luckyowl20/cert_rocket/gpt_context/outputs/footprint_assignment/comparator_land.png

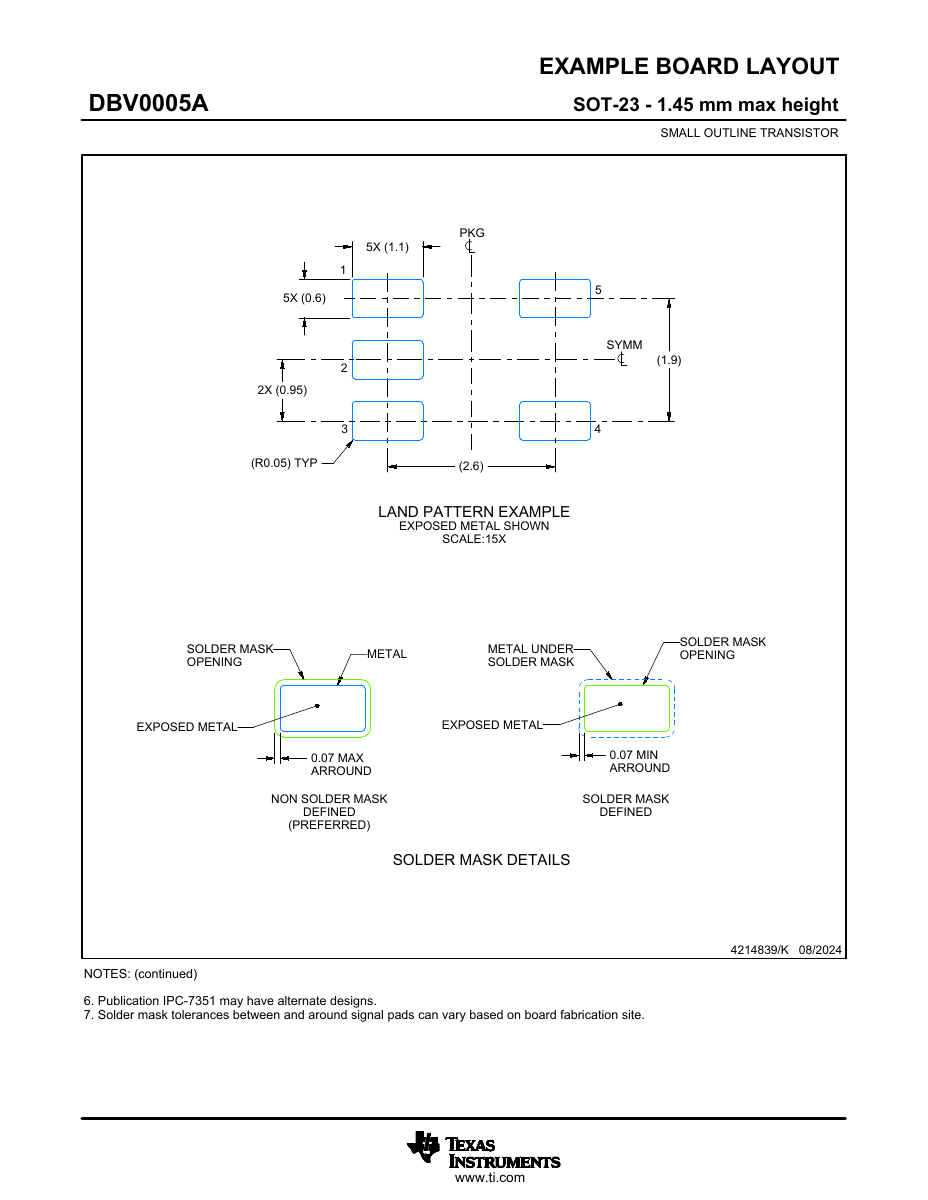
gpt_context/outputs/footprint_assignment/comparator_land.png
