luckyowl20/cert_rocket/gpt_context/outputs/footprint_assignment/d4_dims.png

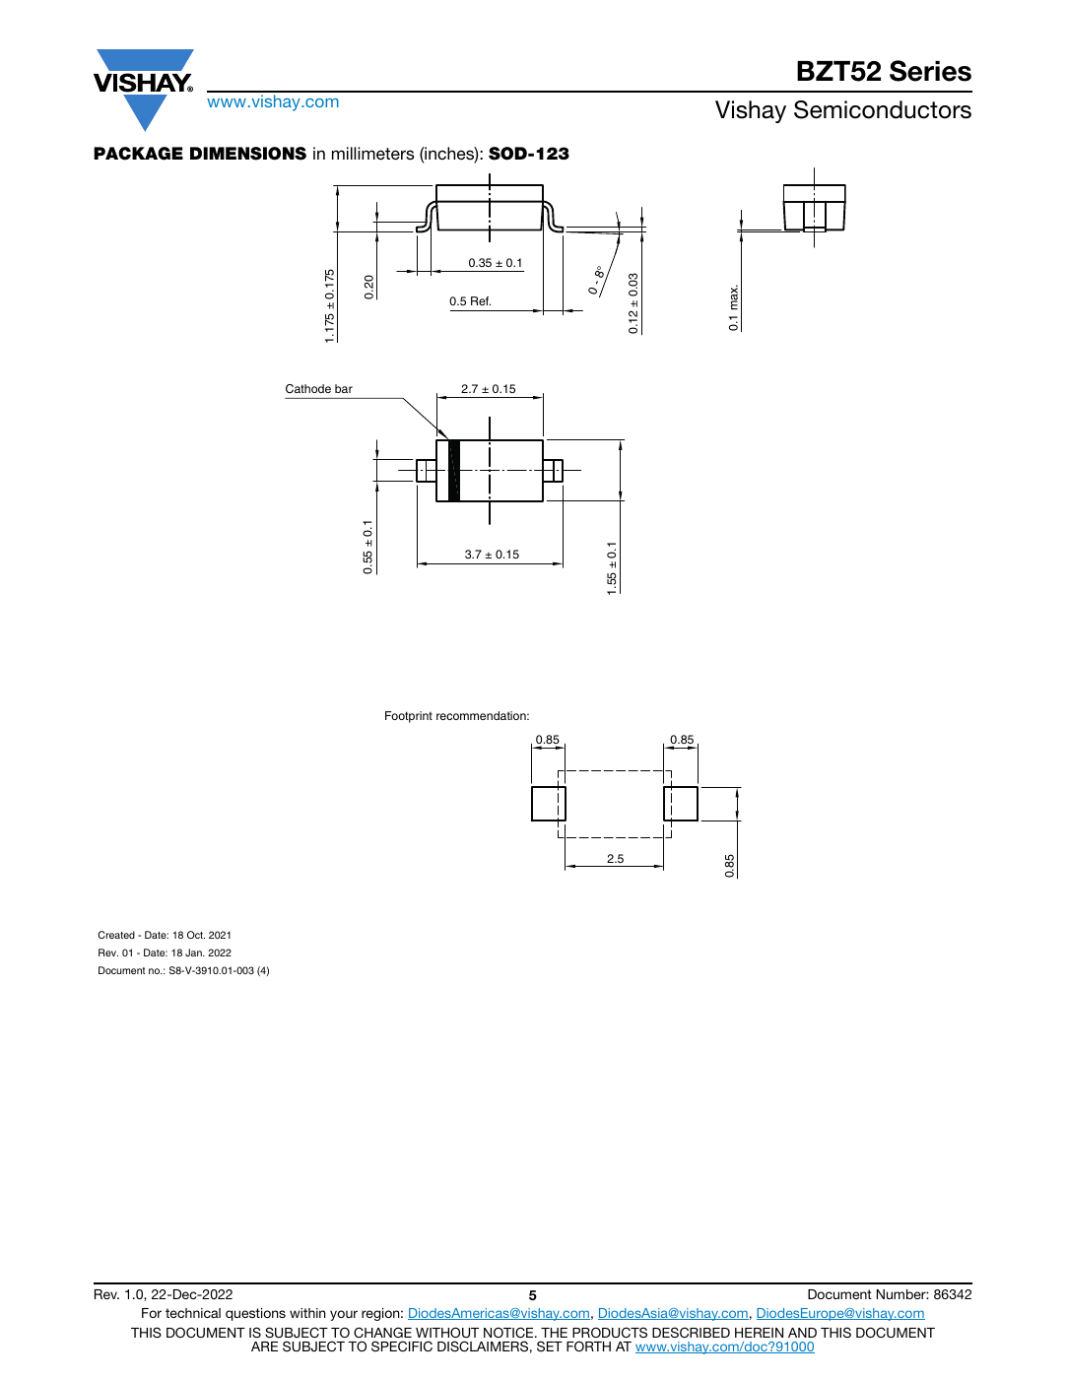
gpt_context/outputs/footprint_assignment/d4_dims.png
