luckyowl20/cert_rocket/gpt_context/outputs/footprint_assignment/d4_package.png

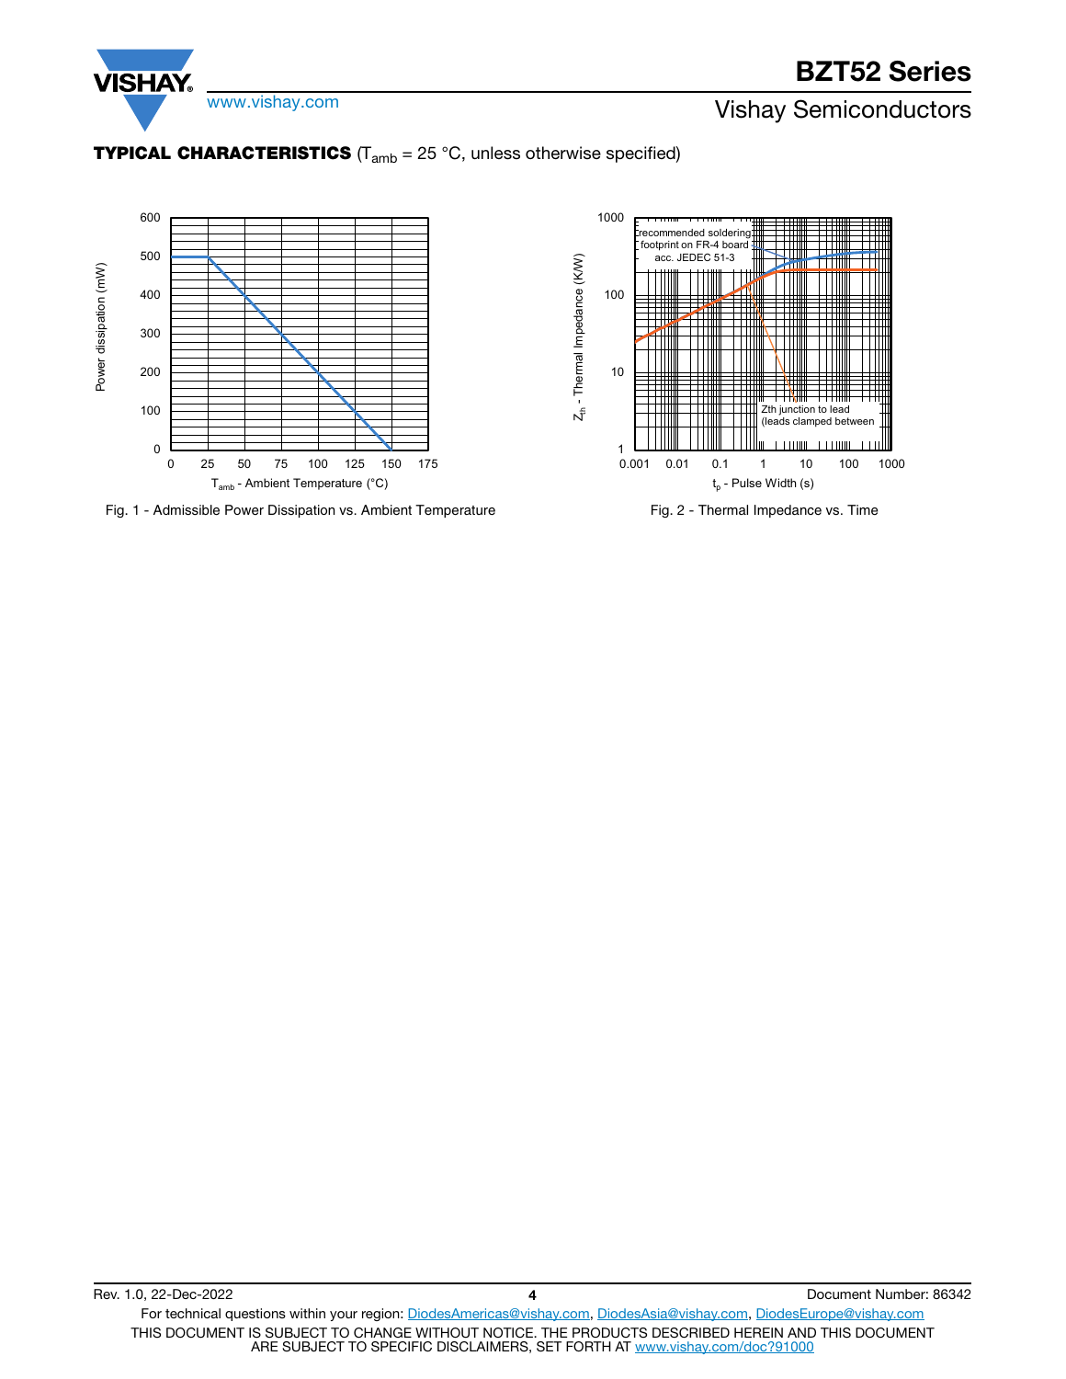
gpt_context/outputs/footprint_assignment/d4_package.png
