luckyowl20/cert_rocket/gpt_context/outputs/footprint_assignment/inspection_iso.png

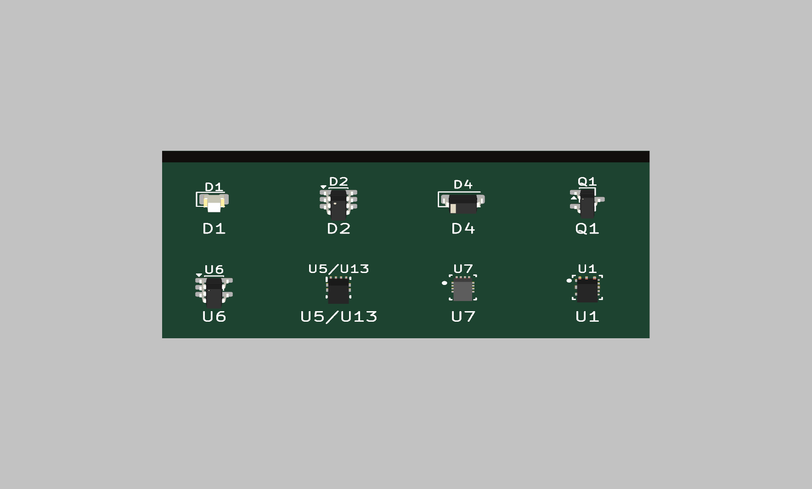
gpt_context/outputs/footprint_assignment/inspection_iso.png
