luckyowl20/cert_rocket/gpt_context/outputs/footprint_assignment/inspection_top.png

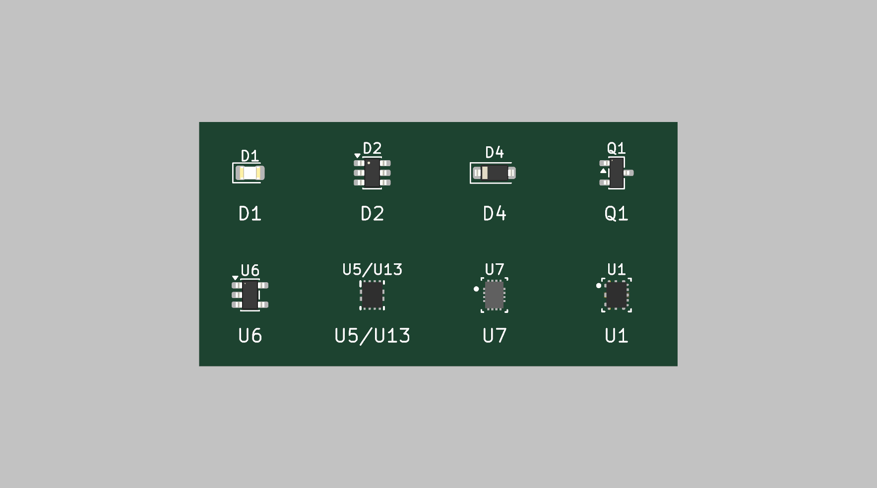
gpt_context/outputs/footprint_assignment/inspection_top.png
