luckyowl20/cert_rocket/gpt_context/outputs/footprint_assignment/led_package.png

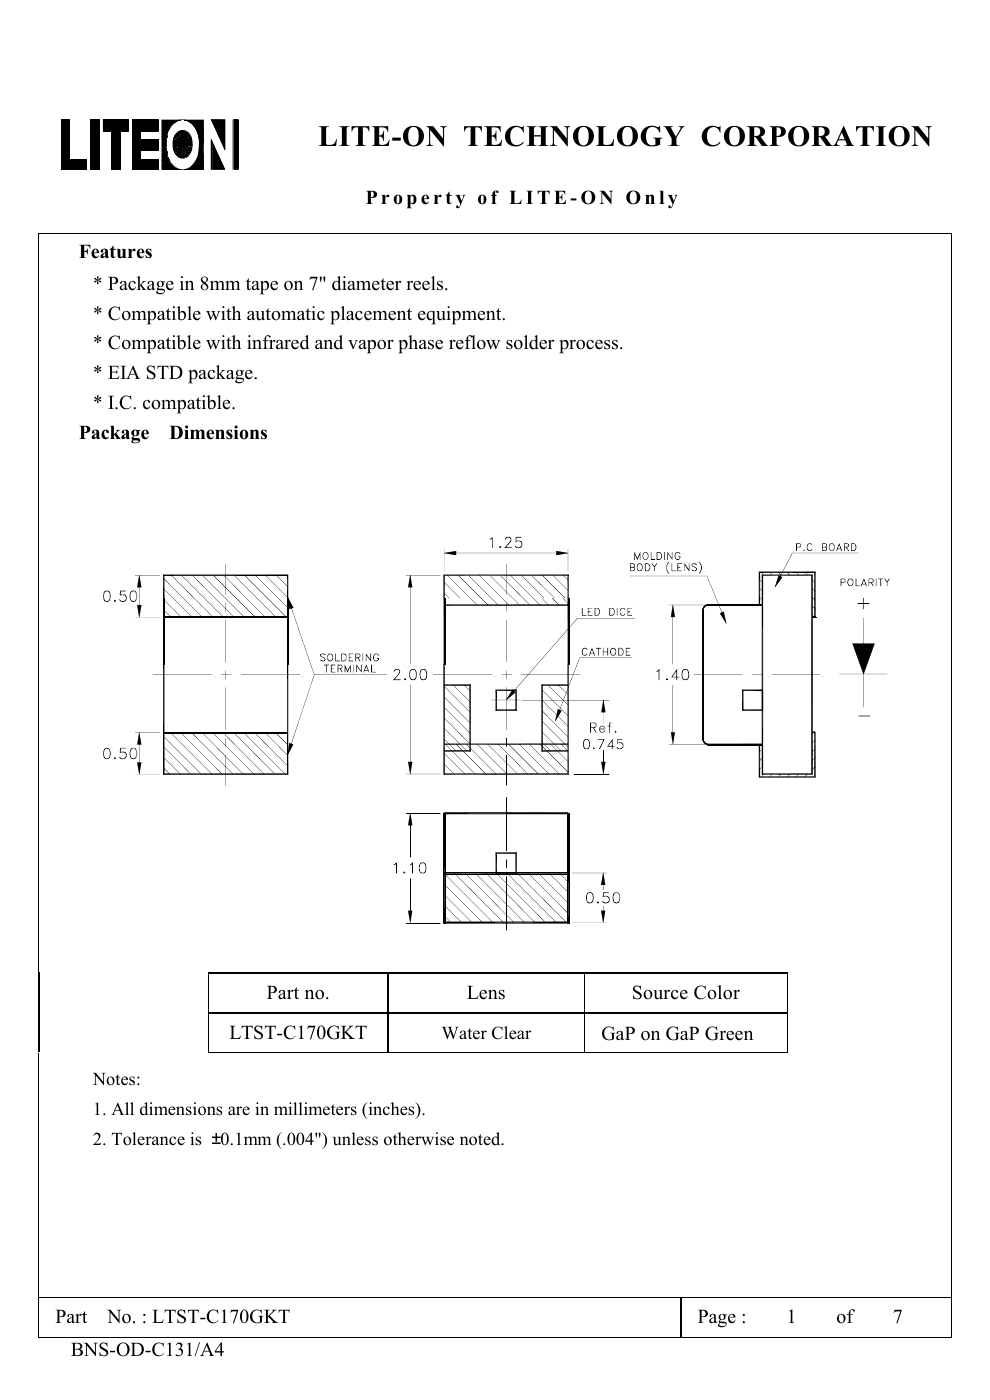
gpt_context/outputs/footprint_assignment/led_package.png
