luckyowl20/cert_rocket/gpt_context/outputs/footprint_assignment/rak_copper.png

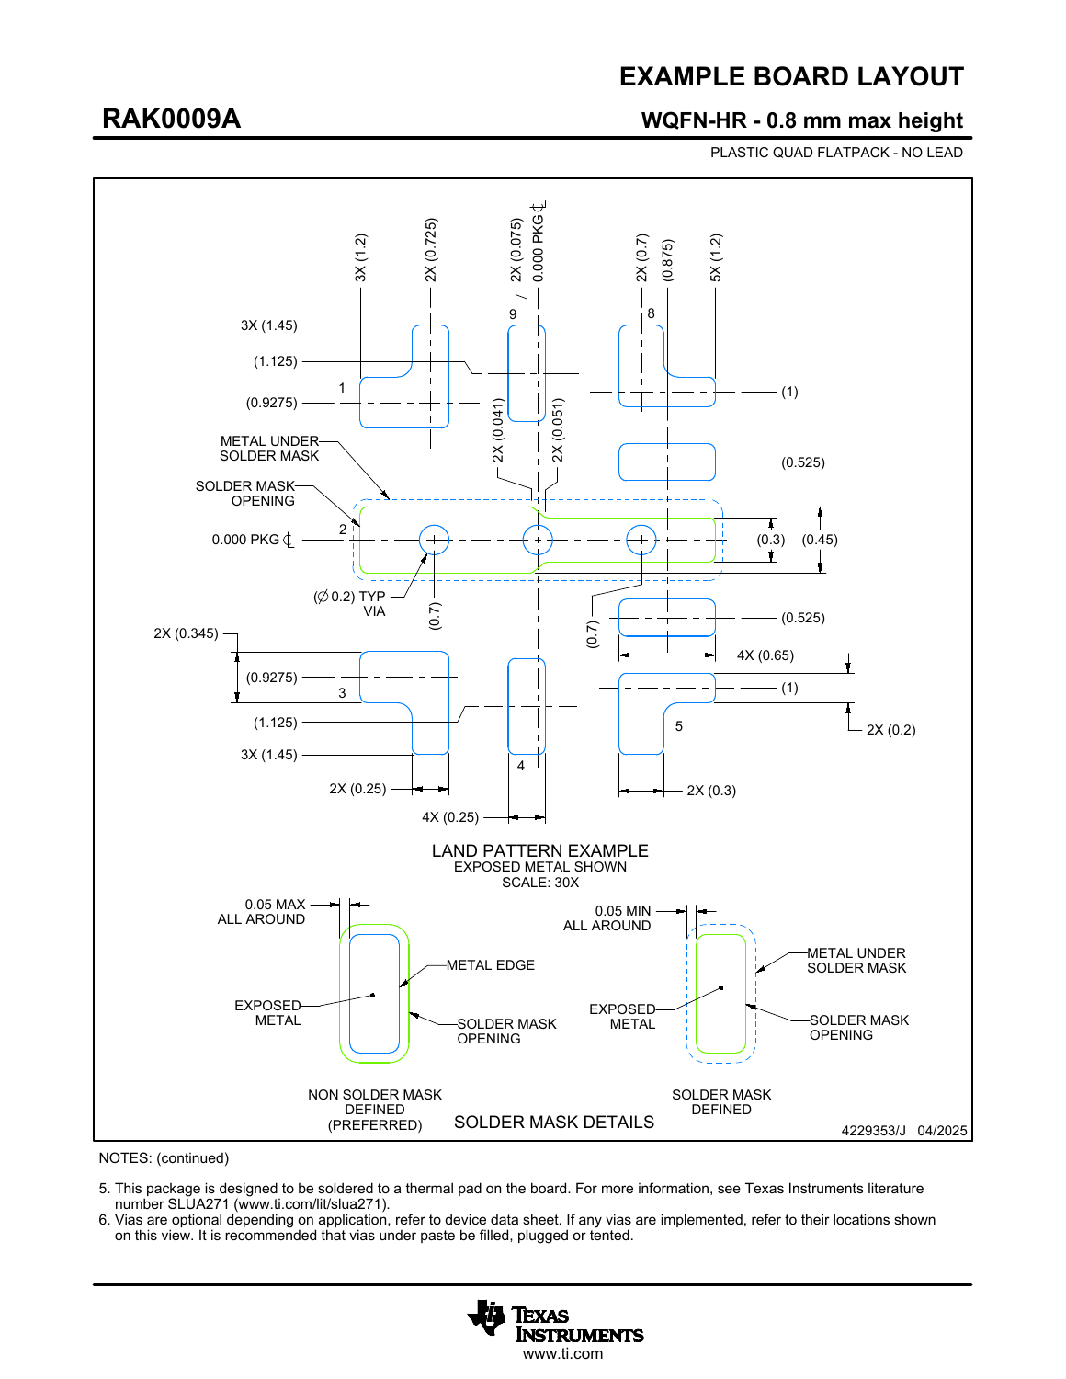
gpt_context/outputs/footprint_assignment/rak_copper.png
