luckyowl20/cert_rocket/gpt_context/outputs/footprint_assignment/tmux_land.png

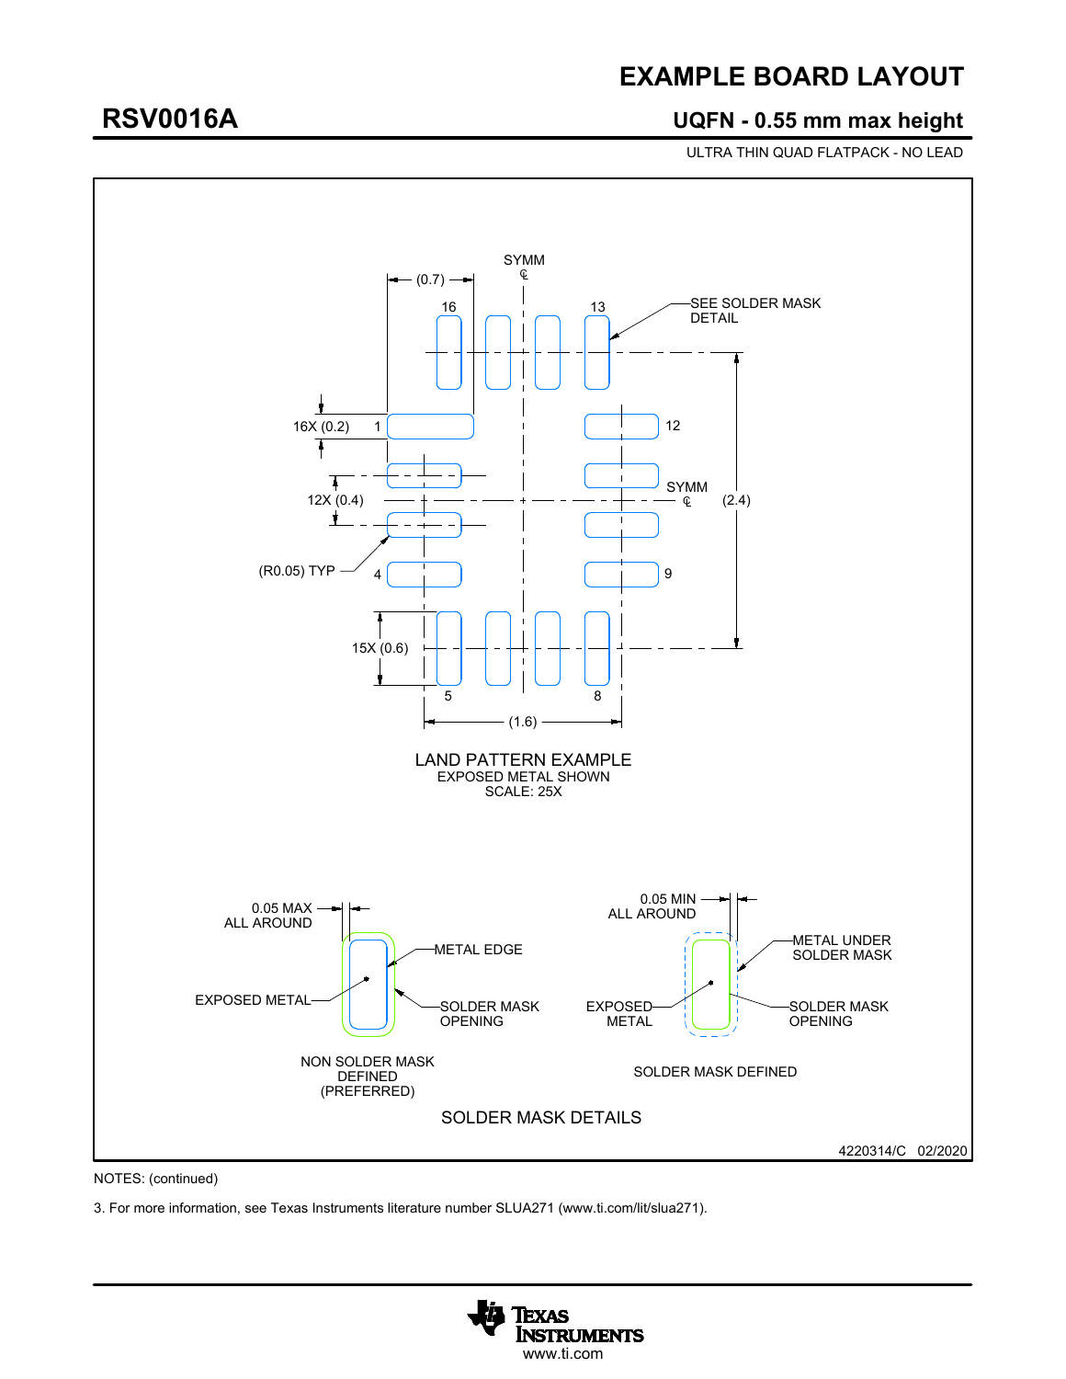
gpt_context/outputs/footprint_assignment/tmux_land.png
