luckyowl20/cert_rocket/gpt_context/outputs/footprint_assignment/tps_land.png

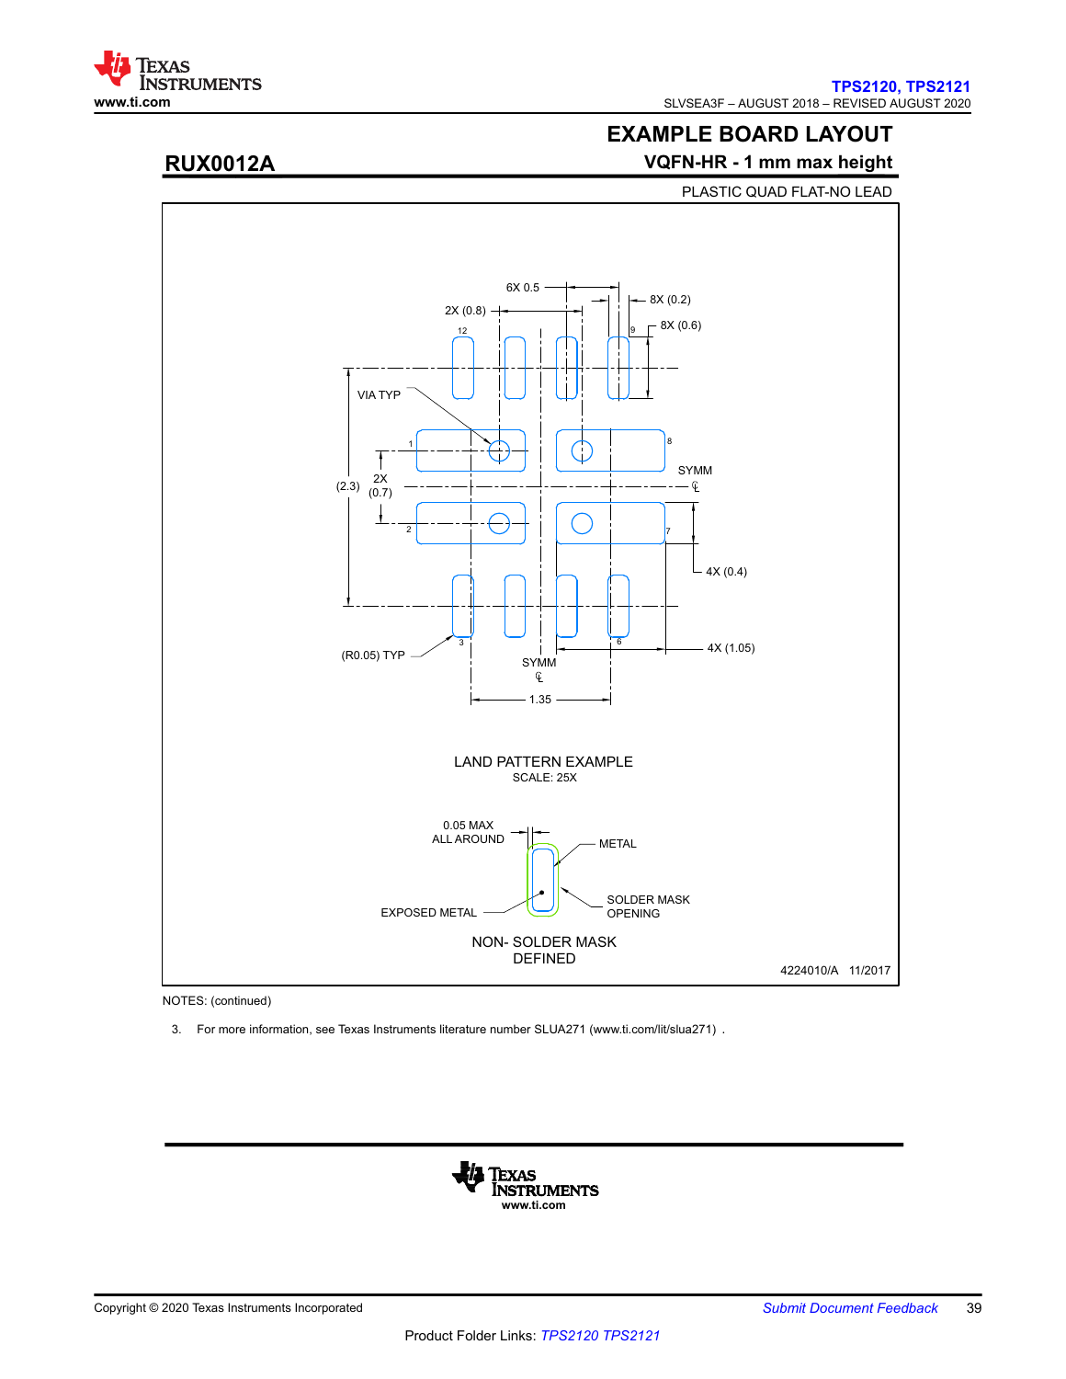
gpt_context/outputs/footprint_assignment/tps_land.png
