luckyowl20/cert_rocket/gpt_context/outputs/logic_power/logic_power_single_sheet.png

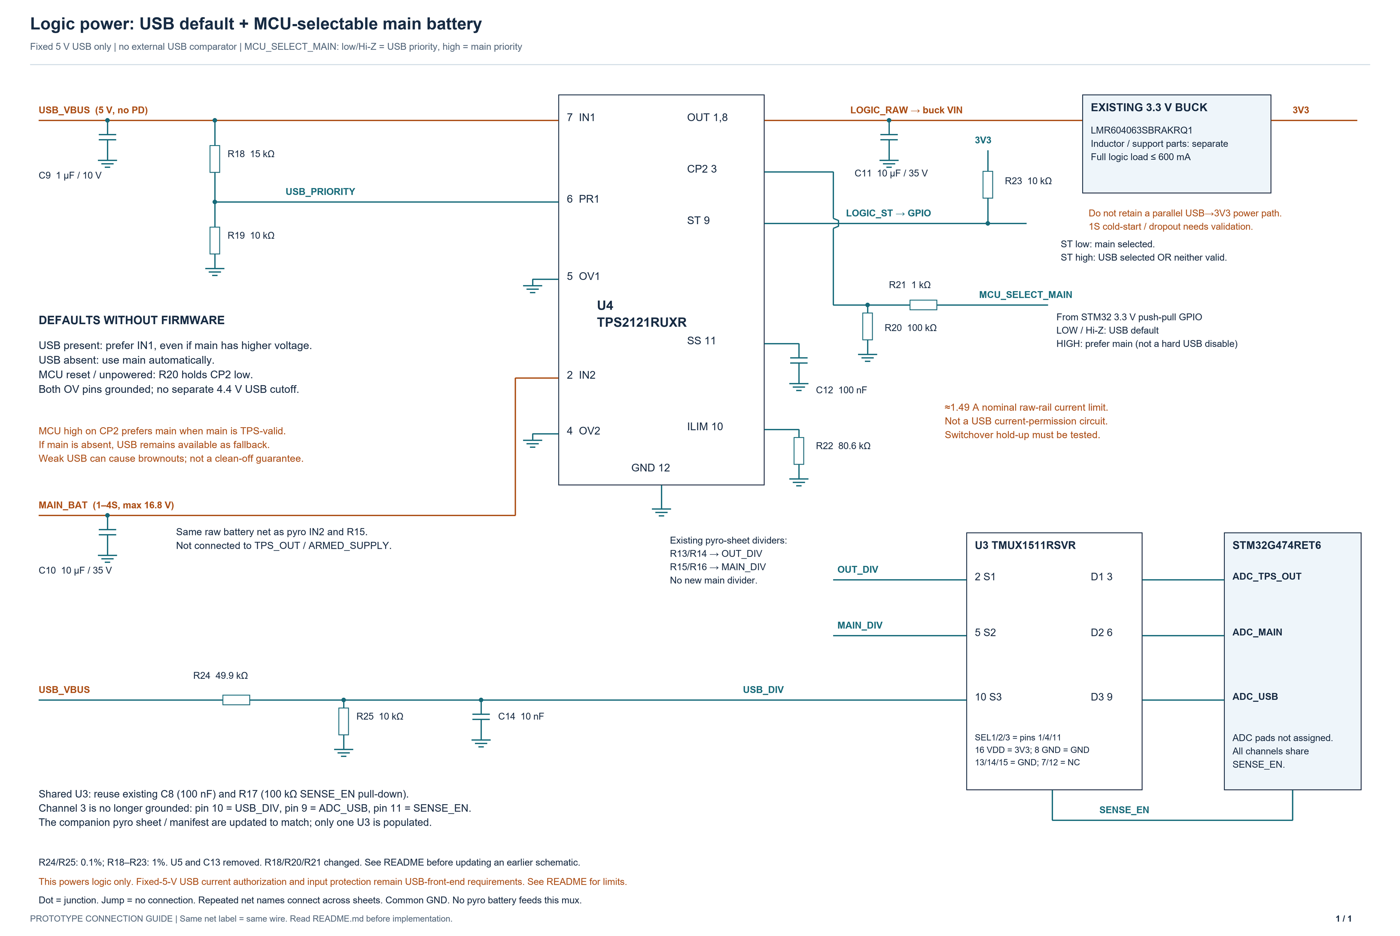
gpt_context/outputs/logic_power/logic_power_single_sheet.png
