luckyowl20/cert_rocket/gpt_context/outputs/pyro_power/01_power_mux.png

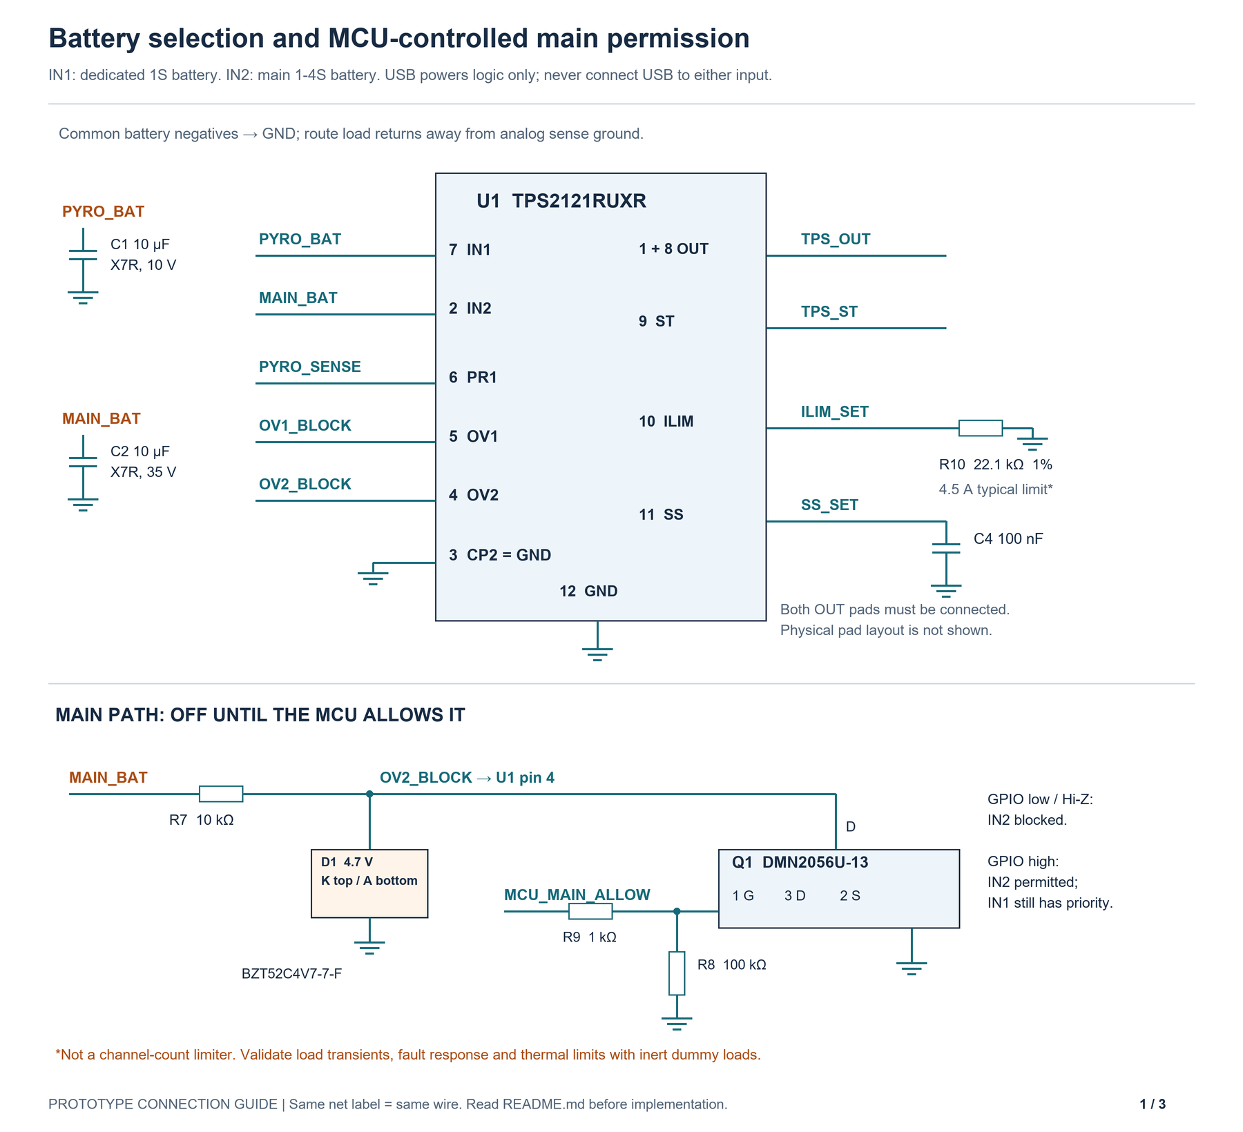
gpt_context/outputs/pyro_power/01_power_mux.png
