luckyowl20/cert_rocket/gpt_context/outputs/pyro_power/02_comparator_threshold.png

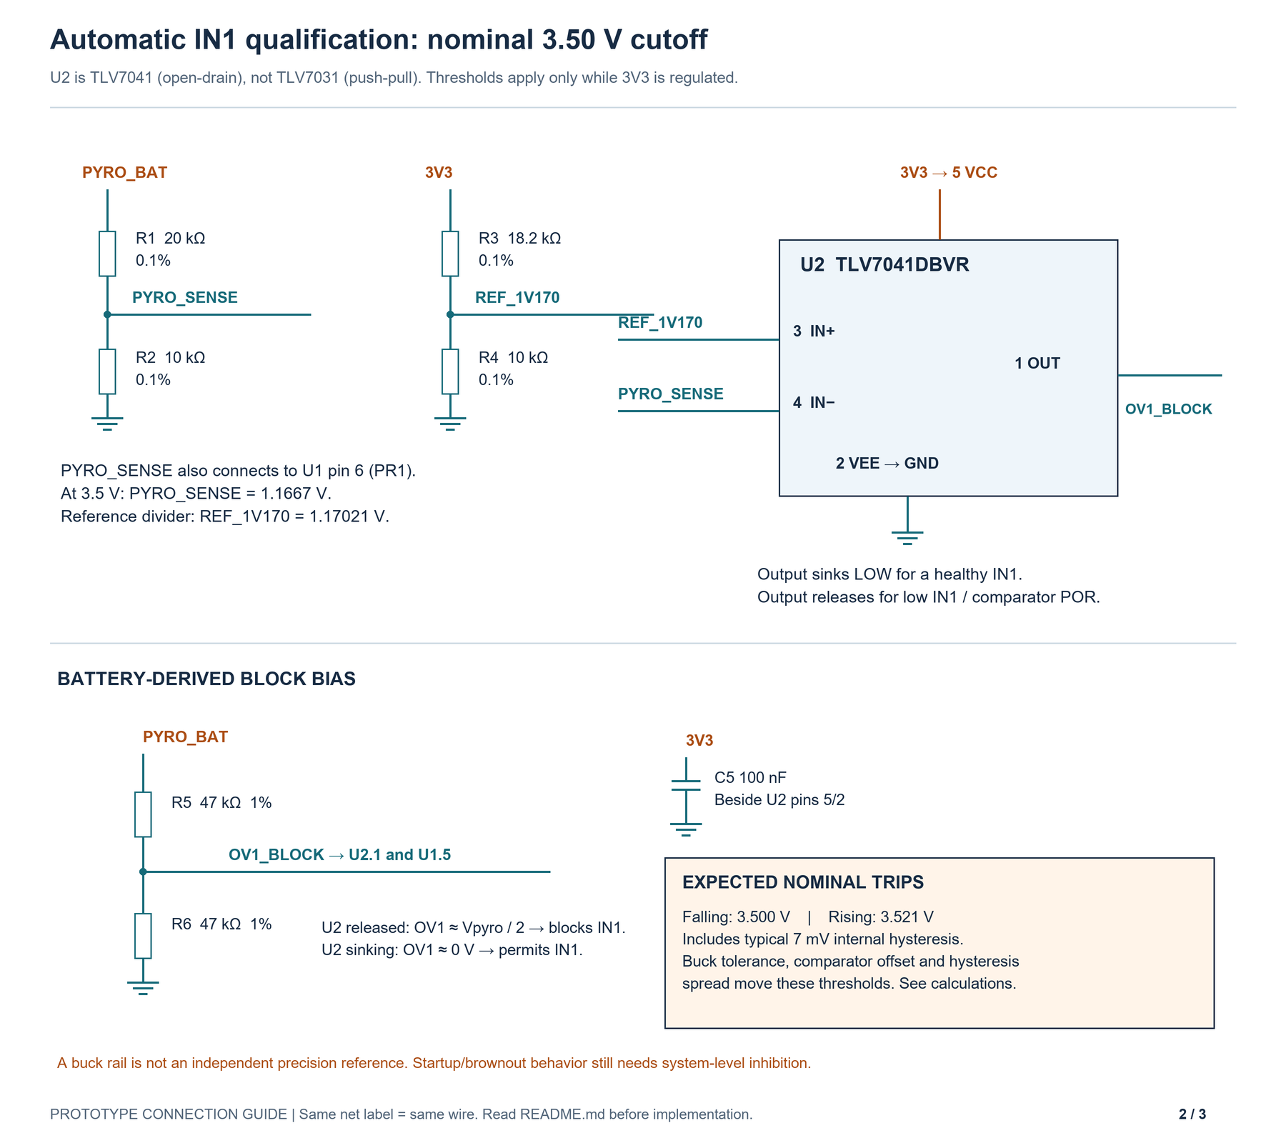
gpt_context/outputs/pyro_power/02_comparator_threshold.png
