luckyowl20/cert_rocket/gpt_context/outputs/pyro_power/03_monitor_and_inhibit.png

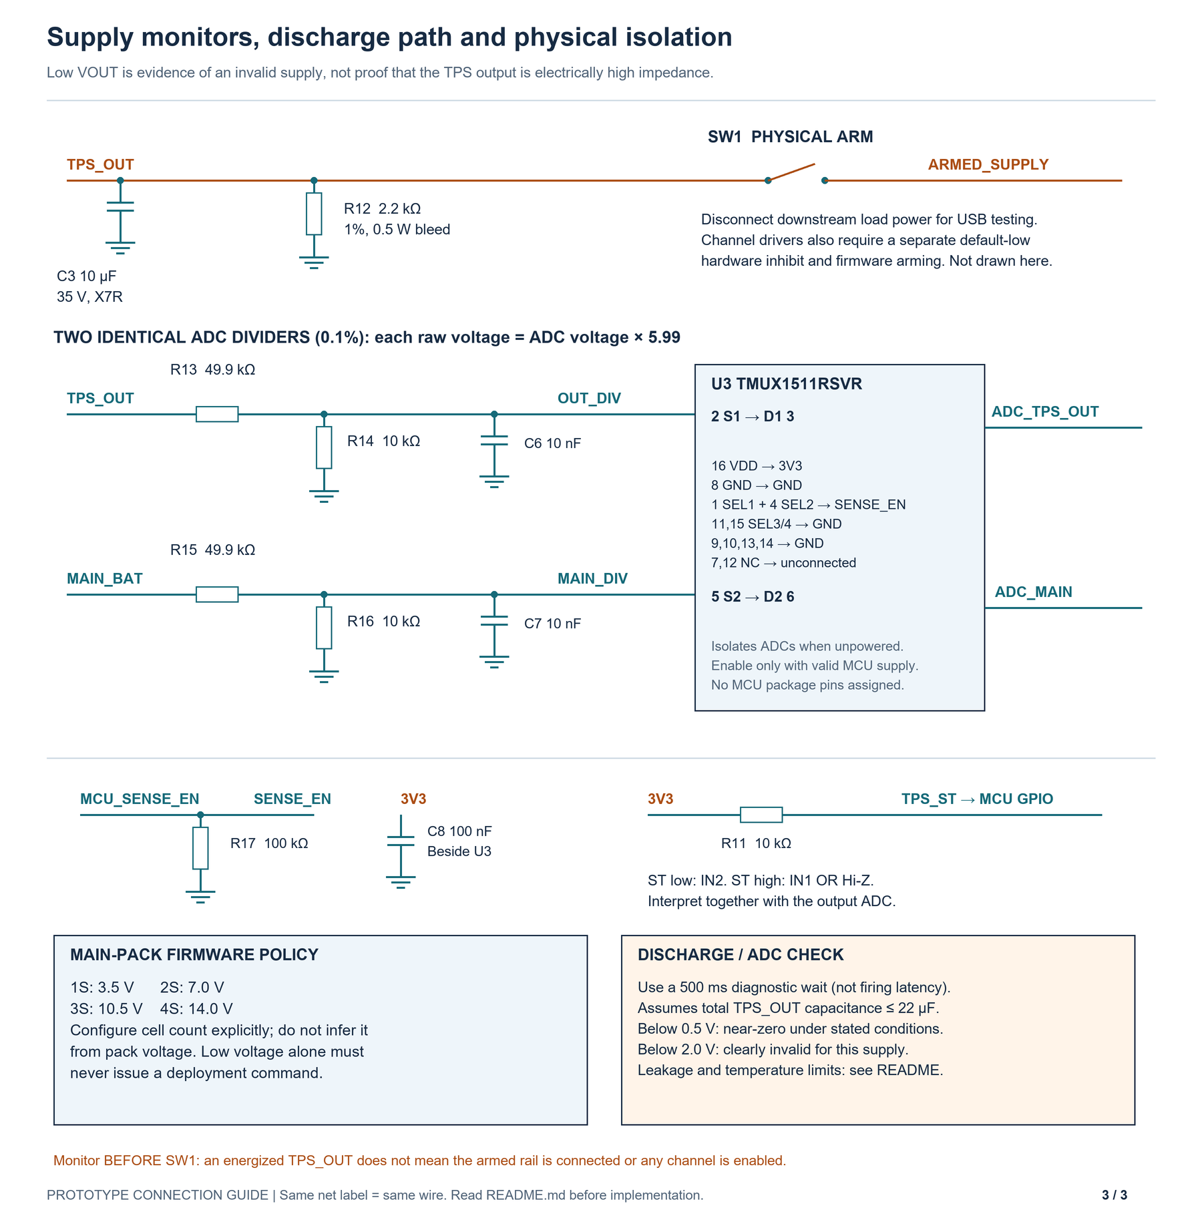
gpt_context/outputs/pyro_power/03_monitor_and_inhibit.png
