luckyowl20/cert_rocket/gpt_context/outputs/pyro_power/pyro_power_single_sheet.png

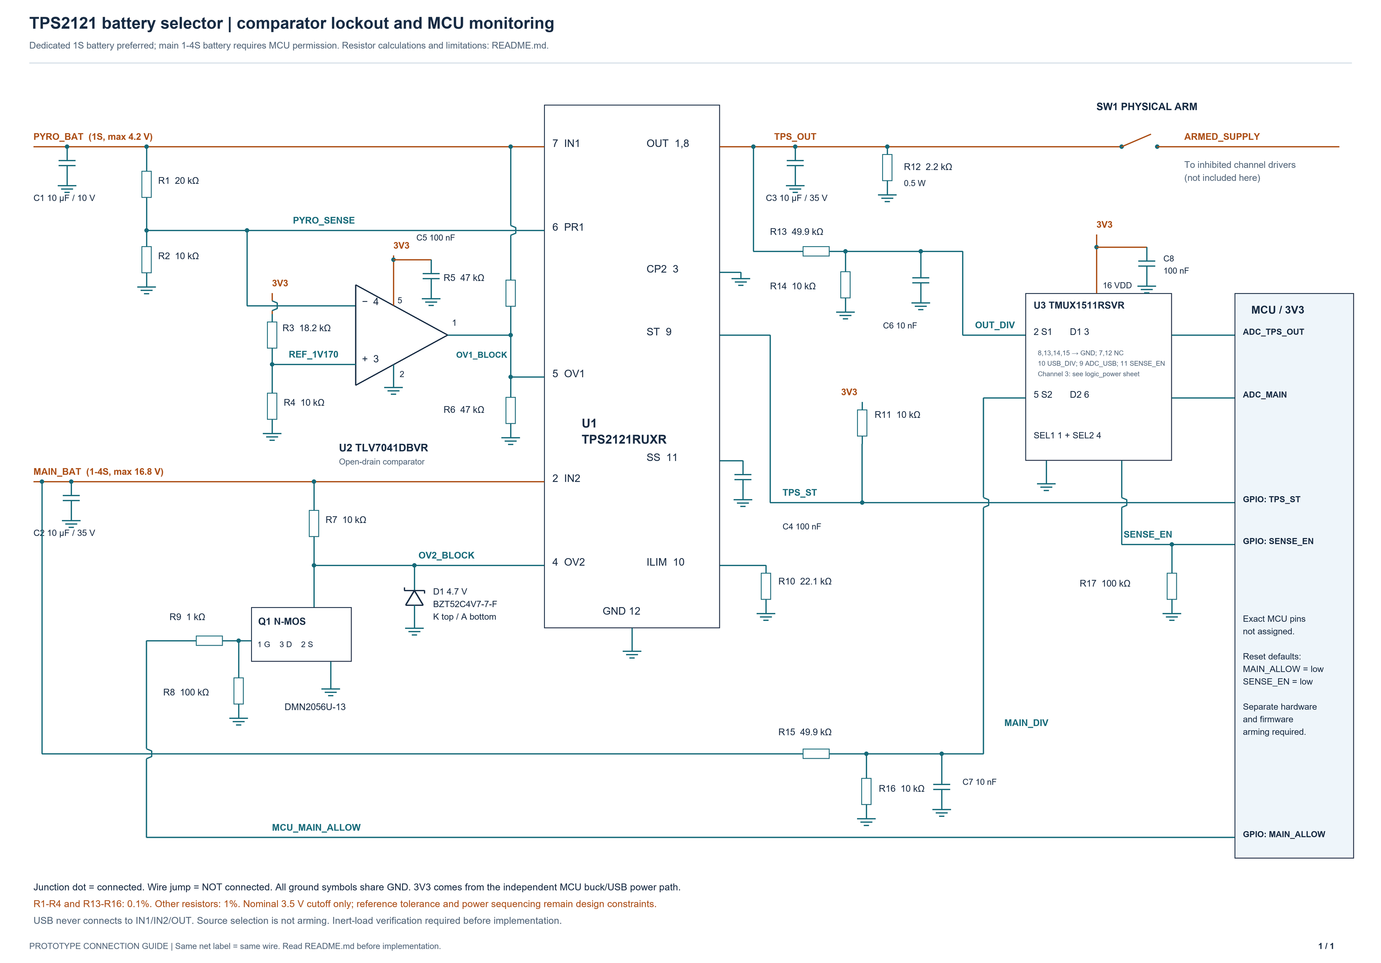
gpt_context/outputs/pyro_power/pyro_power_single_sheet.png
