luckyowl20/cert_rocket/gpt_context/outputs/usb_c/01_usb_connections.png

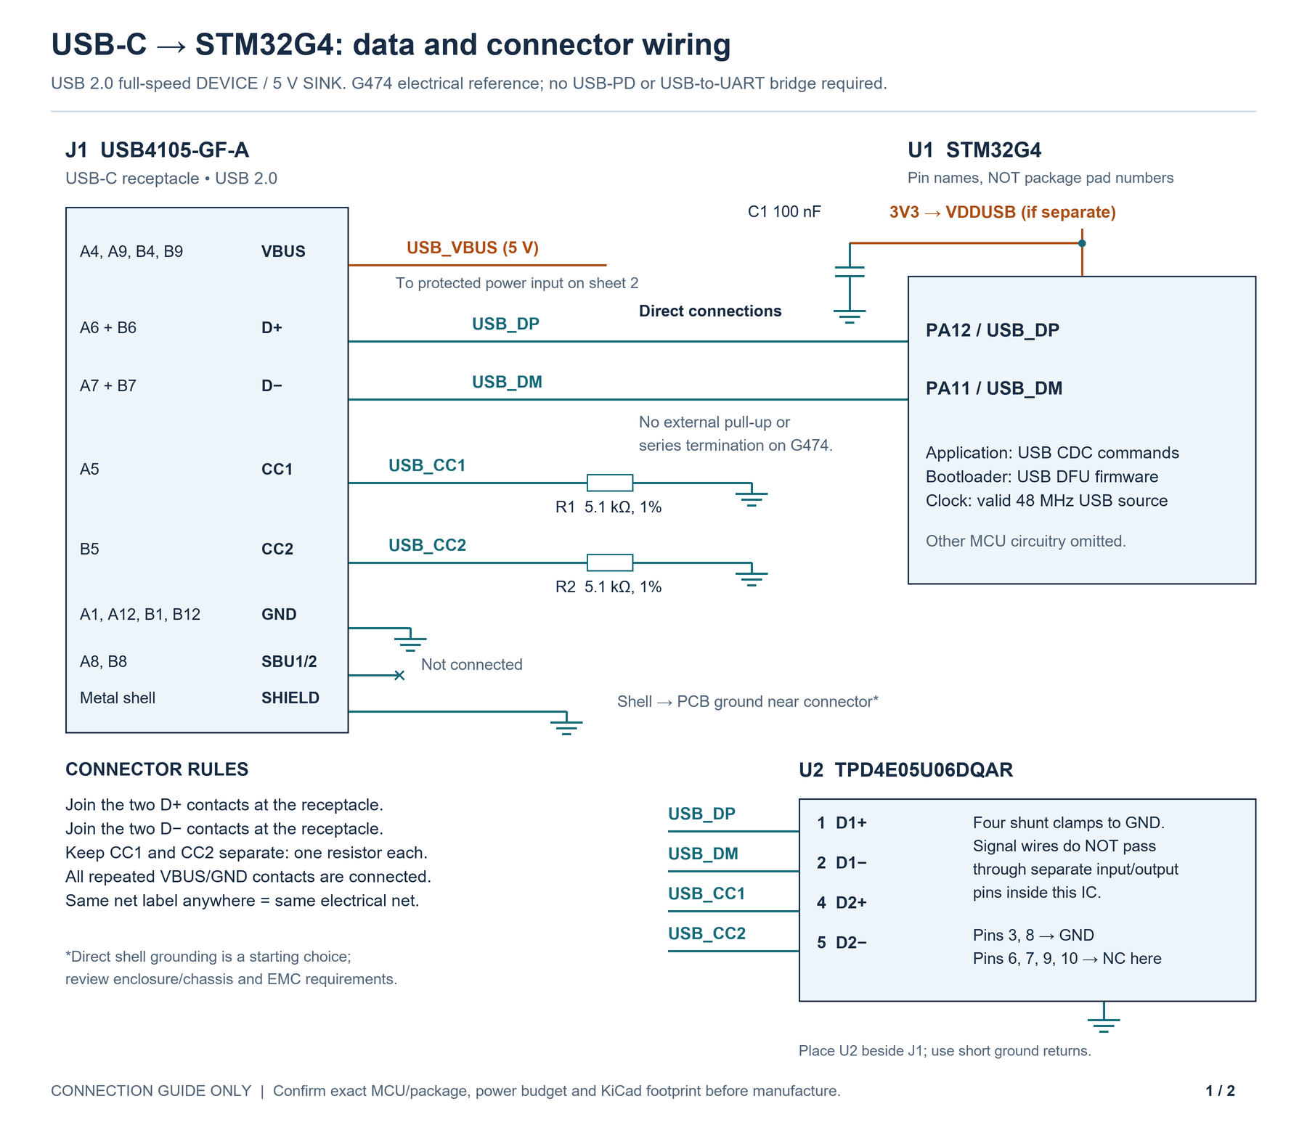
gpt_context/outputs/usb_c/01_usb_connections.png
