luckyowl20/cert_rocket/gpt_context/tmp/pdfs/comparator-pins.png

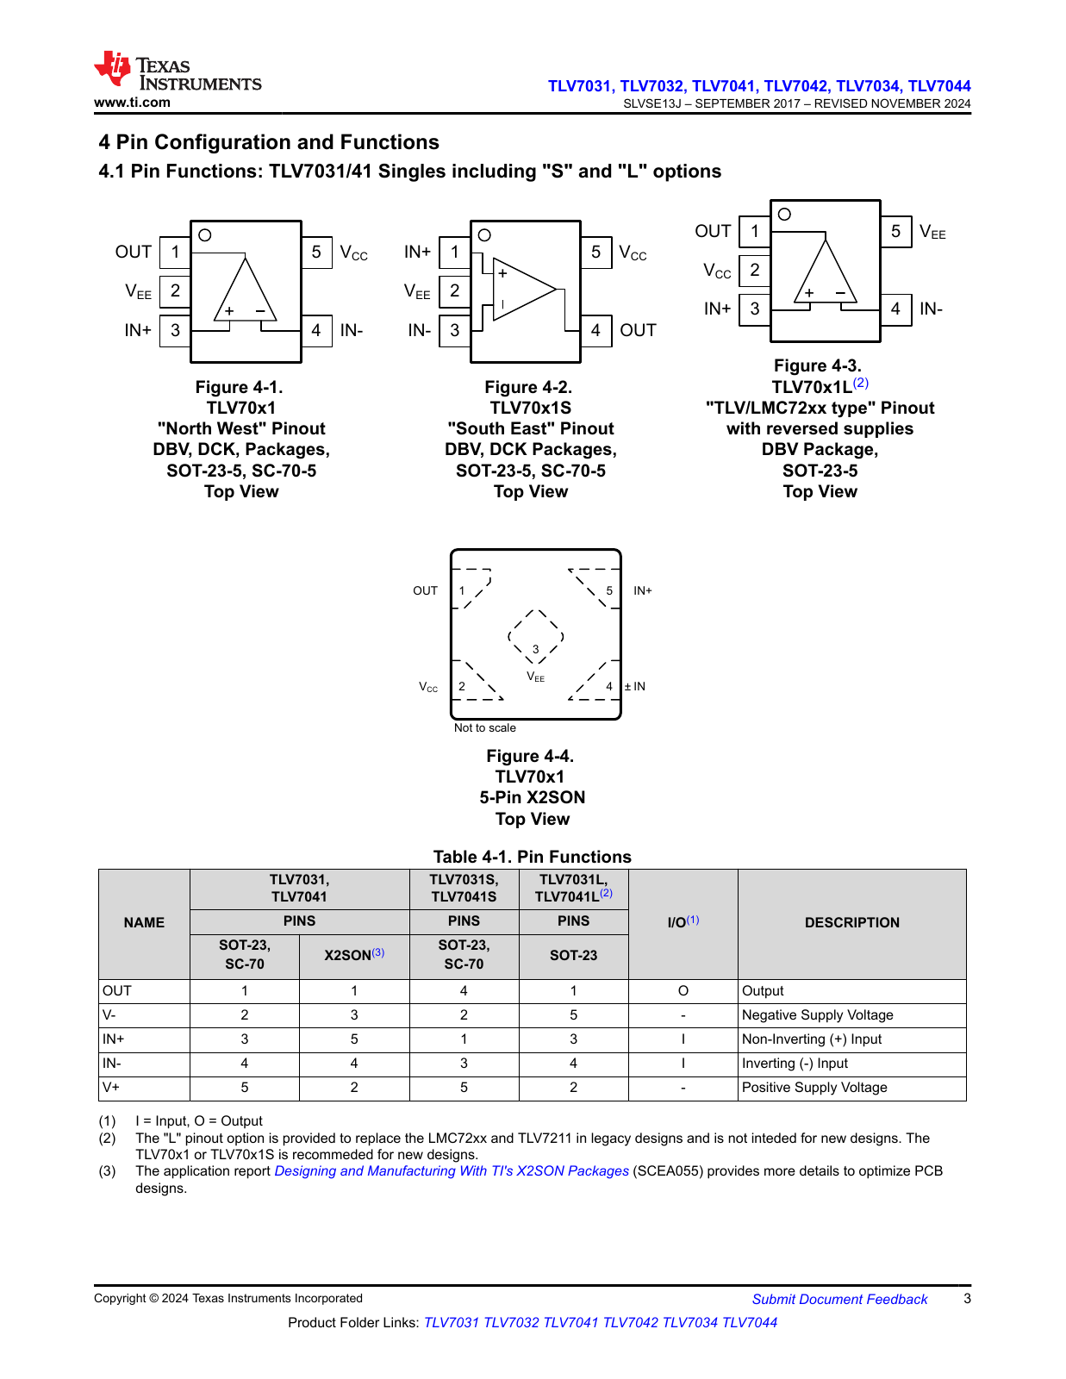
gpt_context/tmp/pdfs/comparator-pins.png
