luckyowl20/cert_rocket/gpt_context/tmp/pdfs/telemega-1.png

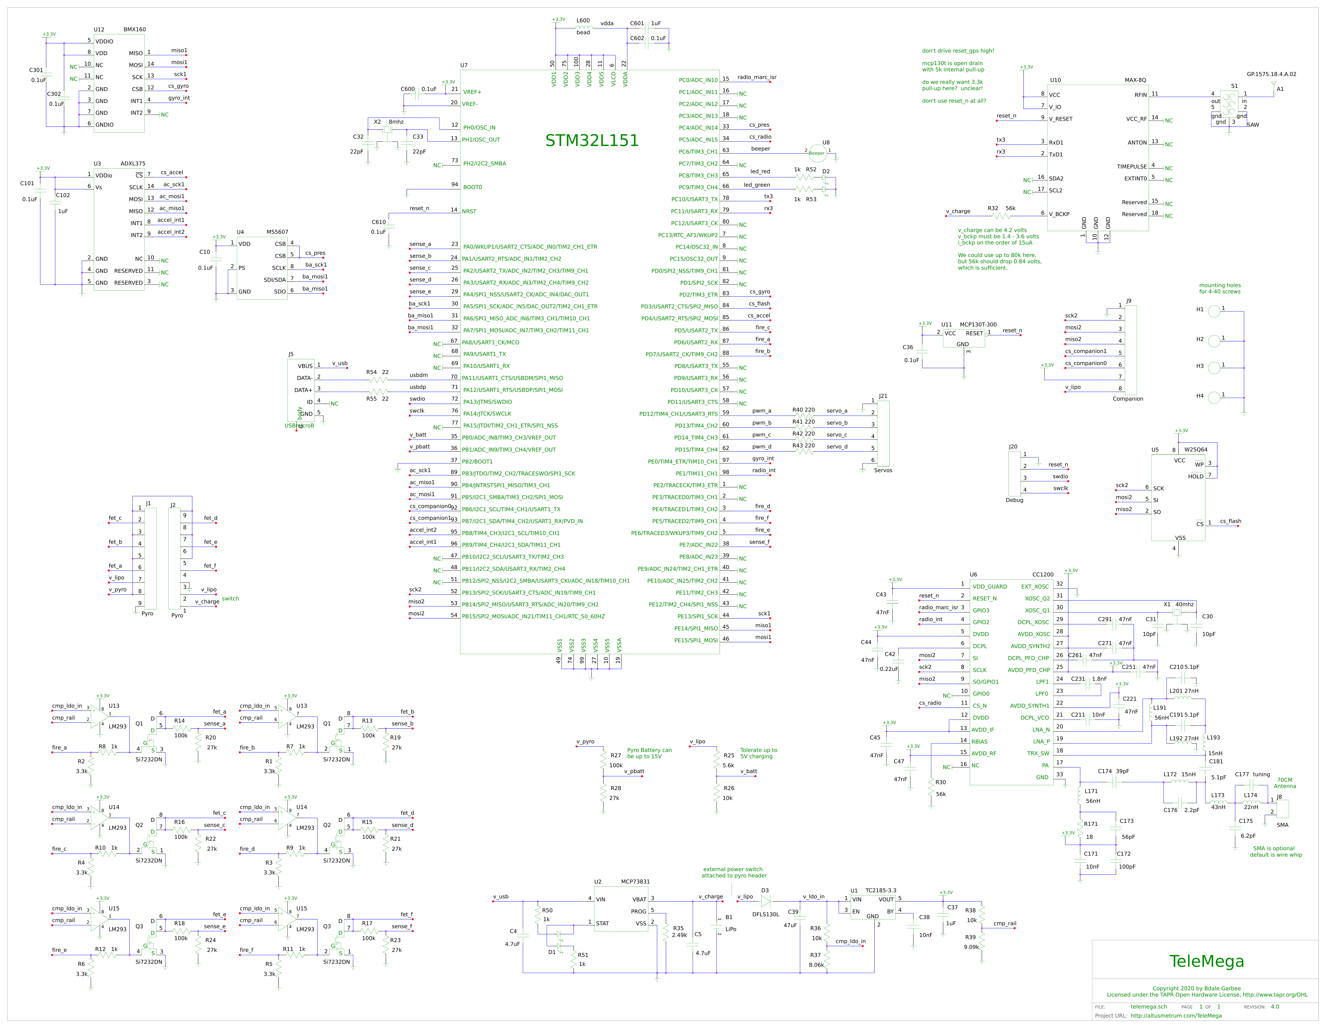
gpt_context/tmp/pdfs/telemega-1.png
