luckyowl20/cert_rocket/gpt_context/tmp/pdfs/telemega-pyro-crop.png

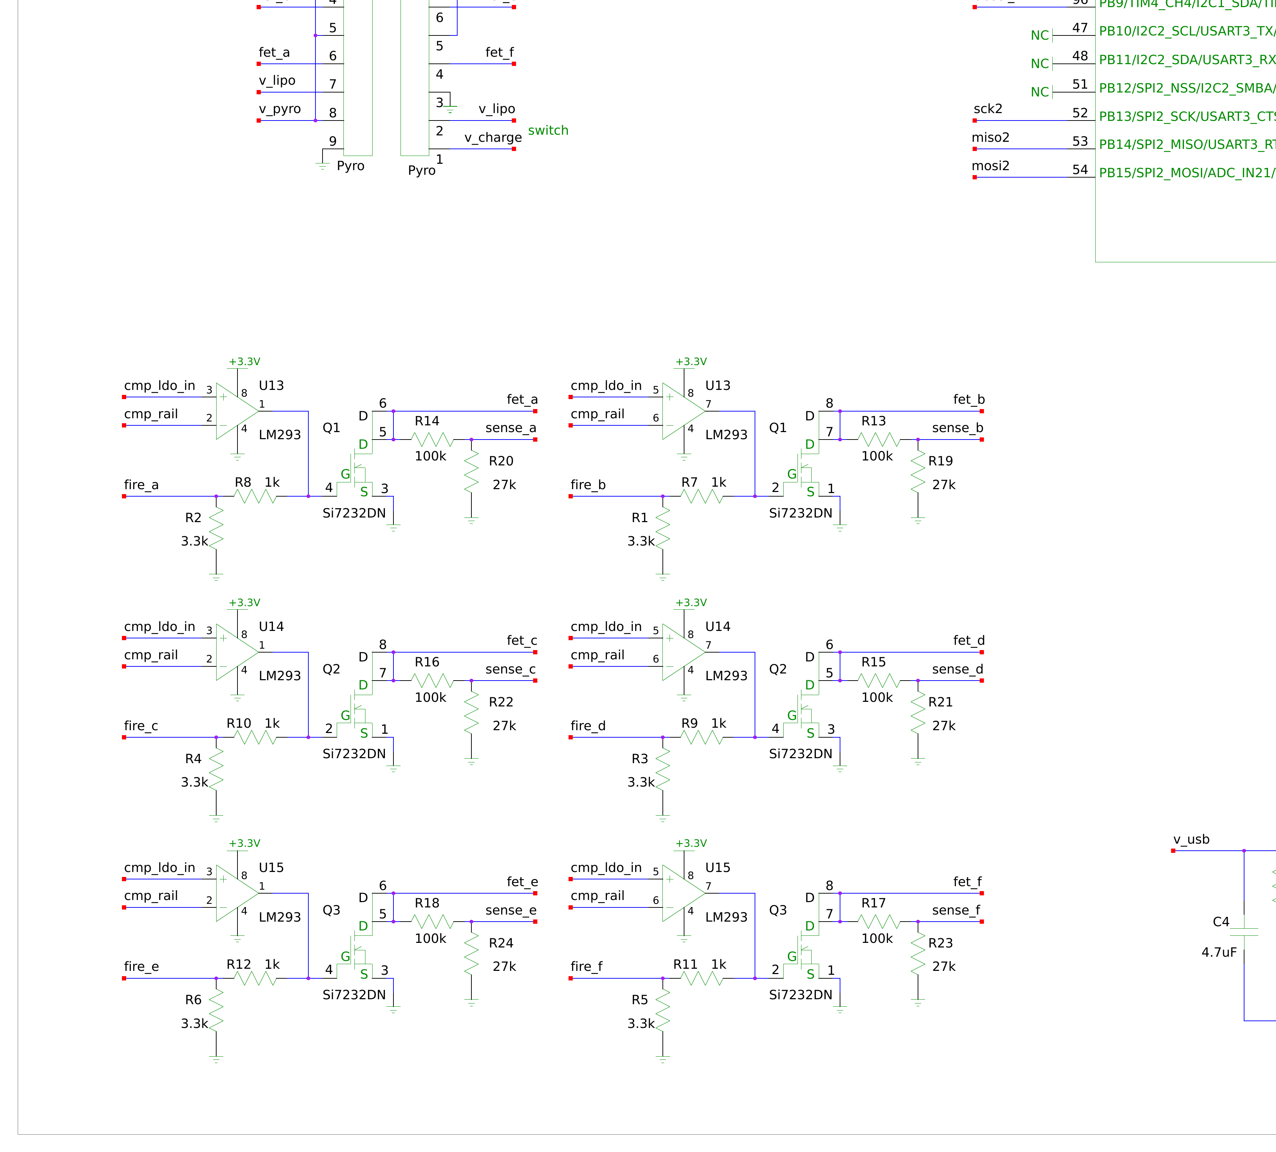
gpt_context/tmp/pdfs/telemega-pyro-crop.png
