luckyowl20/cert_rocket/gpt_context/tmp/pdfs/tps-logic.png

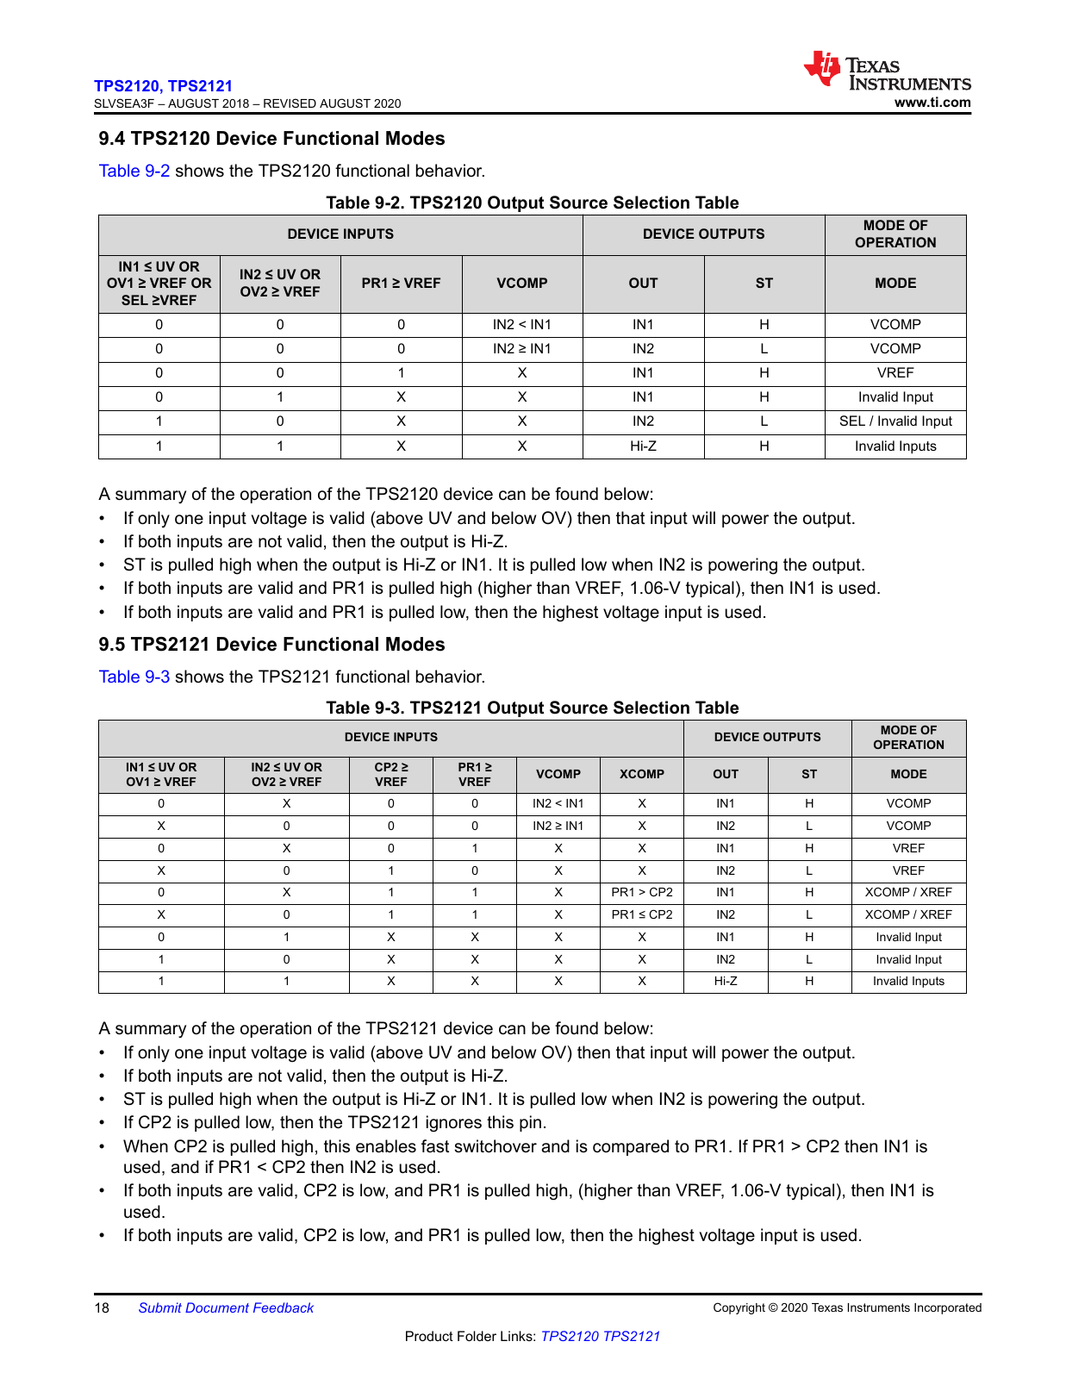
gpt_context/tmp/pdfs/tps-logic.png
