luckyowl20/cert_rocket/gpt_context/tmp/pdfs/tps-pins.png

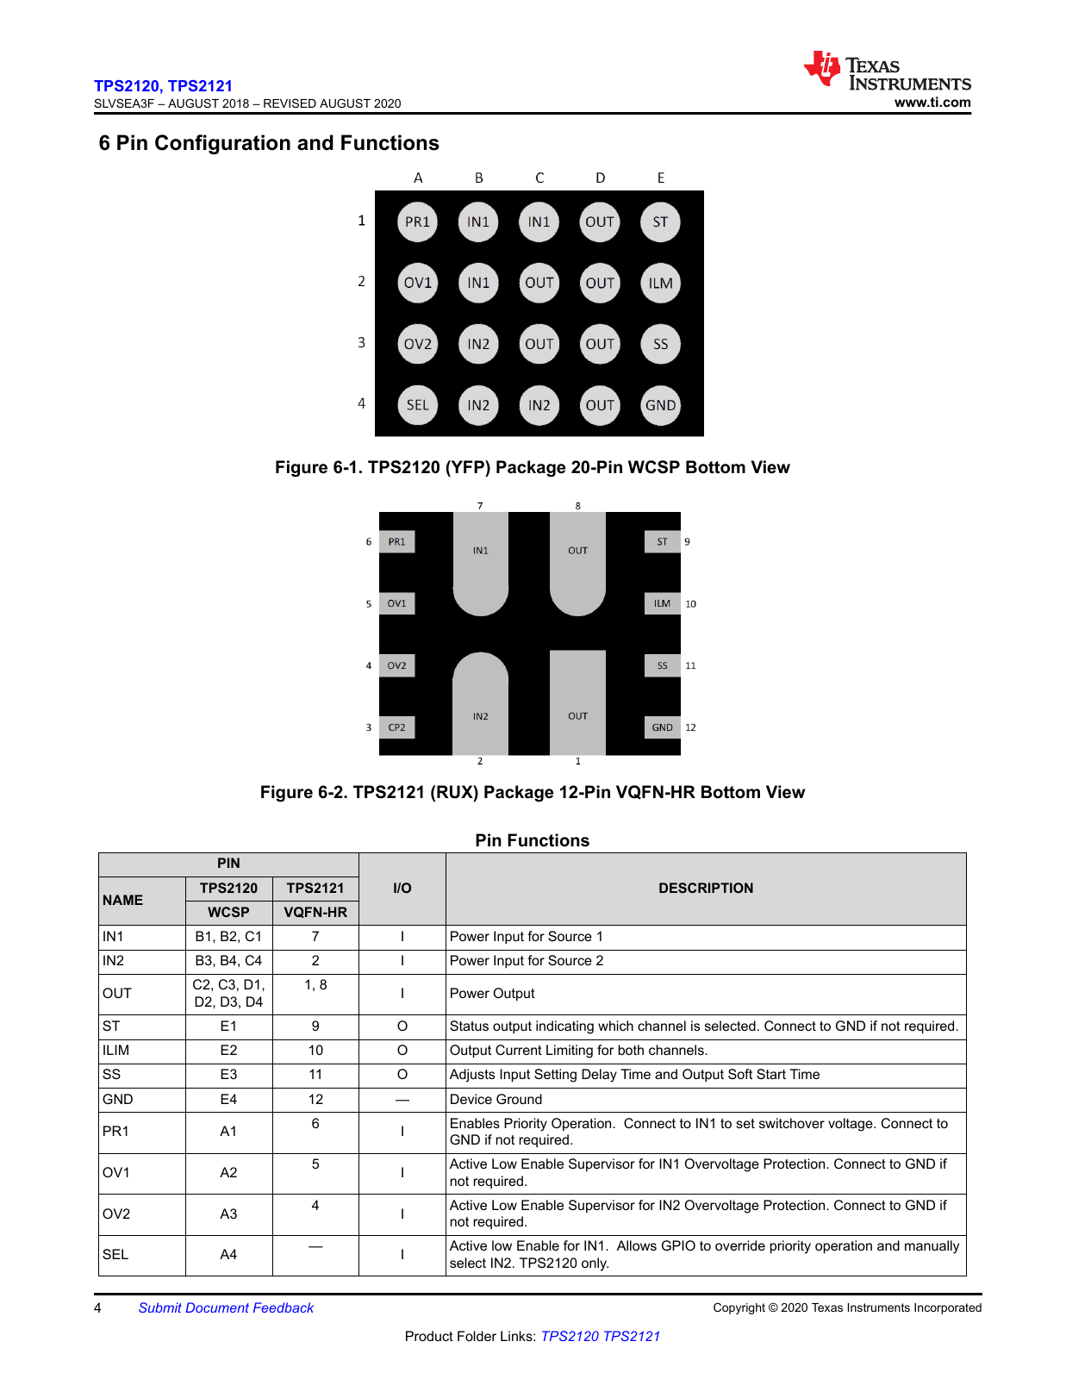
gpt_context/tmp/pdfs/tps-pins.png
