luckyowl20/cert_rocket/avionics/avionics_rev1/footprint_3D_models/SIS932EDN_PowerPAK1212_Dual.step

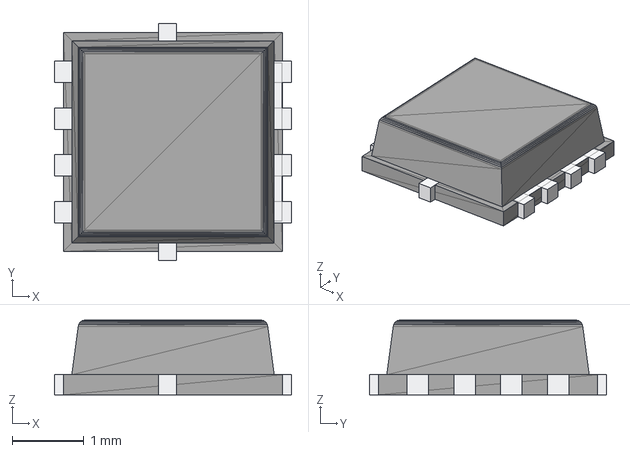
[picture p22: CAD file, 2026-10-29]
avionics/avionics_rev1/footprint_3D_models/SIS932EDN_PowerPAK1212_Dual.step
3.30 x 3.30 x 1.04 mm
