luckyowl20/cert_rocket/avionics/downloads/PS1240P02BT/PS1240P02BT.step

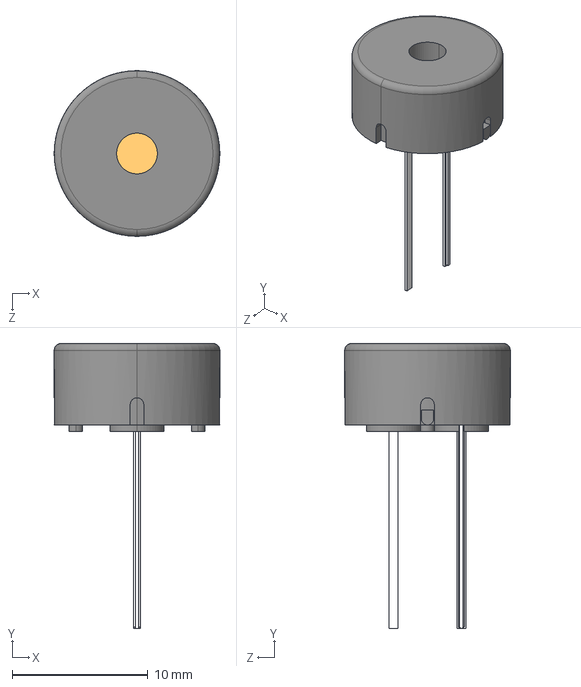
[picture p23: CAD file, 2026-06-30]
avionics/downloads/PS1240P02BT/PS1240P02BT.step
12.2 x 21.0 x 12.2 mm
