luckyowl20/cert_rocket/gpt_context/outputs/footprint_assignment/footprint_3D_models/LED_0805_2012Metric.step

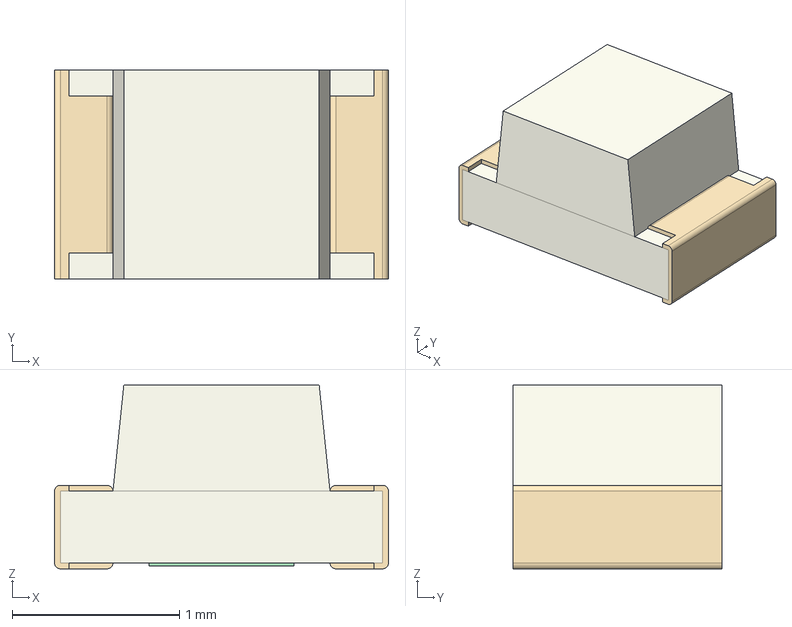
[picture p24: CAD file, 2026-09-24]
gpt_context/outputs/footprint_assignment/footprint_3D_models/LED_0805_2012Metric.step
2.00 x 1.25 x 1.10 mm
