luckyowl20/cert_rocket/gpt_context/outputs/footprint_assignment/staged/footprint_3D_models/D_SOD-123.step

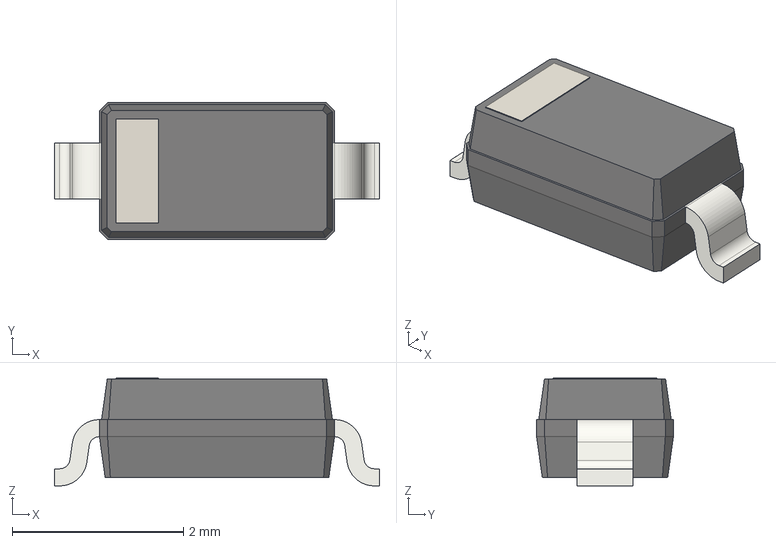
[picture p25: CAD file, 2026-09-24]
gpt_context/outputs/footprint_assignment/staged/footprint_3D_models/D_SOD-123.step
3.80 x 1.60 x 1.26 mm
