luckyowl20/cert_rocket/gpt_context/outputs/sensors_cleanup/staged/footprint_3D_models/CP_EIA-3216-18_Kemet-A.step

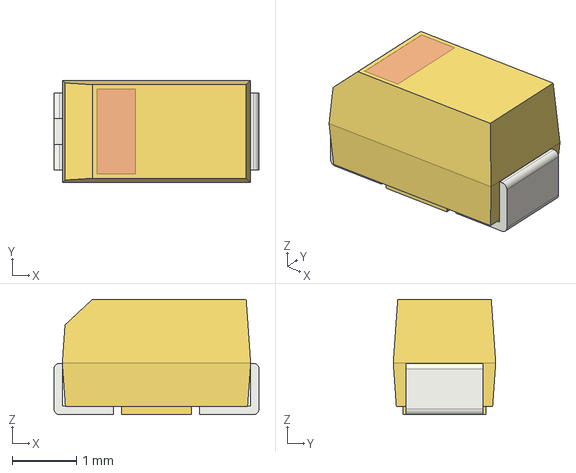
[picture p26: CAD file, 2026-09-24]
gpt_context/outputs/sensors_cleanup/staged/footprint_3D_models/CP_EIA-3216-18_Kemet-A.step
3.20 x 1.60 x 1.80 mm
