luckyowl20/cert_rocket/avionics/avionics_rev1/footprint_3D_models/Phoenix_1725711.step

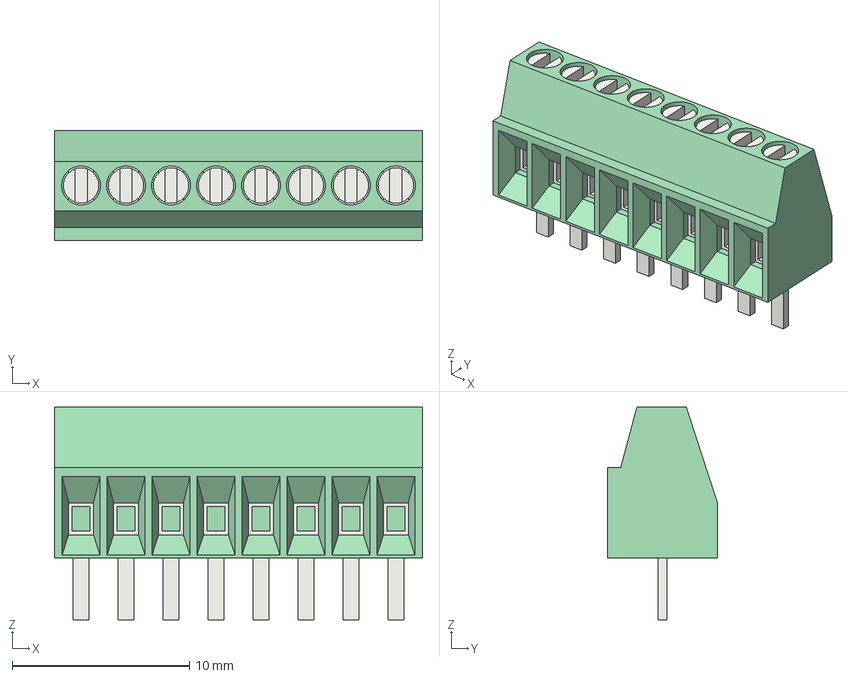
[picture p27: CAD file, 2026-10-02]
avionics/avionics_rev1/footprint_3D_models/Phoenix_1725711.step
20.8 x 6.20 x 12.0 mm
