luckyowl20/cert_rocket/gpt_context/outputs/footprint_assignment/staged/footprint_3D_models/SOT-23.step

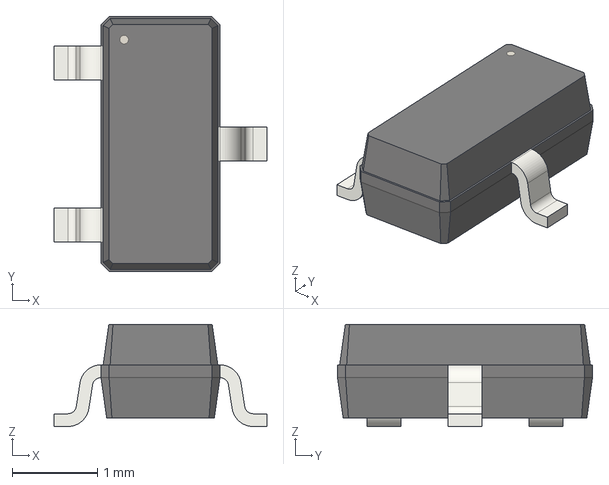
[picture p28: CAD file, 2026-09-24]
gpt_context/outputs/footprint_assignment/staged/footprint_3D_models/SOT-23.step
2.50 x 3.00 x 1.20 mm
