luckyowl20/cert_rocket/gpt_context/outputs/sensors_cleanup/staged/footprint_3D_models/LGA-14L_2p5X3p0X0p86_STM.step

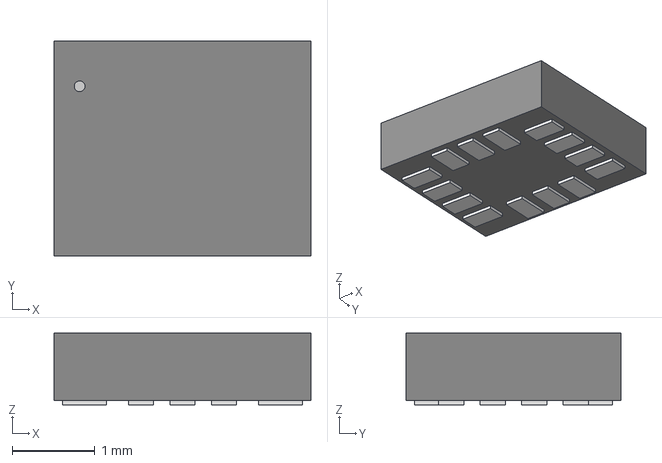
[picture p29: CAD file, 2026-06-19]
gpt_context/outputs/sensors_cleanup/staged/footprint_3D_models/LGA-14L_2p5X3p0X0p86_STM.step
3.10 x 2.59 x 0.866 mm
