luckyowl20/cert_rocket/avionics/avionics_rev1/footprint_3D_models/BQA0014B.stp

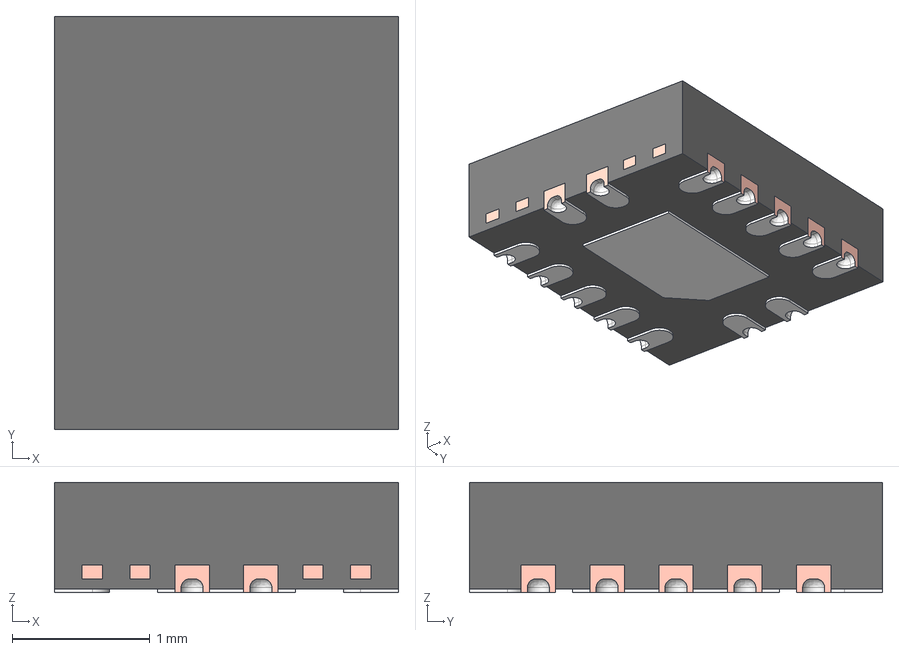
[picture p30: CAD file, 2026-10-02]
avionics/avionics_rev1/footprint_3D_models/BQA0014B.stp
2.50 x 3.00 x 0.8 mm
FRAME
PIN1_AREA
