luckyowl20/cert_rocket/gpt_context/outputs/footprint_assignment/footprint_3D_models/RAK0009A.stp

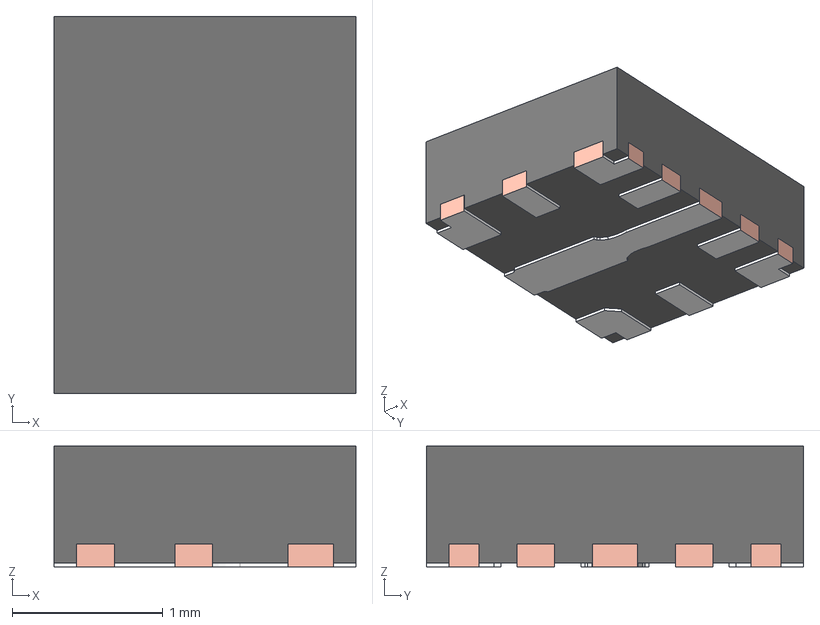
[picture p31: CAD file, 2026-09-24]
gpt_context/outputs/footprint_assignment/footprint_3D_models/RAK0009A.stp
2.00 x 2.50 x 0.8 mm
RAK0009A_FRAME
RAK0009A_MOLD
