luckyowl20/cert_rocket/gpt_context/outputs/sensors_cleanup/staged/footprint_3D_models/QFN_22DFTR_STM.step

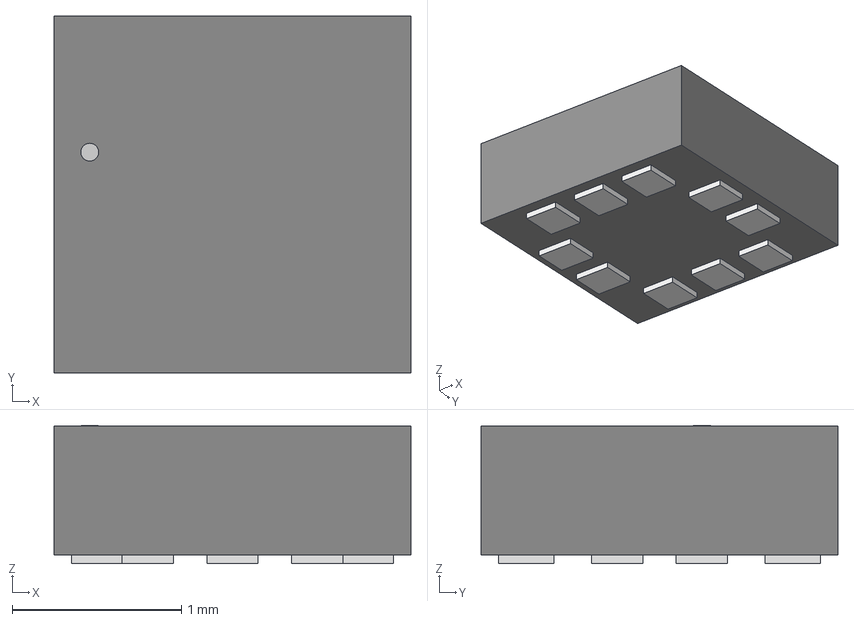
[picture p32: CAD file, 2026-06-19]
gpt_context/outputs/sensors_cleanup/staged/footprint_3D_models/QFN_22DFTR_STM.step
2.11 x 2.11 x 0.815 mm
