luckyowl20/cert_rocket/avionics/avionics_rev1/footprint_3D_models/Wio-SX1262.step

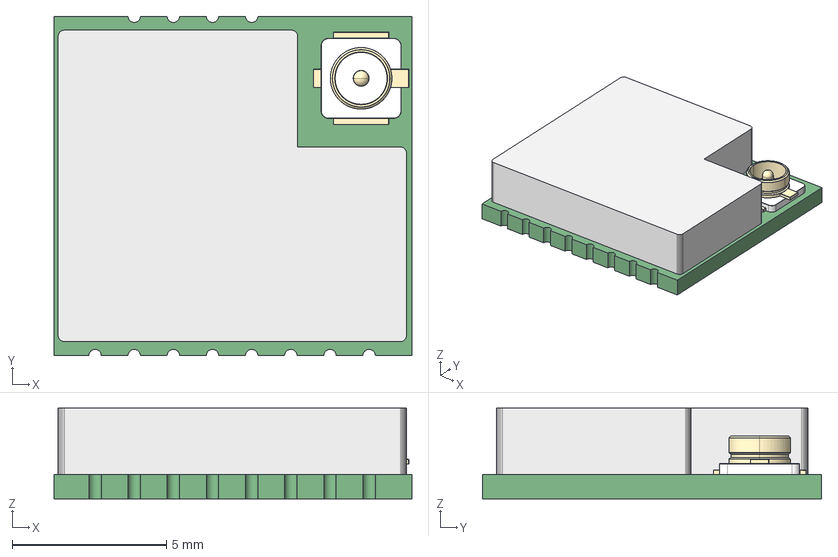
[picture p33: CAD file, 2026-09-25]
avionics/avionics_rev1/footprint_3D_models/Wio-SX1262.step
11.6 x 11.0 x 2.95 mm
User_Library-IPEX
Extruded
