luckyowl20/cert_rocket/gpt_context/outputs/footprint_assignment/staged/footprint_3D_models/SOT-23-5.step

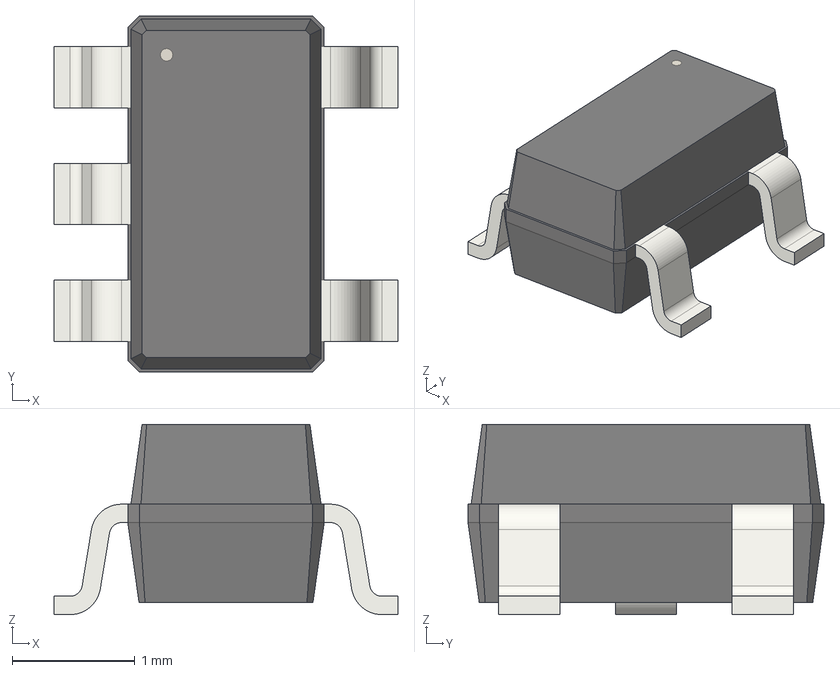
[picture p34: CAD file, 2026-09-24]
gpt_context/outputs/footprint_assignment/staged/footprint_3D_models/SOT-23-5.step
2.80 x 2.90 x 1.55 mm
