luckyowl20/cert_rocket/gpt_context/outputs/sensors_cleanup/staged/footprint_3D_models/LGA_CC-14-1_ADI.step

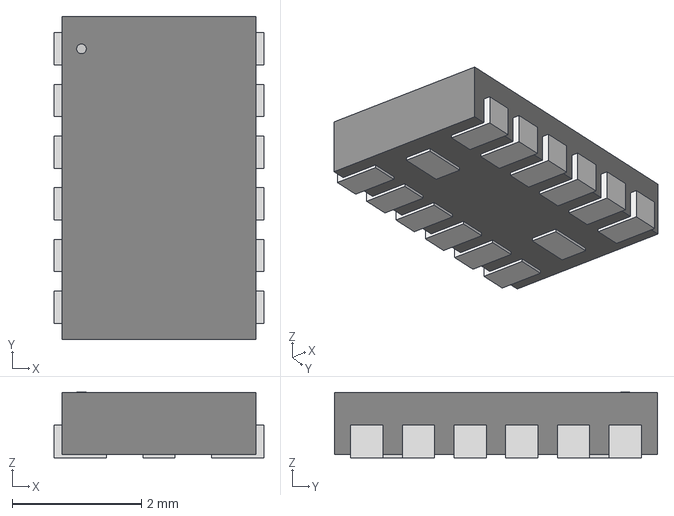
[picture p35: CAD file, 2026-06-19]
gpt_context/outputs/sensors_cleanup/staged/footprint_3D_models/LGA_CC-14-1_ADI.step
3.25 x 5.00 x 1.02 mm
