luckyowl20/cert_rocket/gpt_context/outputs/footprint_assignment/footprint_3D_models/RUX0012A.stp

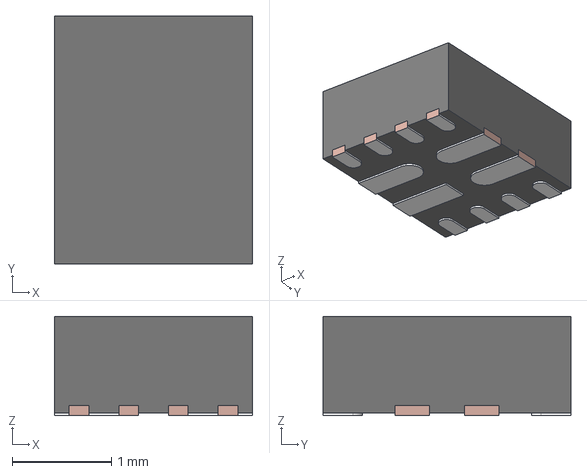
[picture p37: CAD file, 2026-09-24]
gpt_context/outputs/footprint_assignment/footprint_3D_models/RUX0012A.stp
2.00 x 2.50 x 1.00 mm
FRAME
MOLD
