luckyowl20/cert_rocket/gpt_context/outputs/footprint_assignment/staged/footprint_3D_models/RSV0016A.stp

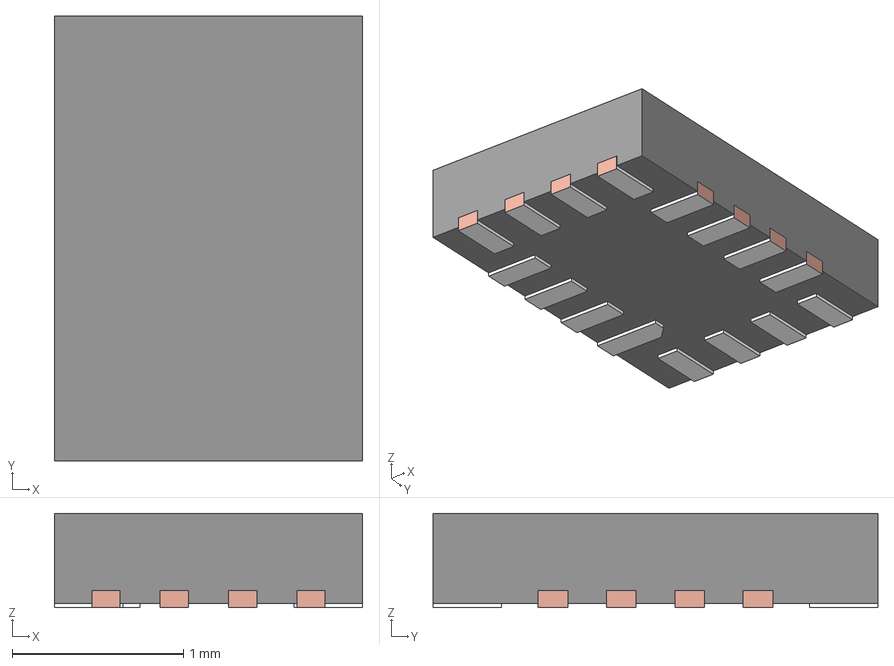
[picture p38: CAD file, 2026-09-24]
gpt_context/outputs/footprint_assignment/staged/footprint_3D_models/RSV0016A.stp
1.80 x 2.60 x 0.55 mm
BODY-SON1
FRAME-RSV0016A
