luckyowl20/cert_rocket/avionics/avionics_rev1/footprint_3D_models/AFS14A04-1575.42-T3.stp

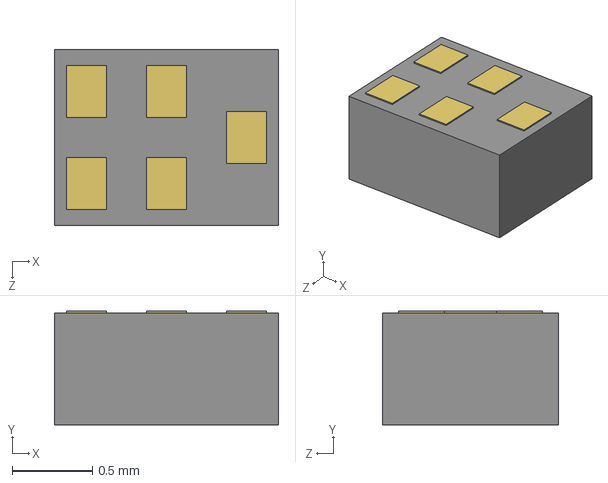
[picture p39: CAD file, 2026-06-19]
avionics/avionics_rev1/footprint_3D_models/AFS14A04-1575.42-T3.stp
1.40 x 0.71 x 1.10 mm
