luckyowl20/cert_rocket/avionics/avionics_rev1/footprint_3D_models/MAX-M10S-00B.step

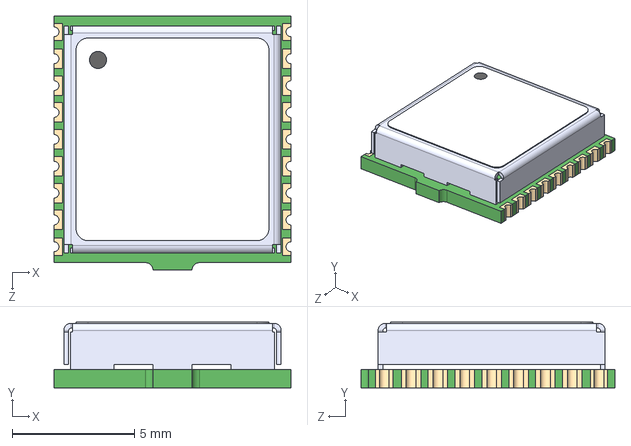
[picture p40: CAD file, 2026-06-19]
avionics/avionics_rev1/footprint_3D_models/MAX-M10S-00B.step
9.70 x 2.70 x 10.4 mm
