luckyowl20/cert_rocket/(list of files, cad)

Other CAD files:
avionics/downloads/LIB_AFS14A04-1575.42-T3/AFS14A04-1575.42-T3/Allegro/afs14a04157542t3.psm
avionics/downloads/LIB_AFS14A04-1575.42-T3/AFS14A04-1575.42-T3/DEHDL/afs14a04_1575.42_t3/chips/chips.prt
