luckyowl20/cert_rocket/gpt_context/outputs/power_setup_cleanup/preview/power_setup.png

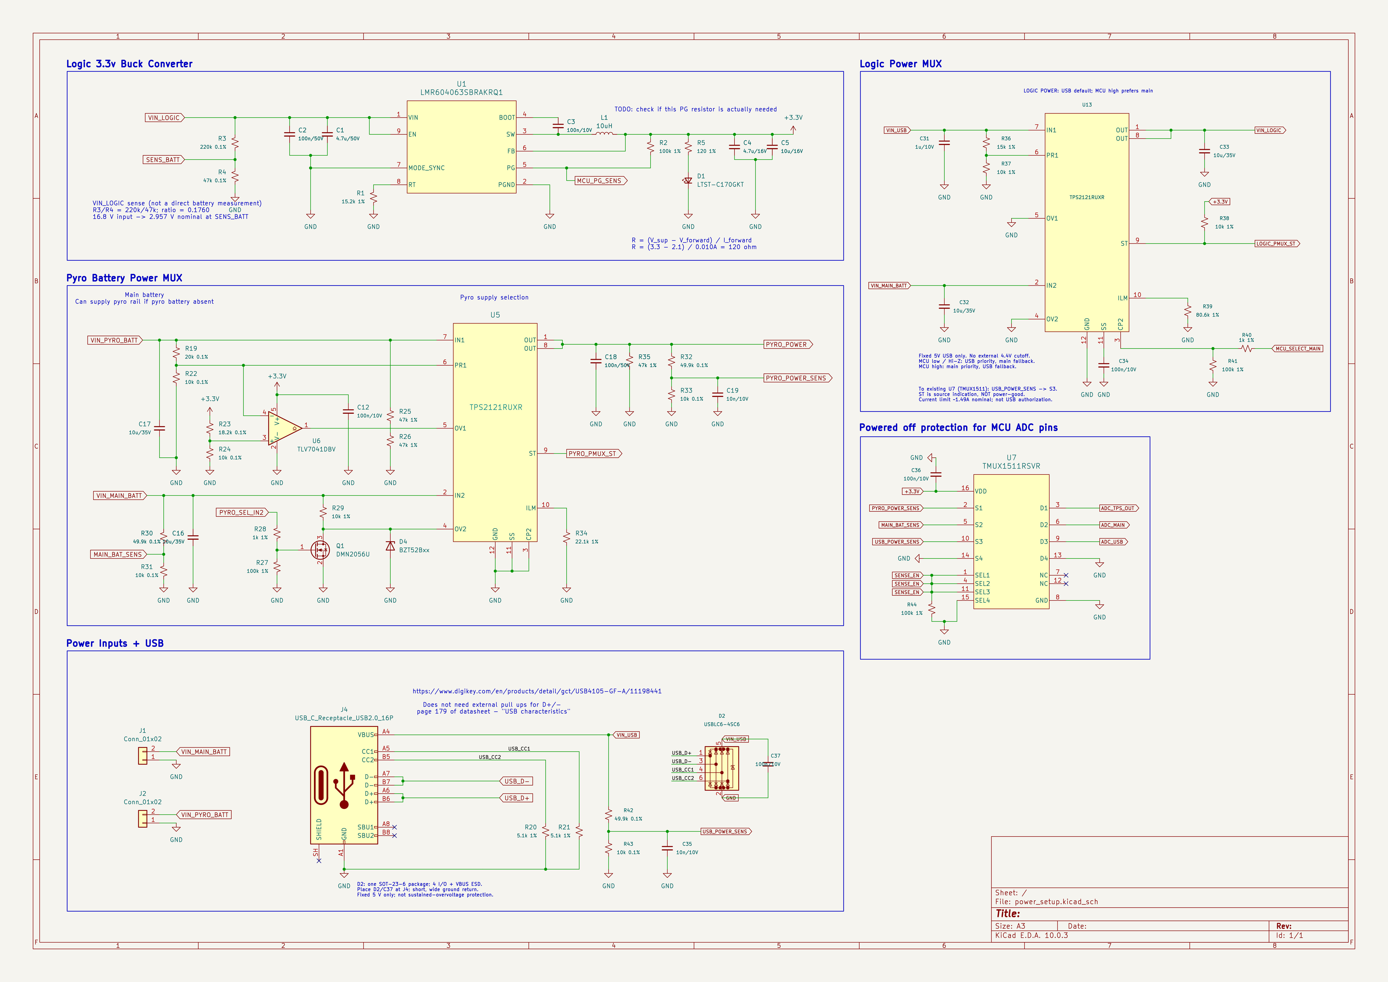
gpt_context/outputs/power_setup_cleanup/preview/power_setup.png
