luckyowl20/cert_rocket/gpt_context/outputs/power_setup_cleanup/preview/usb_array_detail.png

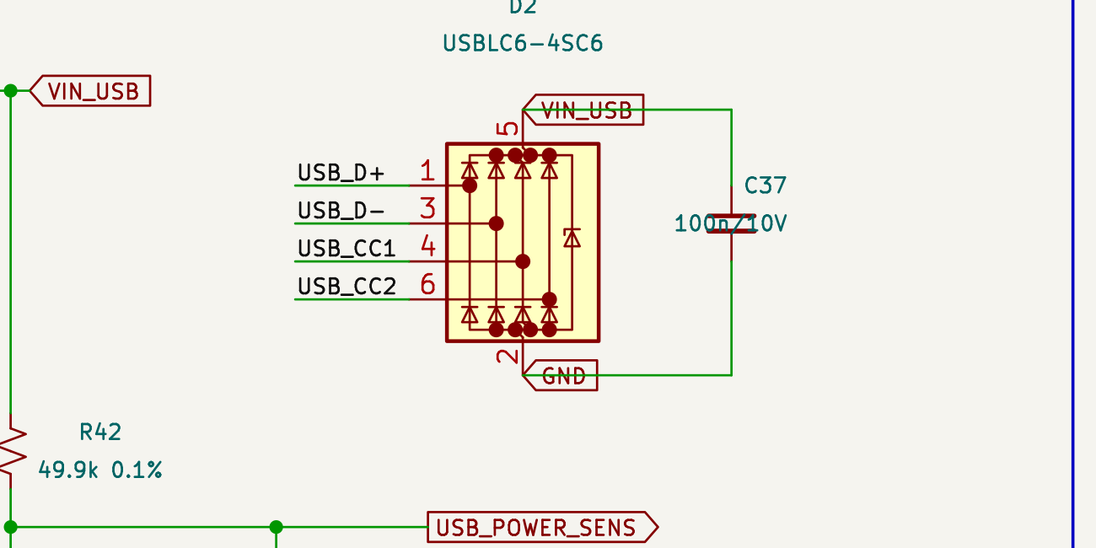
gpt_context/outputs/power_setup_cleanup/preview/usb_array_detail.png
