luckyowl20/cert_rocket/gpt_context/outputs/sensors_cleanup/qa/inspection_top.png

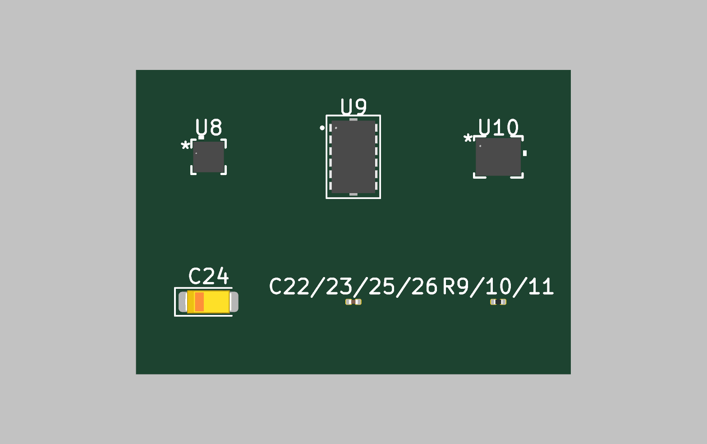
gpt_context/outputs/sensors_cleanup/qa/inspection_top.png
