luckyowl20/cert_rocket/gpt_context/outputs/sensors_cleanup/qa/sensors.png

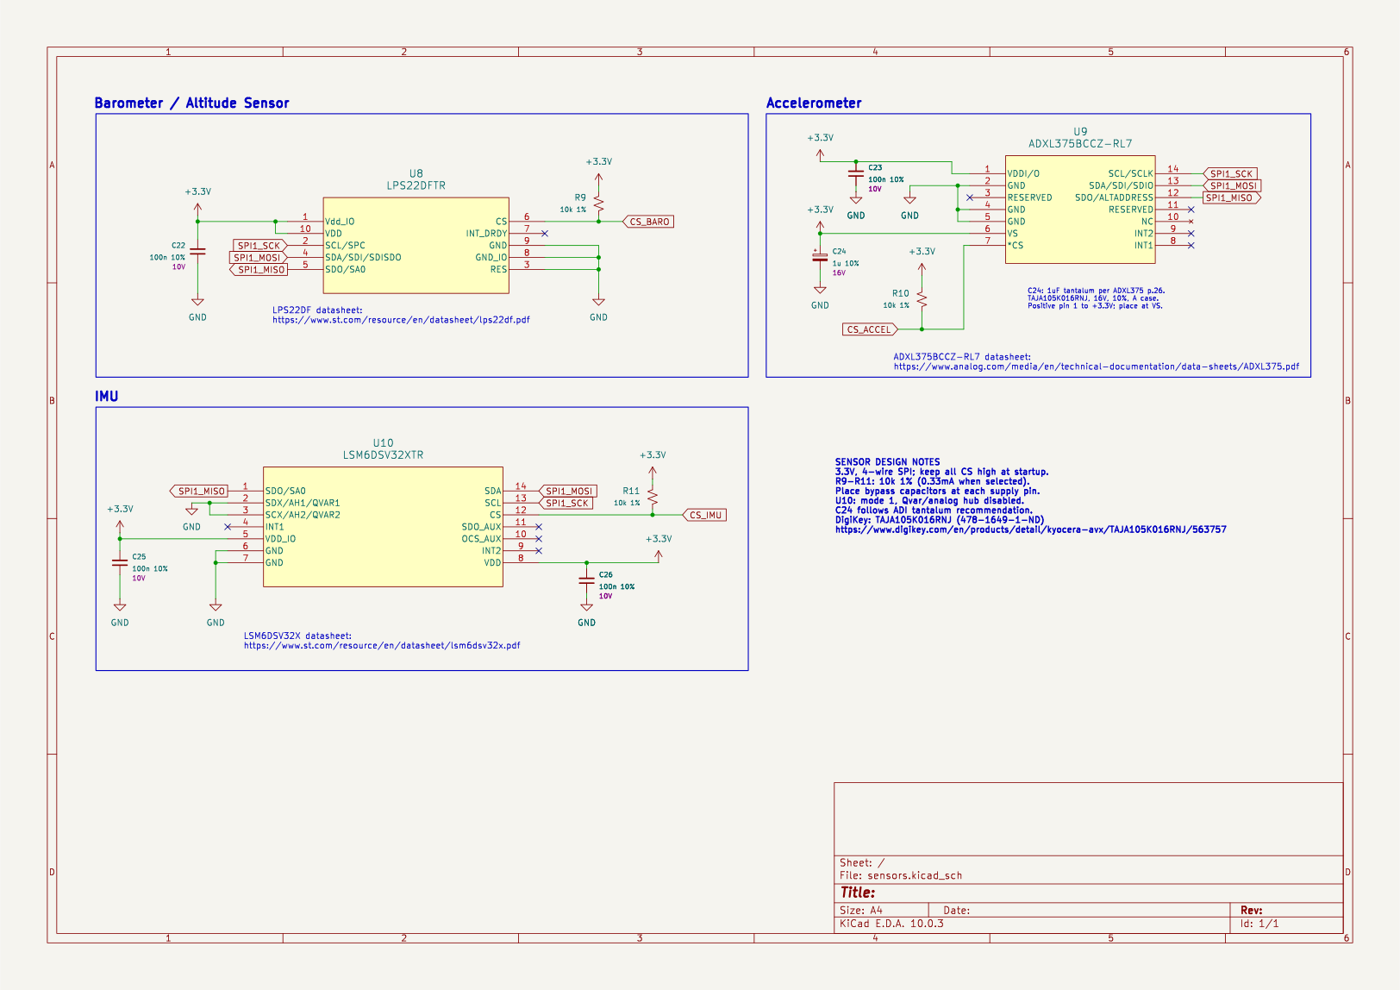
gpt_context/outputs/sensors_cleanup/qa/sensors.png
