luckyowl20/cert_rocket/gpt_context/outputs/usb_c/02_boot_debug_power.png

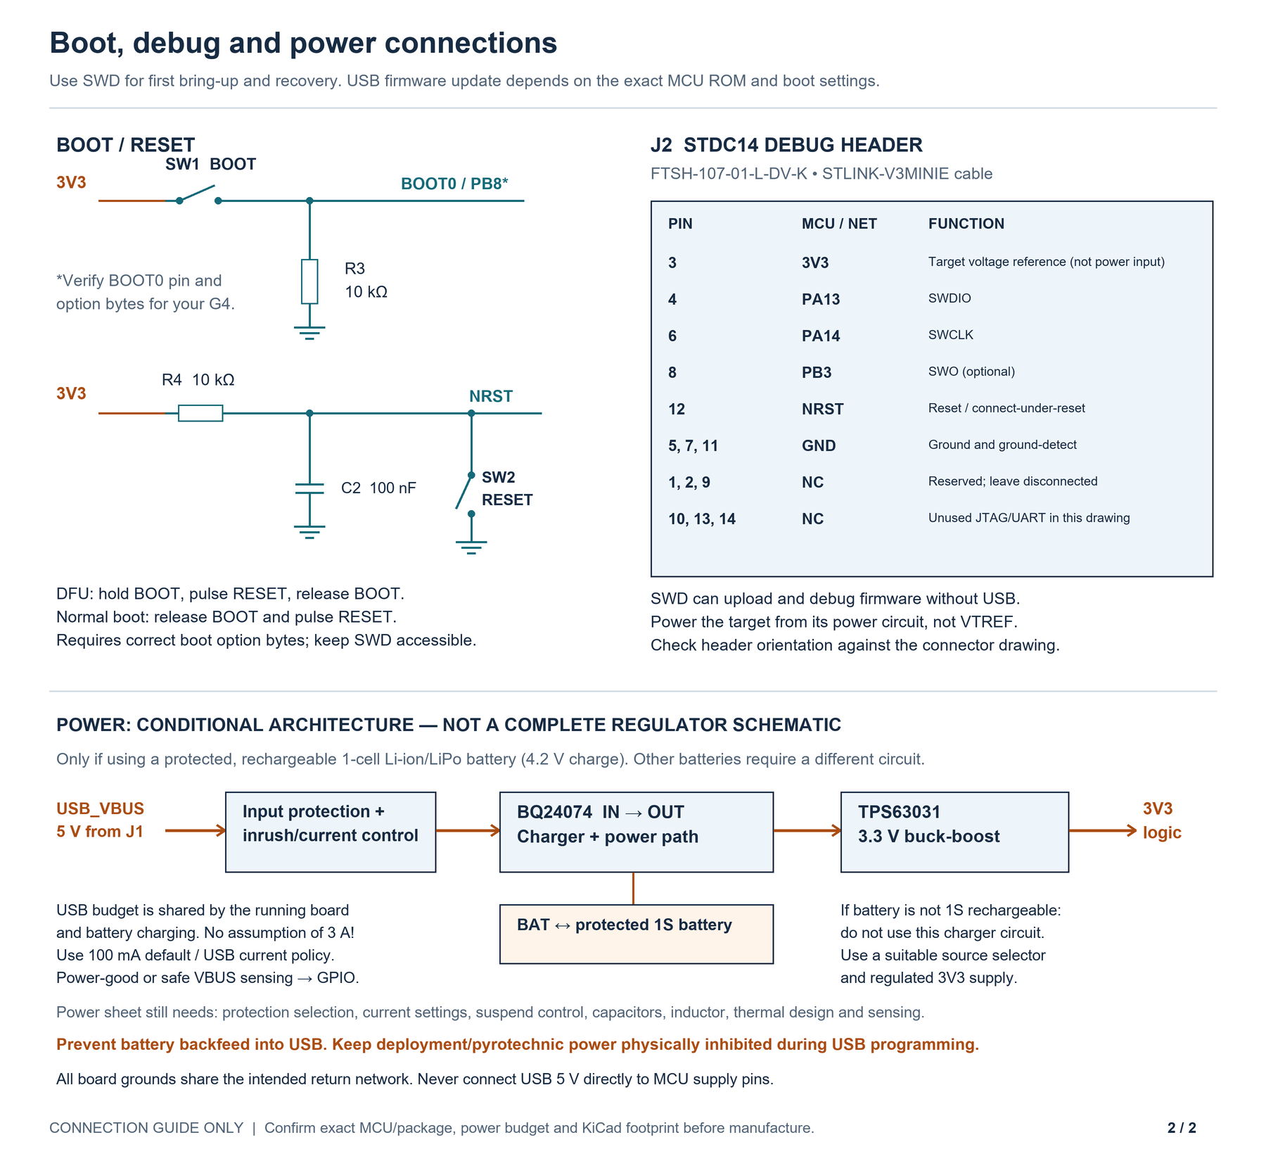
gpt_context/outputs/usb_c/02_boot_debug_power.png
