luckyowl20/cert_rocket/gpt_context/tmp/pdfs/telemega-sch.pdf

# STM32L151

# 48 PB11/I2C2_SDA/USART3_RX/TIM2_CH449 VSS1 50 VDD¹

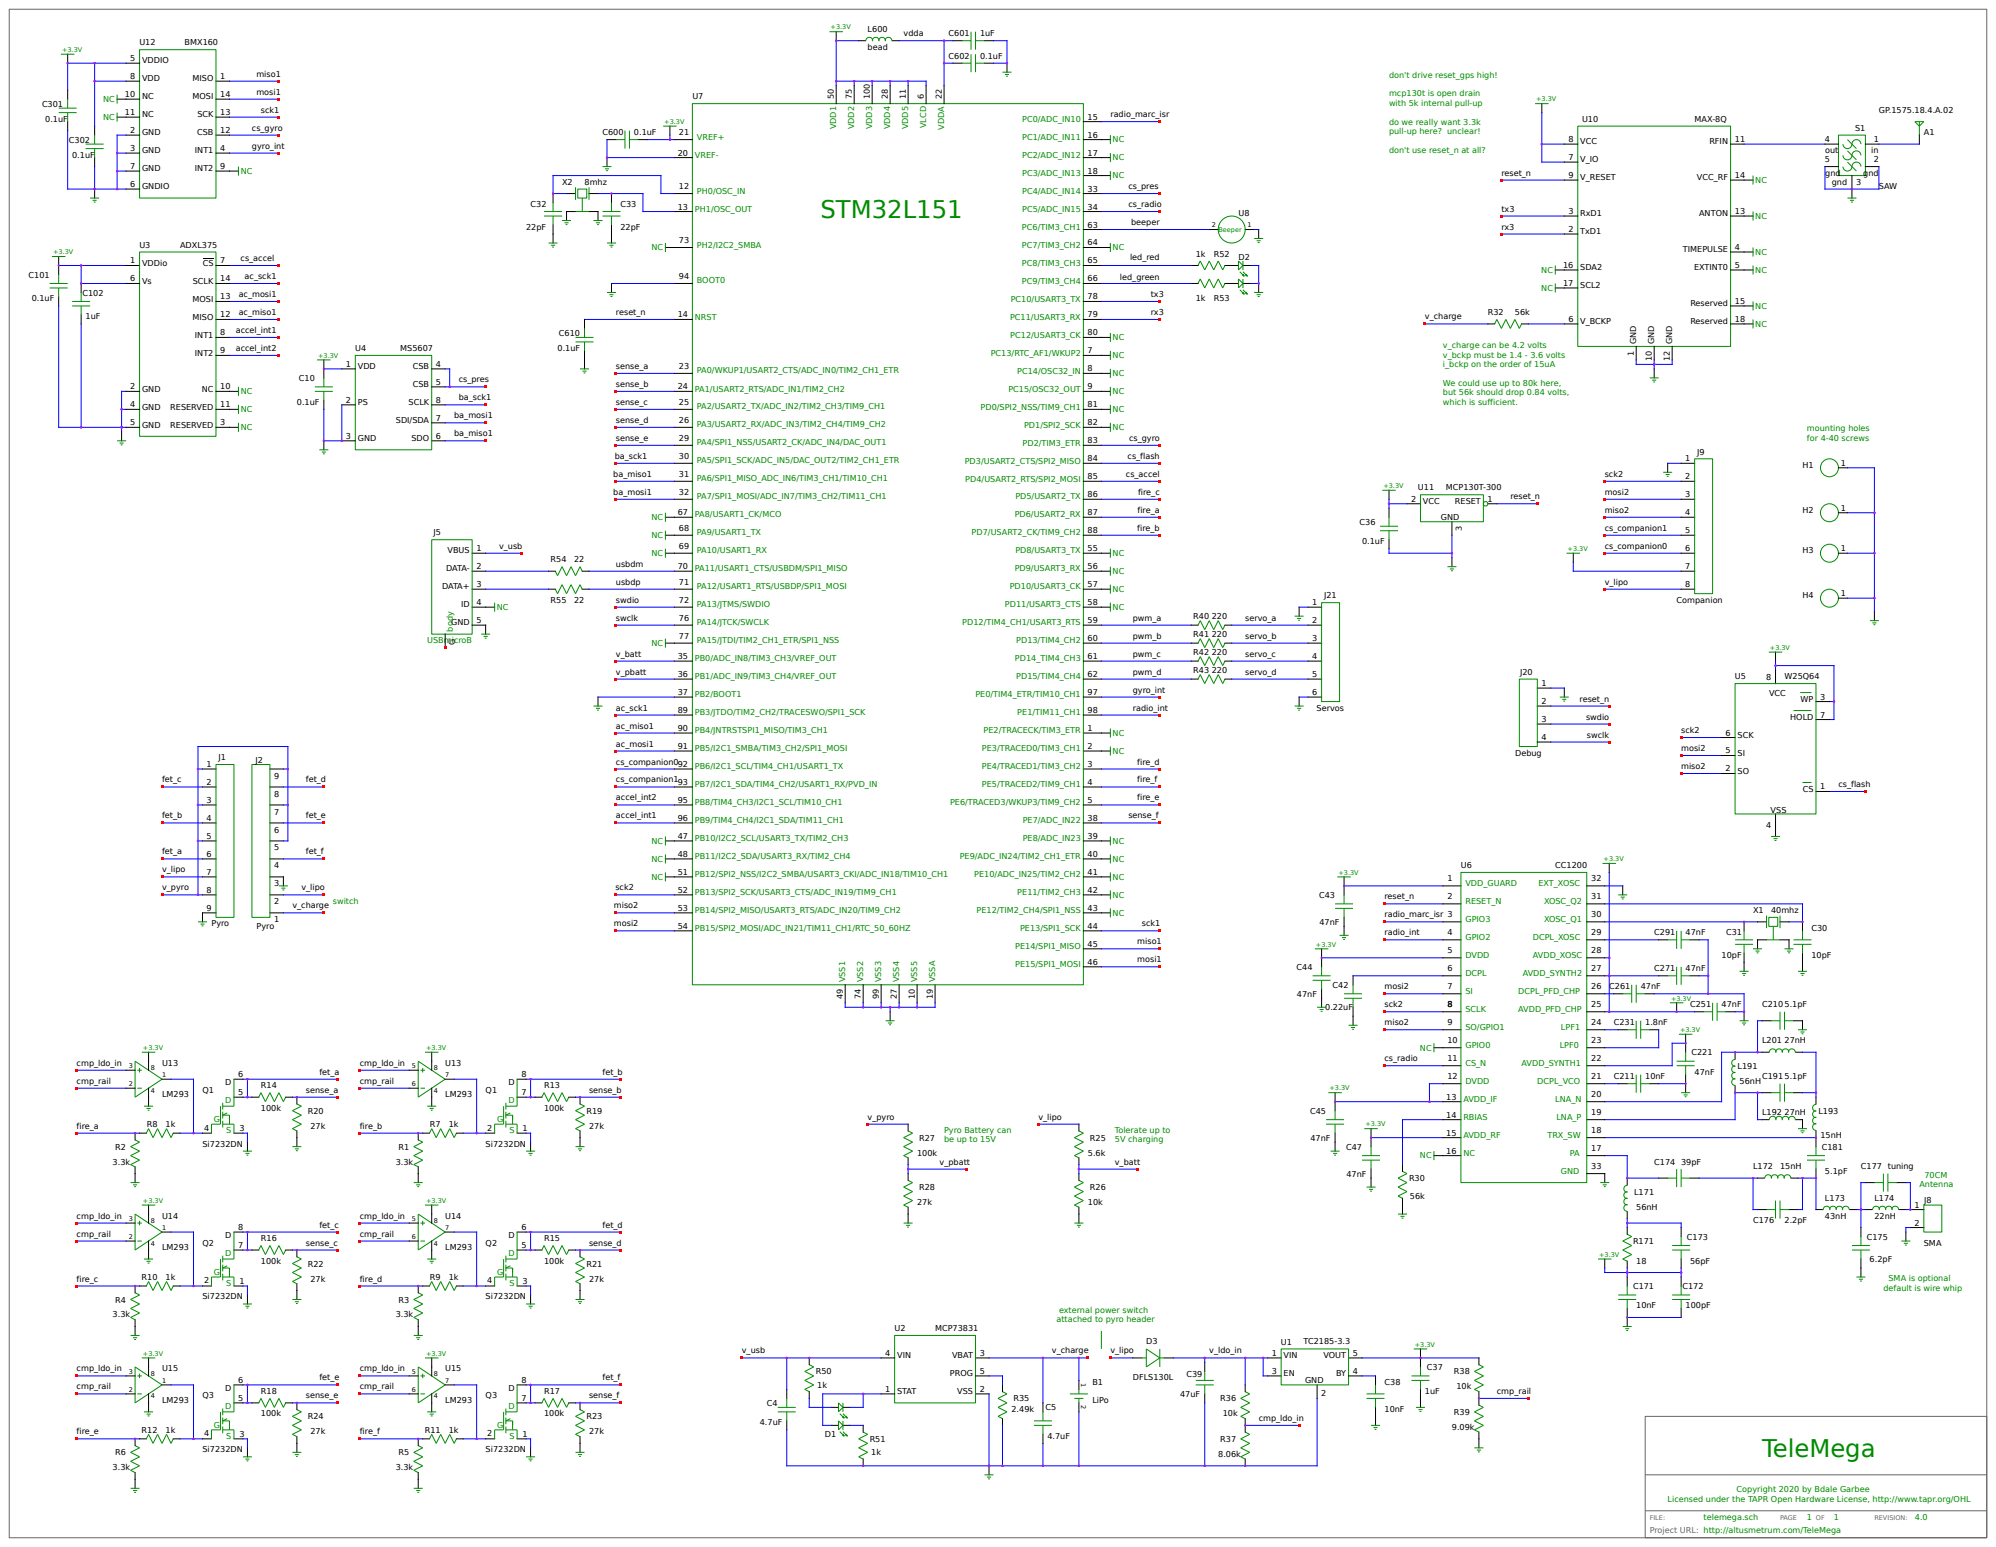
[picture p47: page 1]

mcp130t is open drain
with 5k internal pull-up

do we really want 3.3k
pull-up here? unclear!

don't use reset_n at all?

v_charge can be 4.2 volts
v_bckp must be 1.4 - 3.6 volts
i_bckp on the order of 15uA

We could use up to 80k here,
but 56k should drop 0.84 volts,
which is sufficient.

SMA is optional
default is wire whip

external power switch
attached to pyro header

Copyright 2020 by Bdale Garbee

Licensed under the TAPR Open Hardware License, http://www.tapr.org/OHL

http://altusmetrum.com/TeleMega
