luckyowl20/cert_rocket/(list of files, drawings)

Other design files:
avionics/downloads/LIB_AFS14A04-1575.42-T3/AFS14A04-1575.42-T3/Altium/AFS14A04-1575.42-T3.SchLib
avionics/downloads/LIB_AFS14A04-1575.42-T3/AFS14A04-1575.42-T3/Altium/AFS14A04157542T3.PcbLib
