luckyowl20/cert_rocket/avionics/avionics_rev1/avionics_rev1.kicad_pcb

## KiCad design avionics/avionics_rev1/avionics_rev1.kicad_pcb (2026-10-29)

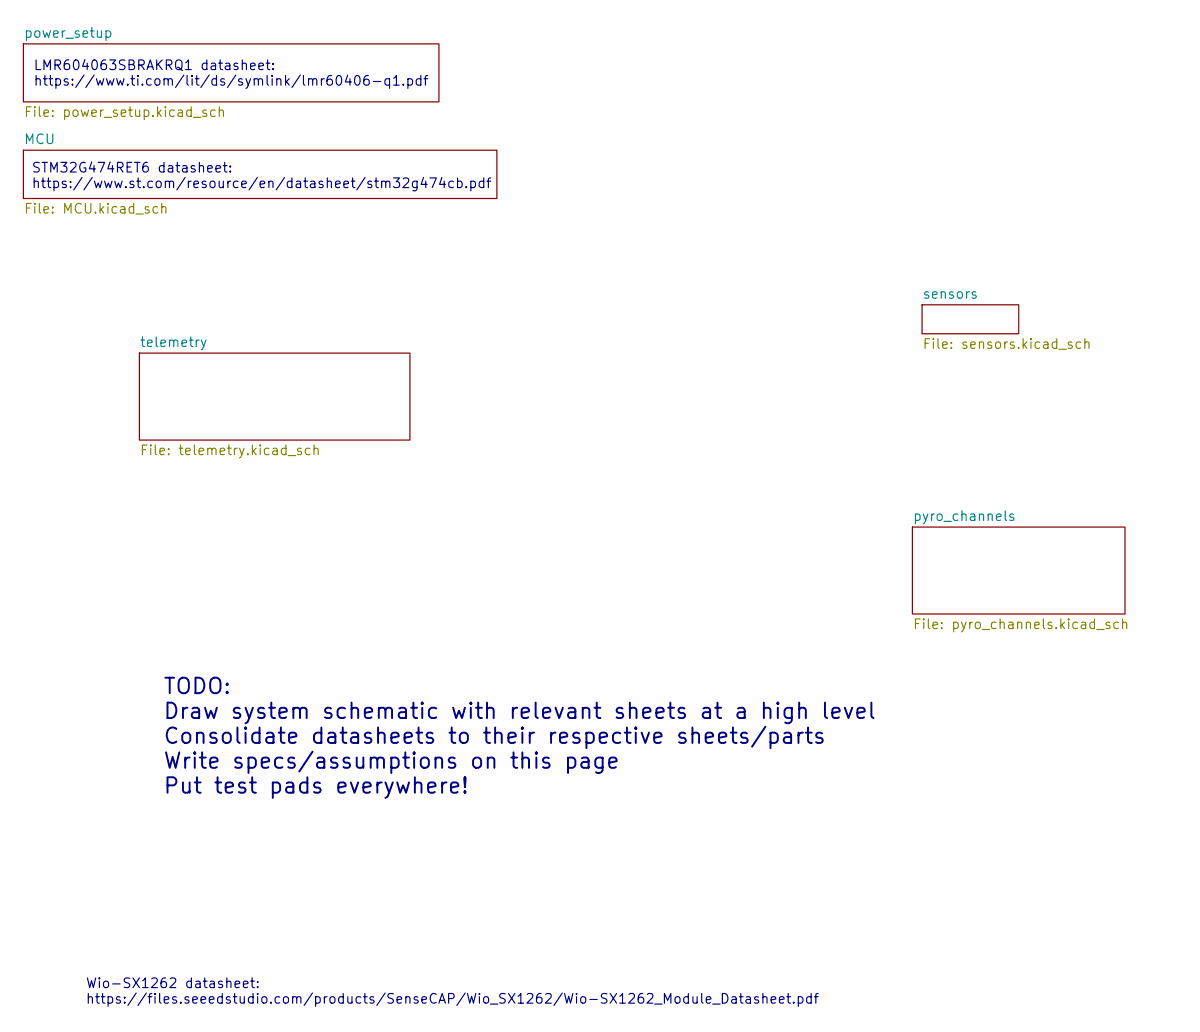
[picture p48: schematic avionics_rev1.kicad_sch]

Notes on the sheet:
Wio-SX1262 datasheet: https://files.seeedstudio.com/products/SenseCAP/Wio_SX1262/Wio-SX1262_Module_Datasheet.pdf
STM32G474RET6 datasheet: https://www.st.com/resource/en/datasheet/stm32g474cb.pdf
LMR604063SBRAKRQ1 datasheet: https://www.ti.com/lit/ds/symlink/lmr60406-q1.pdf
TODO: Draw system schematic with relevant sheets at a high level Consolidate datasheets to their respective sheets/parts Write specs/assumptions on this page Put test pads everywhere!

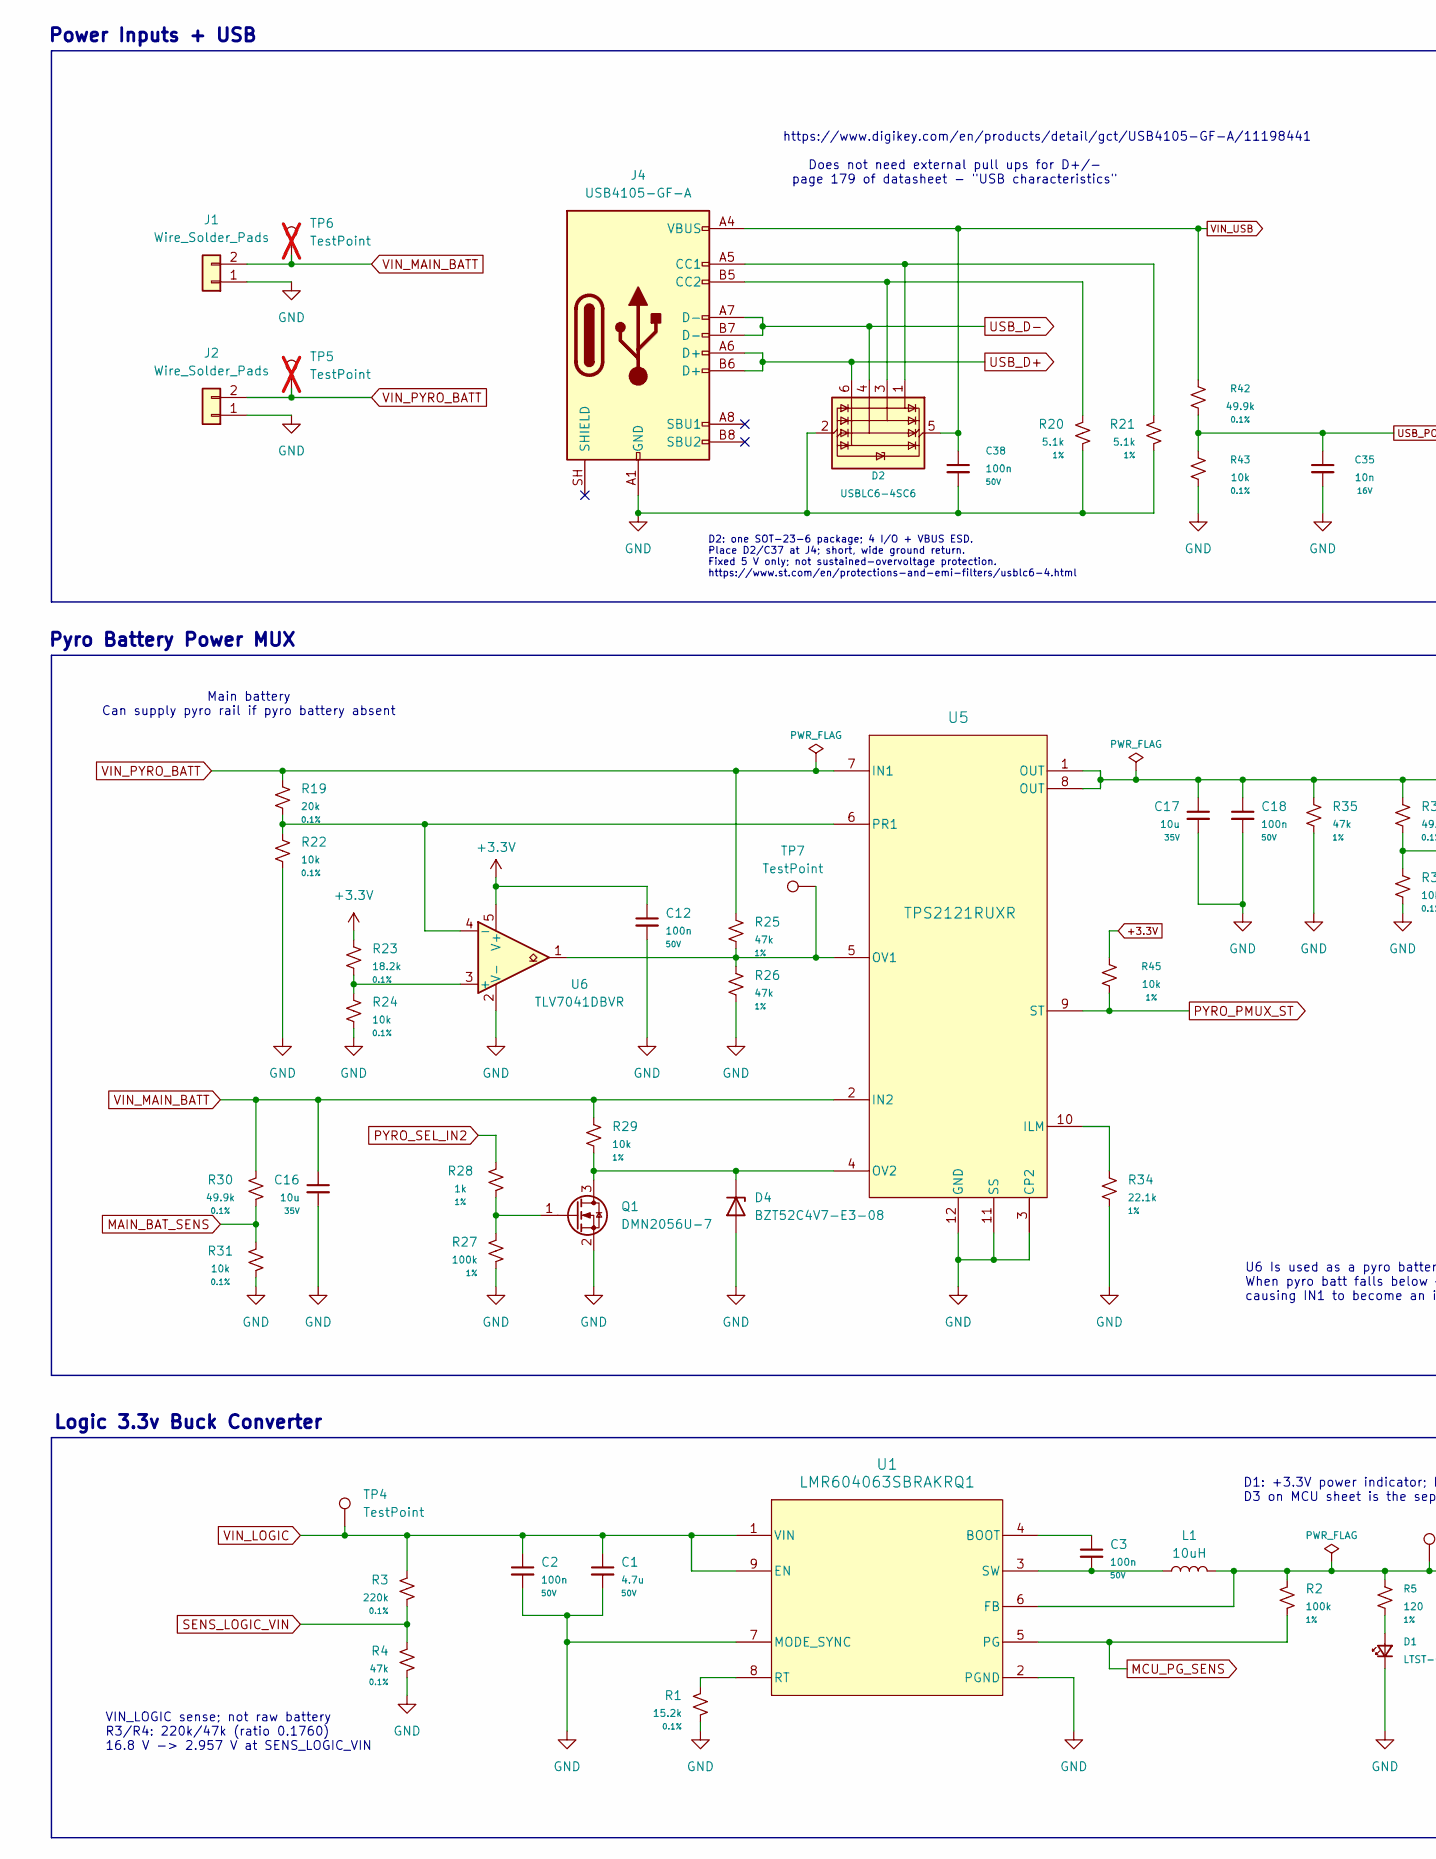
[picture p49: schematic power_setup.kicad_sch, Flight Computer Power Distribution, part in row 1, column 1]

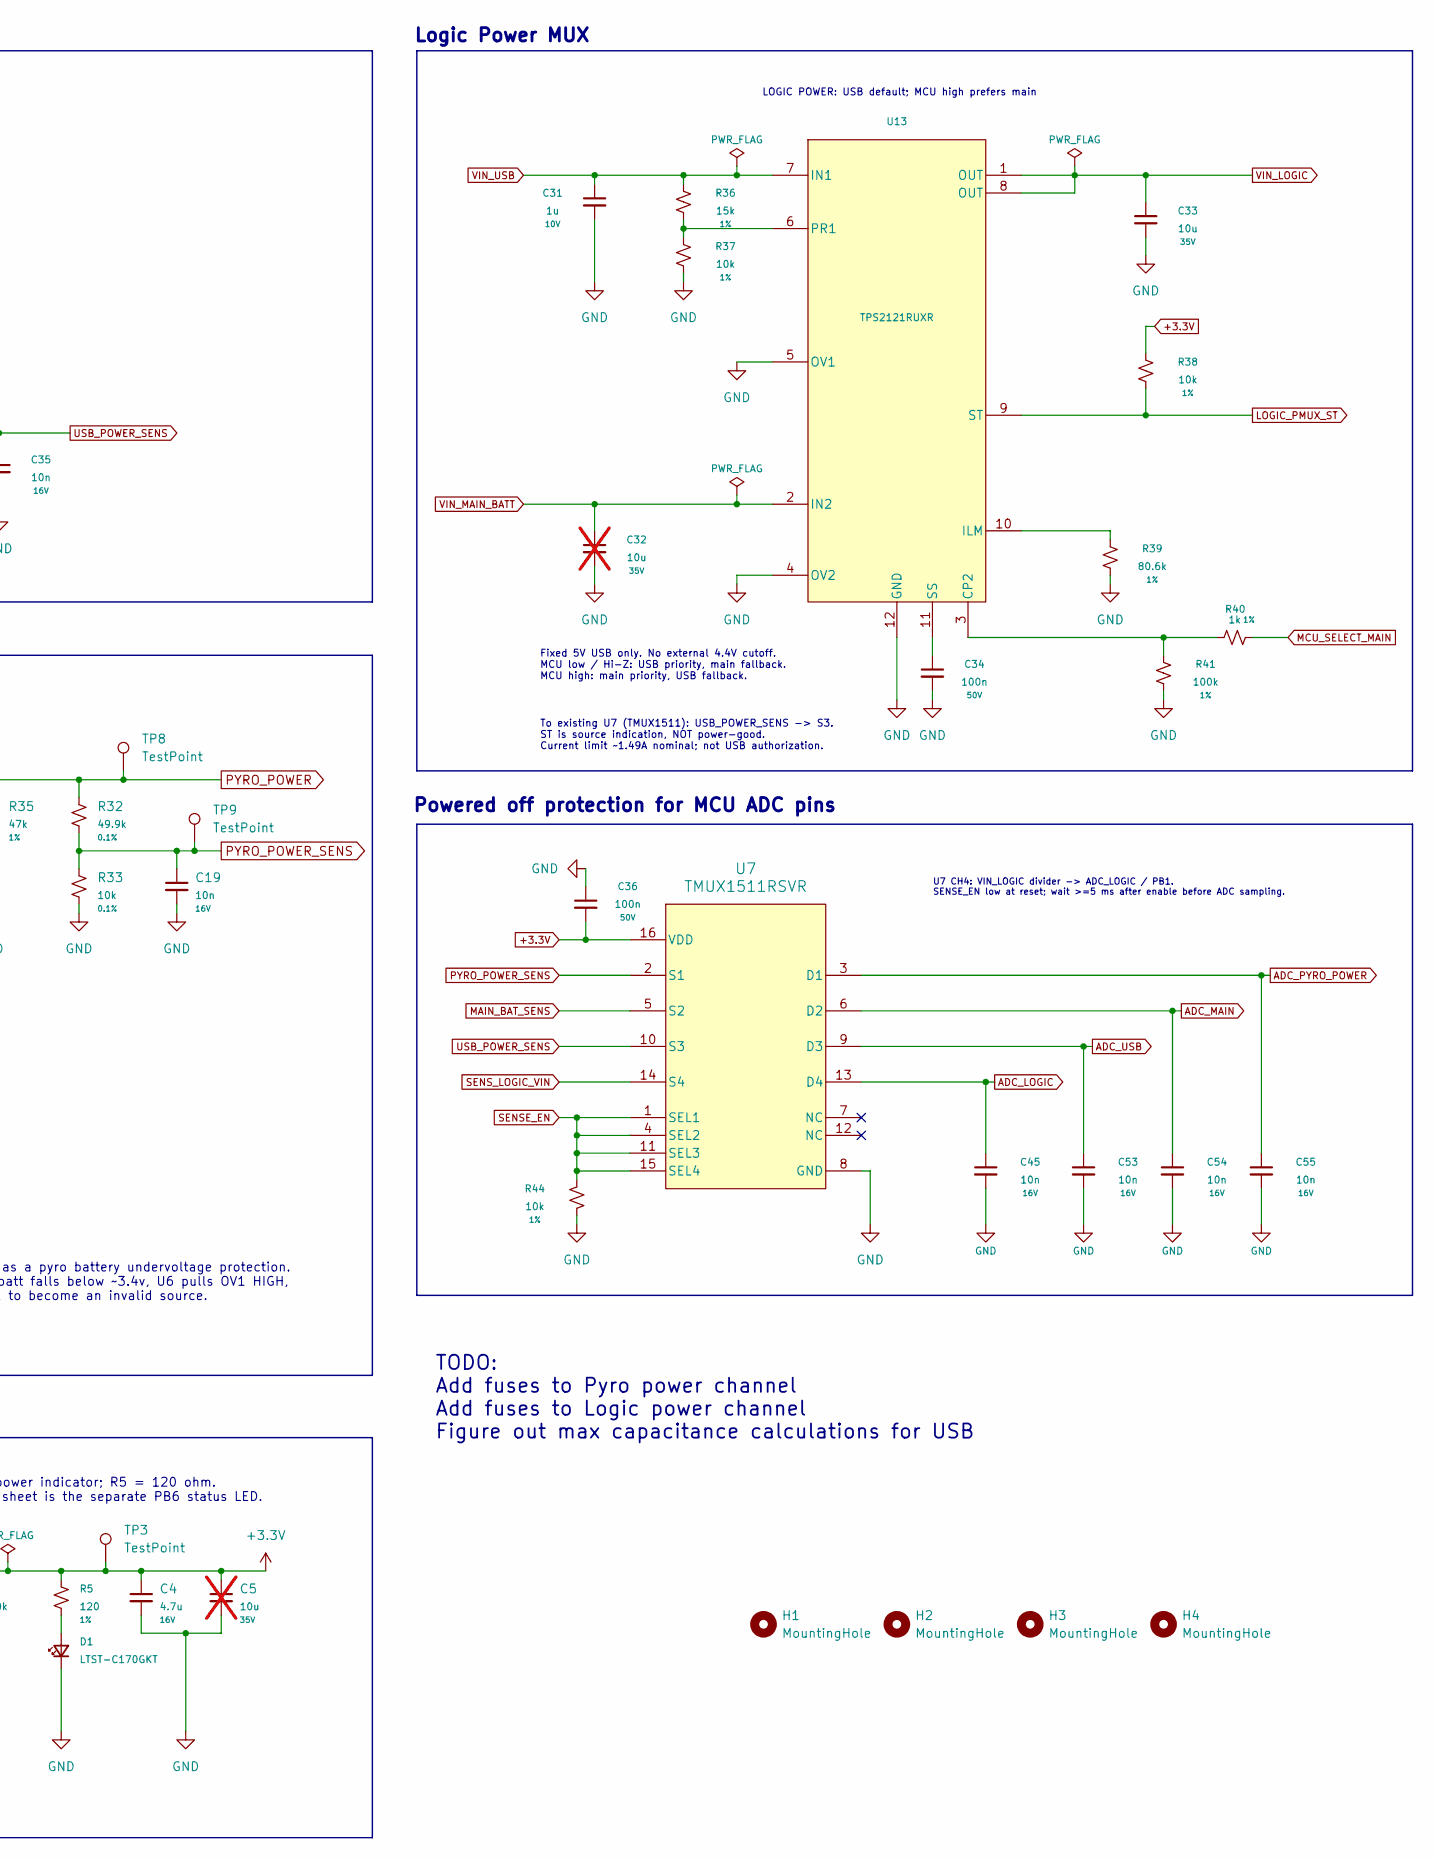
[picture p50: schematic power_setup.kicad_sch, Flight Computer Power Distribution, part in row 1, column 2]

Parts:
C1: 4.7u; C_0805_2012Metric; Voltage 50V; Tolerance 10%; MPN C2012X5R1H475K125AB
C2, C3, C12, C18, C34, C36, C38: 100n; C_0603_1608Metric; Voltage 50V; Tolerance 10%; MPN C0603C104K5RACTU
C4: 4.7u; C_0603_1608Metric; Voltage 16V; Tolerance 10%; MPN GRM188R61C475KE11D
C5, C32: 10u; C_0805_2012Metric; Voltage 35V; Tolerance 10%; MPN GRM21BR6YA106KE43L; not fitted
C16, C17, C33: 10u; C_0805_2012Metric; Voltage 35V; Tolerance 10%; MPN GRM21BR6YA106KE43L
C19, C35: 10n; C_0603_1608Metric; Voltage 16V; Tolerance 10%; MPN CC0603KRX7R7BB103
C31: 1u; C_0603_1608Metric; Voltage 10V; Tolerance 10%; MPN C1608X7R1A105K080AC
C45, C53, C54, C55: 10n; C_0603_1608Metric; Tolerance 10%; Voltage 16V; MPN CC0603KRX7R7BB103
D1: LTST-C170GKT; LTST_C170GKT_0805; MPN LTST-C170GKT
D2: USBLC6-4SC6; USBLC6_4SC6_SOT23_6; MPN USBLC6-4SC6
D4: BZT52C4V7-E3-08; BZT52C4V7_E3_08_SOD123; MPN BZT52C4V7-E3-08
H1, H2, H3, H4: MountingHole; MountingHole_2.2mm_M2
J1, J2: Wire_Solder_Pads; WireSolderPads_1x02_3x2mm_P4mm
J4: USB4105-GF-A; USB_C_Receptacle_GCT_USB4105-xx-A_16P_TopMnt_Horizontal; MPN USB4105-GF-A
L1: 10uH; L_Changjiang_FTC303010D
Q1: DMN2056U-7; DMN2056U_7_SOT23; MPN DMN2056U-7
R1: 15.2k; R_0603_1608Metric; Tolerance 0.1%; Voltage 75V; MPN RN73R1JTTD1522B25
R2, R27, R41: 100k; R_0603_1608Metric; Tolerance 1%; Voltage 75V; MPN RC0603FR-07100KL
R3: 220k; R_0603_1608Metric; Tolerance 0.1%; Voltage 75V; MPN RT0603BRD07220KL
R4: 47k; R_0603_1608Metric; Tolerance 0.1%; Voltage 75V; MPN RT0603BRD0747KL
R5: 120; R_0603_1608Metric; Tolerance 1%; Voltage 75V; MPN RC0603FR-07120RL
R19: 20k; R_0603_1608Metric; Tolerance 0.1%; Voltage 75V; MPN RT0603BRD0720KL
R20, R21: 5.1k; R_0603_1608Metric; Tolerance 1%; Voltage 75V; MPN RC0603FR-075K1L
R22, R24, R31, R33, R43: 10k; R_0603_1608Metric; Tolerance 0.1%; Voltage 75V; MPN RT0603BRD0710KL
R23: 18.2k; R_0603_1608Metric; Tolerance 0.1%; Voltage 75V; MPN RT0603BRD0718K2L
R25, R26, R35: 47k; R_0603_1608Metric; Tolerance 1%; Voltage 75V; MPN RC0603FR-0747KL
R28, R40: 1k; R_0603_1608Metric; Tolerance 1%; Voltage 75V; MPN RC0603FR-071KL
R29, R37, R38, R44, R45: 10k; R_0603_1608Metric; Tolerance 1%; Voltage 75V; MPN RC0603FR-0710KL
R30, R32, R42: 49.9k; R_0603_1608Metric; Tolerance 0.1%; Voltage 75V; MPN RT0603BRD0749K9L
R34: 22.1k; R_0603_1608Metric; Tolerance 1%; Voltage 75V; MPN RC0603FR-0722K1L
R36: 15k; R_0603_1608Metric; Tolerance 1%; Voltage 75V; MPN RC0603FR-0715KL
R39: 80.6k; R_0603_1608Metric; Tolerance 1%; Voltage 75V; MPN RC0603FR-0780K6L
TP3, TP4, TP7, TP8, TP9: TestPoint; TestPoint_Pad_D1.0mm
TP5, TP6: TestPoint; TestPoint_Pad_D1.0mm; not fitted
U1: LMR604063SBRAKRQ1; LMR604063SBRAKRQ1_RAK9; MPN LMR604063SBRAKRQ1
U5, U13: TPS2121RUXR; TPS2121RUXR_RUX12; MPN TPS2121RUXR
U6: TLV7041DBVR; TLV7041DBVR_SOT23_5; MPN TLV7041DBVR
U7: TMUX1511RSVR; TMUX1511RSVR_RSV16; MPN TMUX1511RSVR

Connections:
ADC_LOGIC: C45.1, U7.13 (D4); also elsewhere on the board
ADC_MAIN: C54.1, U7.6 (D2); also elsewhere on the board
ADC_PYRO_POWER: C55.1, U7.3 (D1); also elsewhere on the board
ADC_USB: C53.1, U7.9 (D3); also elsewhere on the board
GND: C1.2, C2.2, C4.2, C5.2, C12.2, C16.2, C17.2, C18.2, C19.2, C31.2, C32.2, C33.2, C34.2, C35.2, C36.1, C38.2, C45.2, C53.2, C54.2, C55.2, D1.1 (K), D2.2 (GND), D4.2 (A), J1.1, J2.1, J4.A1 (GND), J4.A12 (GND), J4.B1 (GND), J4.B12 (GND), Q1.2 (S), R1.1, R4.1, R20.1, R21.1, R22.2, R24.2, R26.2, R27.2, R31.2, R33.2, R34.2, R35.2, R37.2, R39.2, R41.2, R43.2, R44.2, U1.2 (PGND), U1.7 (MODE_SYNC), U5.3 (CP2), U5.11 (SS), U5.12 (GND), U6.2 (V-), U7.8 (GND), U13.4 (OV2), U13.5 (OV1), U13.12 (GND); also elsewhere on the board
LOGIC_PMUX_ST: R38.2, U13.9 (ST); also elsewhere on the board
MAIN_BAT_SENS: R30.2, R31.1, U7.5 (S2)
MCU_PG_SENS: R2.2, U1.5 (PG); also elsewhere on the board
MCU_SELECT_MAIN: R40.2; also elsewhere on the board
unnamed: D1.2 (A), R5.1
unnamed: D2.1 (I/O1), J4.A5 (CC1), R21.2
unnamed: D2.3 (I/O2), J4.B5 (CC2), R20.2
unnamed: D4.1 (K), Q1.3 (D), R29.1, U5.4 (OV2)
unnamed: Q1.1 (G), R27.1, R28.2
unnamed: C3.1, U1.4 (BOOT)
unnamed: R1.2, U1.8 (RT)
unnamed: C3.2, L1.1, U1.3 (SW)
unnamed: R34.1, U5.10 (ILM)
unnamed: R25.2, R26.1, TP7.1 (1_1), U5.5 (OV1), U6.1
unnamed: R19.2, R22.1, U5.6 (PR1), U6.4 (-)
unnamed: R23.2, R24.1, U6.3 (+)
unnamed: R40.1, R41.1, U13.3 (CP2)
unnamed: R39.1, U13.10 (ILM)
unnamed: R36.2, R37.1, U13.6 (PR1)
unnamed: C34.1, U13.11 (SS)
PYRO_PMUX_ST: R45.2, U5.9 (ST); also elsewhere on the board
PYRO_POWER_SENS: C19.1, R32.2, R33.1, TP9.1 (1_1), U7.2 (S1)
PYRO_SEL_IN2: R28.1; also elsewhere on the board
SENSE_EN: R44.1, U7.1 (SEL1), U7.4 (SEL2), U7.11 (SEL3), U7.15 (SEL4); also elsewhere on the board
SENS_LOGIC_VIN: R3.1, R4.2, U7.14 (S4)
USB_D+: D2.6 (I/O4), J4.A6 (D+), J4.B6 (D+); also elsewhere on the board
USB_D-: D2.4 (I/O3), J4.A7 (D-), J4.B7 (D-); also elsewhere on the board
USB_POWER_SENS: C35.1, R42.2, R43.1, U7.10 (S3)

Notes on the sheet:
Logic 3.3v Buck Converter
Power Inputs + USB
TODO: Add fuses to Pyro power channel Add fuses to Logic power channel Figure out max capacitance calculations for USB
LOGIC POWER: USB default; MCU high prefers main
https://www.digikey.com/en/products/detail/gct/USB4105-GF-A/11198441
Fixed 5V USB only. No external 4.4V cutoff. MCU low / Hi-Z: USB priority, main fallback. MCU high: main priority, USB fallback.
Pyro Battery Power MUX
Does not need external pull ups for D+/- page 179 of datasheet - "USB characteristics"
U6 Is used as a pyro battery undervoltage protection. When pyro batt falls below ~3.4v, U6 pulls OV1 HIGH, causing IN1 to become an invalid source.
U7 CH4: VIN_LOGIC divider -> ADC_LOGIC / PB1. SENSE_EN low at reset; wait >=5 ms after enable before ADC sampling.
VIN_LOGIC sense; not raw battery R3/R4: 220k/47k (ratio 0.1760) 16.8 V -> 2.957 V at SENS_LOGIC_VIN
D2: one SOT-23-6 package; 4 I/O + VBUS ESD. Place D2/C37 at J4; short, wide ground return. Fixed 5 V only; not sustained-overvoltage protection. https://www.st.com/en/protections-and-emi-filters/usblc6-4.html
D1: +3.3V power indicator; R5 = 120 ohm. D3 on MCU sheet is the separate PB6 status LED.
Powered off protection for MCU ADC pins
To existing U7 (TMUX1511): USB_POWER_SENS -> S3. ST is source indication, NOT power-good. Current limit ~1.49A nominal; not USB authorization.
Main battery Can supply pyro rail if pyro battery absent
Logic Power MUX

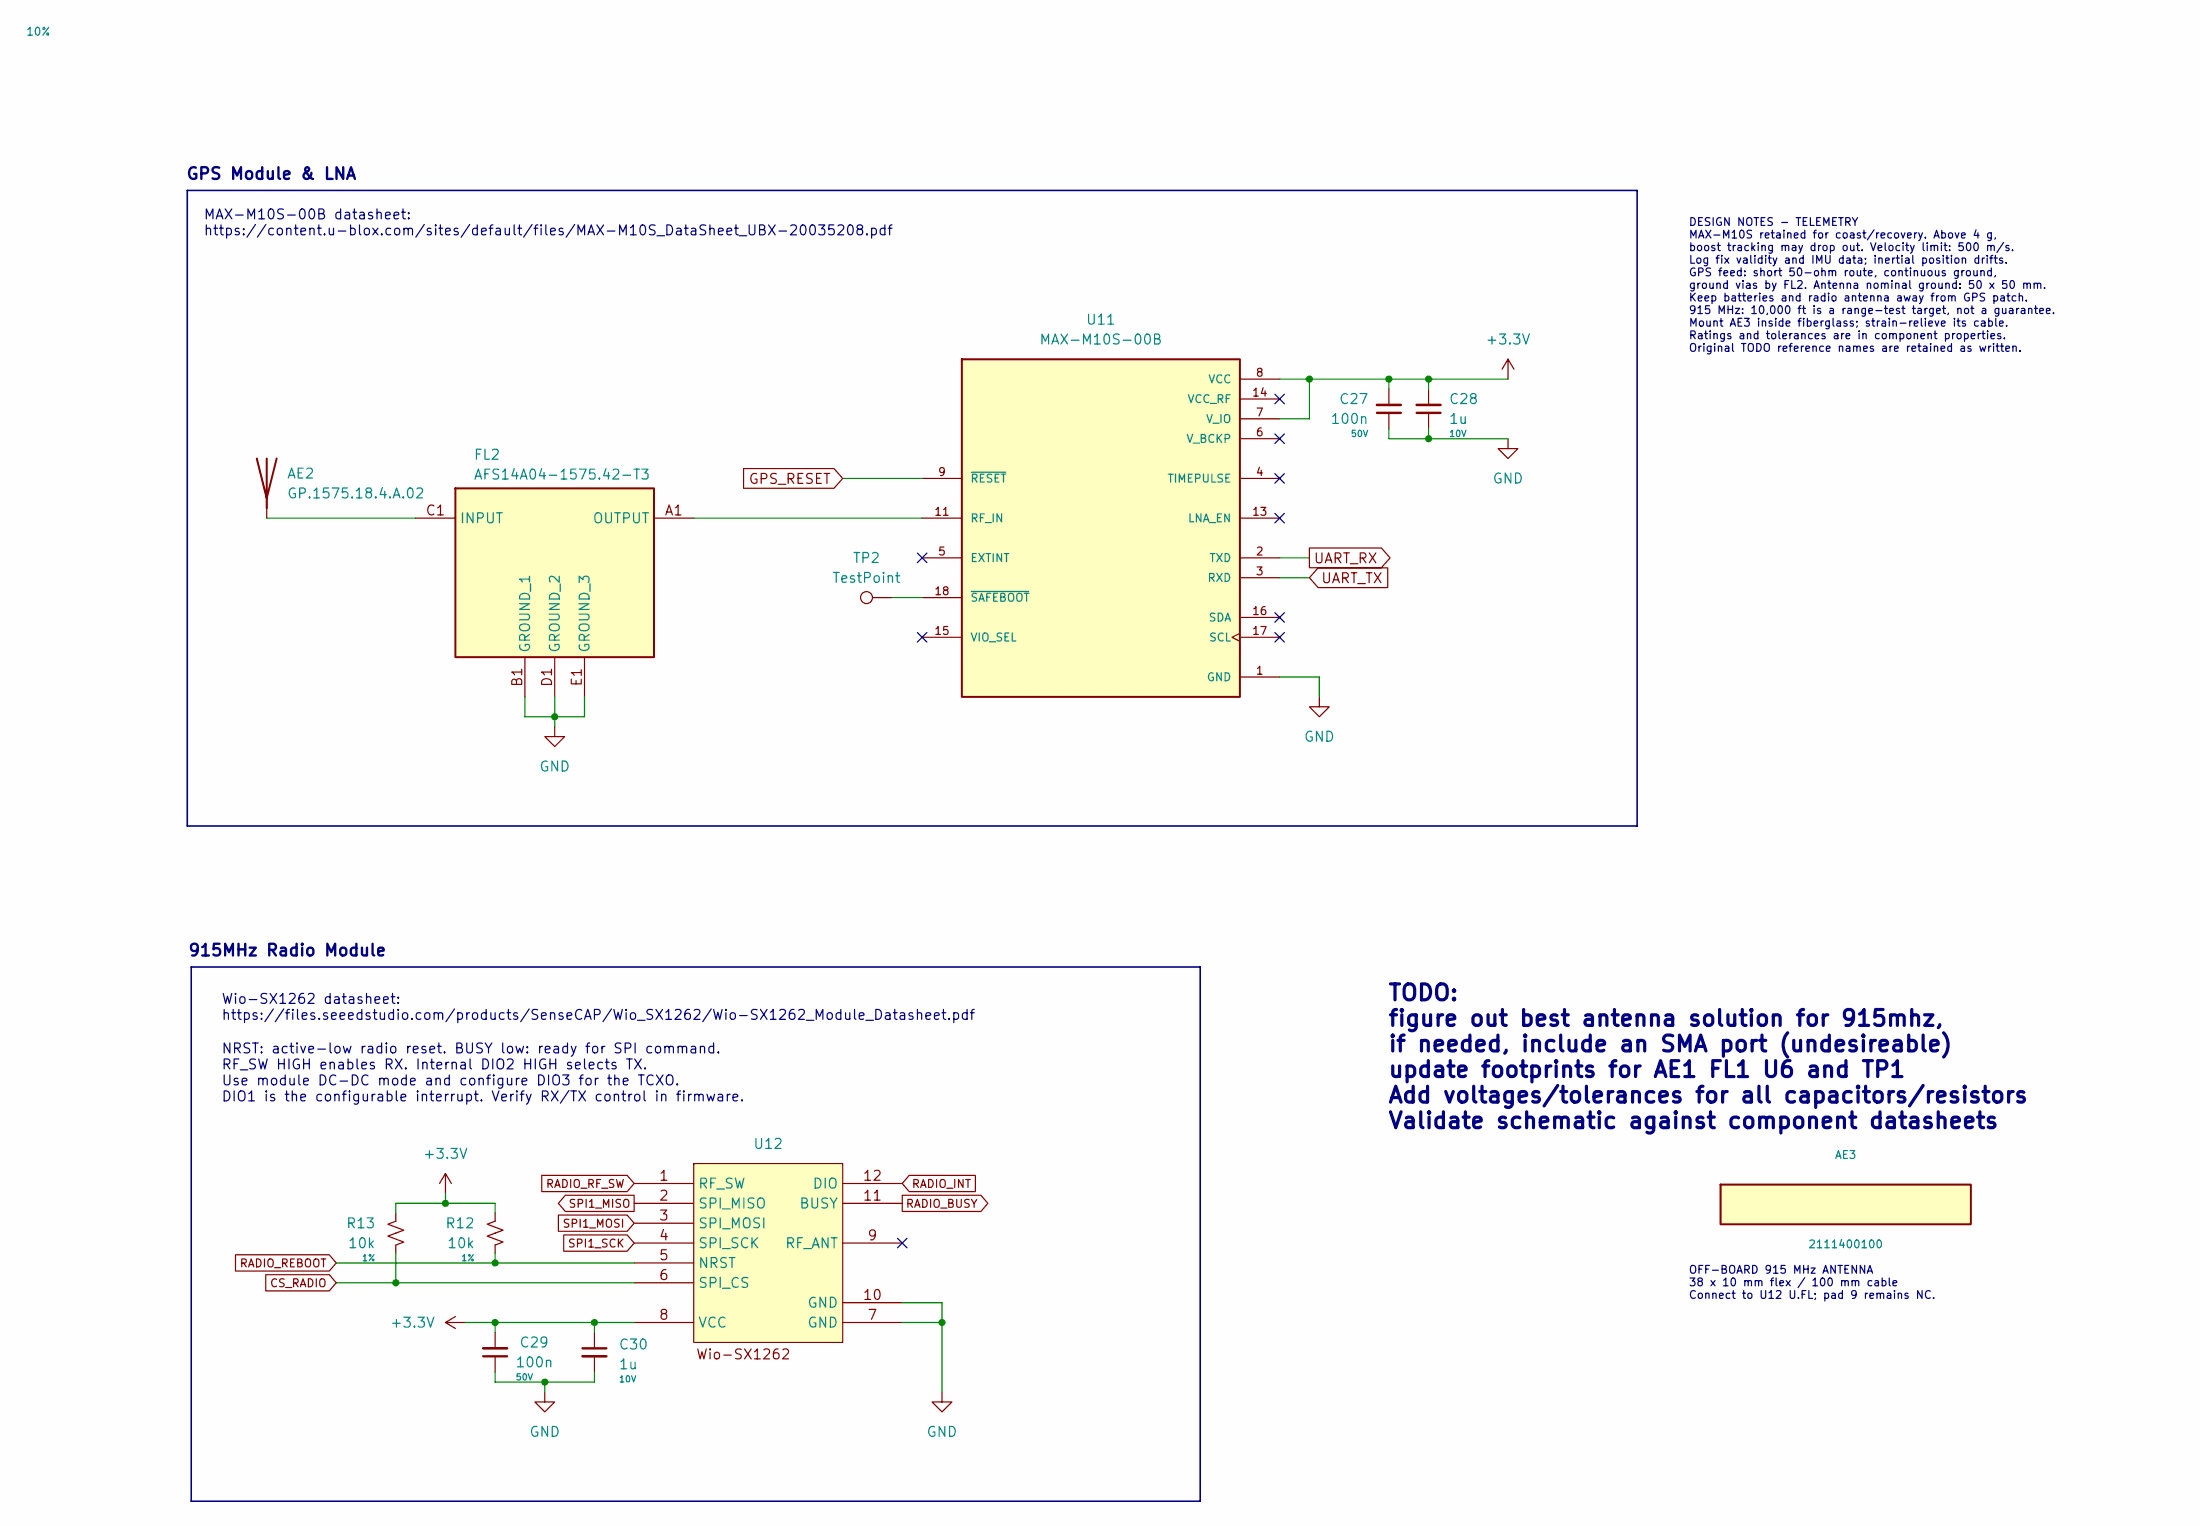
[picture p51: schematic telemetry.kicad_sch]

Parts:
AE2: GP.1575.18.4.A.02; ANT_GP.1575.18.4.A.02_TAL; MPN GP.1575.18.4.A.02
AE3: 2111400100; MPN 2111400100
C27, C29: 100n; C_0603_1608Metric; Tolerance 10%; Voltage 50V; MPN C0603C104K5RACTU
C28, C30: 1u; C_0603_1608Metric; Tolerance 10%; Voltage 10V; MPN C1608X7R1A105K080AC
FL2: AFS14A04-1575.42-T3; AFS14A04157542T3; Mouser Part Number 815-AFS14A04-1575-T3
R12, R13: 10k; R_0603_1608Metric; Tolerance 1%; Voltage 75V; MPN RC0603FR-0710KL
TP2: TestPoint; TestPoint_Pad_D1.0mm
U11: MAX-M10S-00B; XCVR_MAX-M10S-00B; PARTREV C1
U12: Wio-SX1262; WIO-SX1262; MPN 114993390

Connections:
CS_RADIO: R13.1, U12.6 (SPI_CS); also elsewhere on the board
GND: C27.1, C28.1, C29.1, C30.2, FL2.B1 (GROUND_1), FL2.D1 (GROUND_2), FL2.E1 (GROUND_3), U11.1 (GND), U11.10 (GND), U11.12 (GND), U12.7 (GND), U12.10 (GND); also elsewhere on the board
GPS_RESET: U11.9 (~RESET); also elsewhere on the board
unnamed: AE2.1 (A_1), FL2.C1 (INPUT)
unnamed: FL2.A1 (OUTPUT), U11.11 (RF_IN)
unnamed: TP2.1 (1_1), U11.18 (~SAFEBOOT)
RADIO_BUSY: U12.11 (BUSY); also elsewhere on the board
RADIO_INT: U12.12 (DIO); also elsewhere on the board
RADIO_REBOOT: R12.1, U12.5 (NRST); also elsewhere on the board
RADIO_RF_SW: U12.1 (RF_SW); also elsewhere on the board
SPI1_MISO: U12.2 (SPI_MISO); also elsewhere on the board
SPI1_MOSI: U12.3 (SPI_MOSI); also elsewhere on the board
SPI1_SCK: U12.4 (SPI_SCK); also elsewhere on the board
UART_RX: U11.2 (TXD); also elsewhere on the board
UART_TX: U11.3 (RXD); also elsewhere on the board

Notes on the sheet:
DESIGN NOTES - TELEMETRY MAX-M10S retained for coast/recovery. Above 4 g, boost tracking may drop out. Velocity limit: 500 m/s. Log fix validity and IMU data; inertial position drifts. GPS feed: short 50-ohm route, continuous ground, ground vias by FL2. Antenna nominal ground: 50 x 50 mm. Keep batt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
TODO: figure out best antenna solution for 915mhz, if needed, include an SMA port (undesireable) update footprints for AE1 FL1 U6 and TP1 Add voltages/tolerances for all capacitors/resistors Validate schematic against component datasheets
GPS Module & LNA
NRST: active-low radio reset. BUSY low: ready for SPI command. RF_SW HIGH enables RX. Internal DIO2 HIGH selects TX. Use module DC-DC mode and configure DIO3 for the TCXO. DIO1 is the configurable interrupt. Verify RX/TX control in firmware.
Wio-SX1262 datasheet: https://files.seeedstudio.com/products/SenseCAP/Wio_SX1262/Wio-SX1262_Module_Datasheet.pdf
OFF-BOARD 915 MHz ANTENNA 38 x 10 mm flex / 100 mm cable Connect to U12 U.FL; pad 9 remains NC.
MAX-M10S-00B datasheet: https://content.u-blox.com/sites/default/files/MAX-M10S_DataSheet_UBX-20035208.pdf
915MHz Radio Module

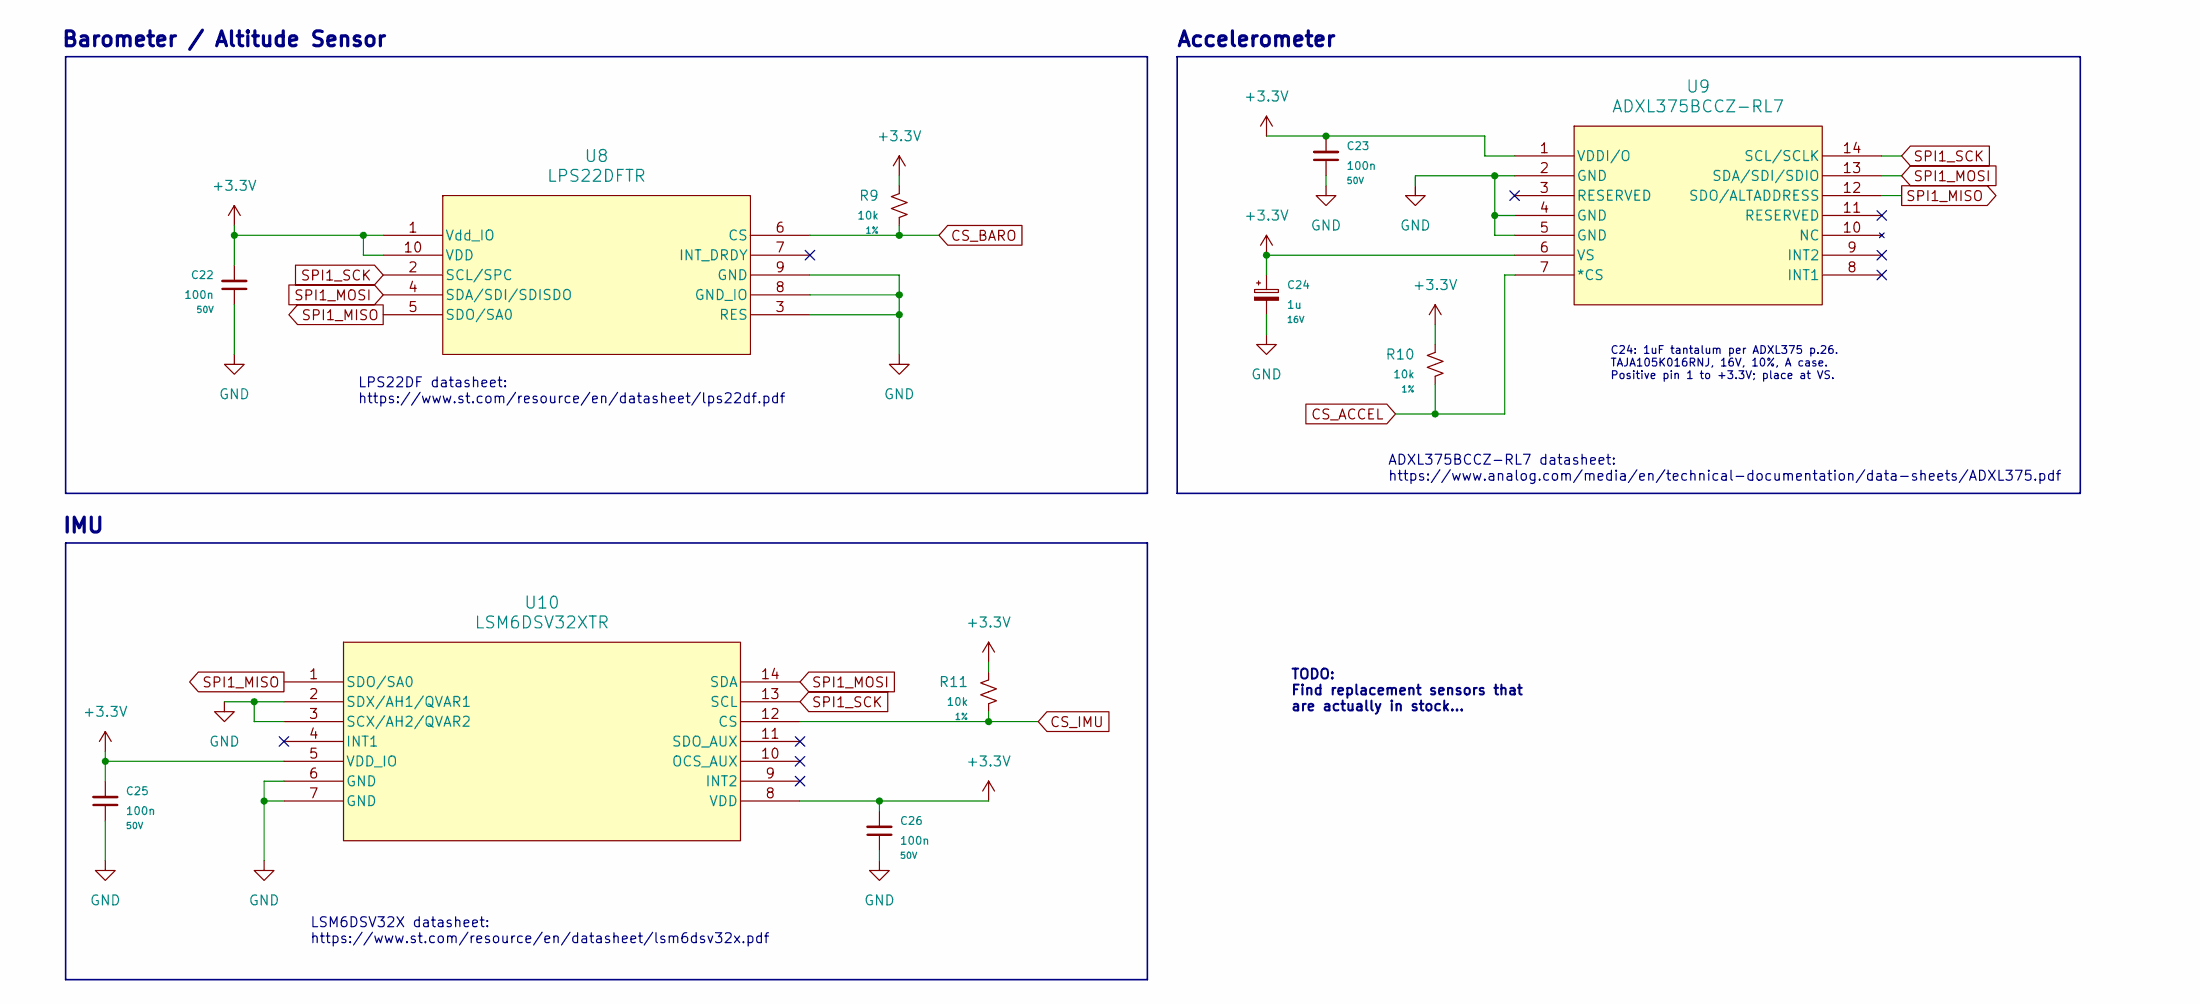
[picture p52: schematic sensors.kicad_sch]

Parts:
C22, C23, C25, C26: 100n; C_0603_1608Metric; Tolerance 10%; Voltage 50V; MPN C0603C104K5RACTU
C24: 1u; TAJA105K016RNJ_3216_18; Tolerance 10%; Voltage 16V; MPN TAJA105K016RNJ
R9, R10, R11: 10k; R_0603_1608Metric; Tolerance 1%; Voltage 75V; MPN RC0603FR-0710KL
U8: LPS22DFTR; QFN_22DFTR_STM; MPN LPS22DFTR
U9: ADXL375BCCZ-RL7; LGA_CC-14-1_ADI; MPN ADXL375BCCZ-RL7
U10: LSM6DSV32XTR; LGA-14L_2p5X3p0X0p86_STM; MPN LSM6DSV32XTR

Connections:
CS_ACCEL: R10.1, U9.7 (*CS); also elsewhere on the board
CS_BARO: R9.1, U8.6 (CS); also elsewhere on the board
CS_IMU: R11.1, U10.12 (CS); also elsewhere on the board
GND: C22.1, C23.1, C24.2, C25.1, C26.1, U8.3 (RES), U8.8 (GND_IO), U8.9 (GND), U9.2 (GND), U9.4 (GND), U9.5 (GND), U10.2 (SDX/AH1/QVAR1), U10.3 (SCX/AH2/QVAR2), U10.6 (GND), U10.7 (GND); also elsewhere on the board
SPI1_MISO: U8.5 (SDO/SA0), U9.12 (SDO/ALTADDRESS), U10.1 (SDO/SA0); also elsewhere on the board
SPI1_MOSI: U8.4 (SDA/SDI/SDISDO), U9.13 (SDA/SDI/SDIO), U10.14 (SDA); also elsewhere on the board
SPI1_SCK: U8.2 (SCL/SPC), U9.14 (SCL/SCLK), U10.13 (SCL); also elsewhere on the board

Notes on the sheet:
C24: 1uF tantalum per ADXL375 p.26. TAJA105K016RNJ, 16V, 10%, A case. Positive pin 1 to +3.3V; place at VS.
IMU
Barometer / Altitude Sensor
LSM6DSV32X datasheet: https://www.st.com/resource/en/datasheet/lsm6dsv32x.pdf
ADXL375BCCZ-RL7 datasheet: https://www.analog.com/media/en/technical-documentation/data-sheets/ADXL375.pdf
Accelerometer
TODO: Find replacement sensors that are actually in stock...
LPS22DF datasheet: https://www.st.com/resource/en/datasheet/lps22df.pdf

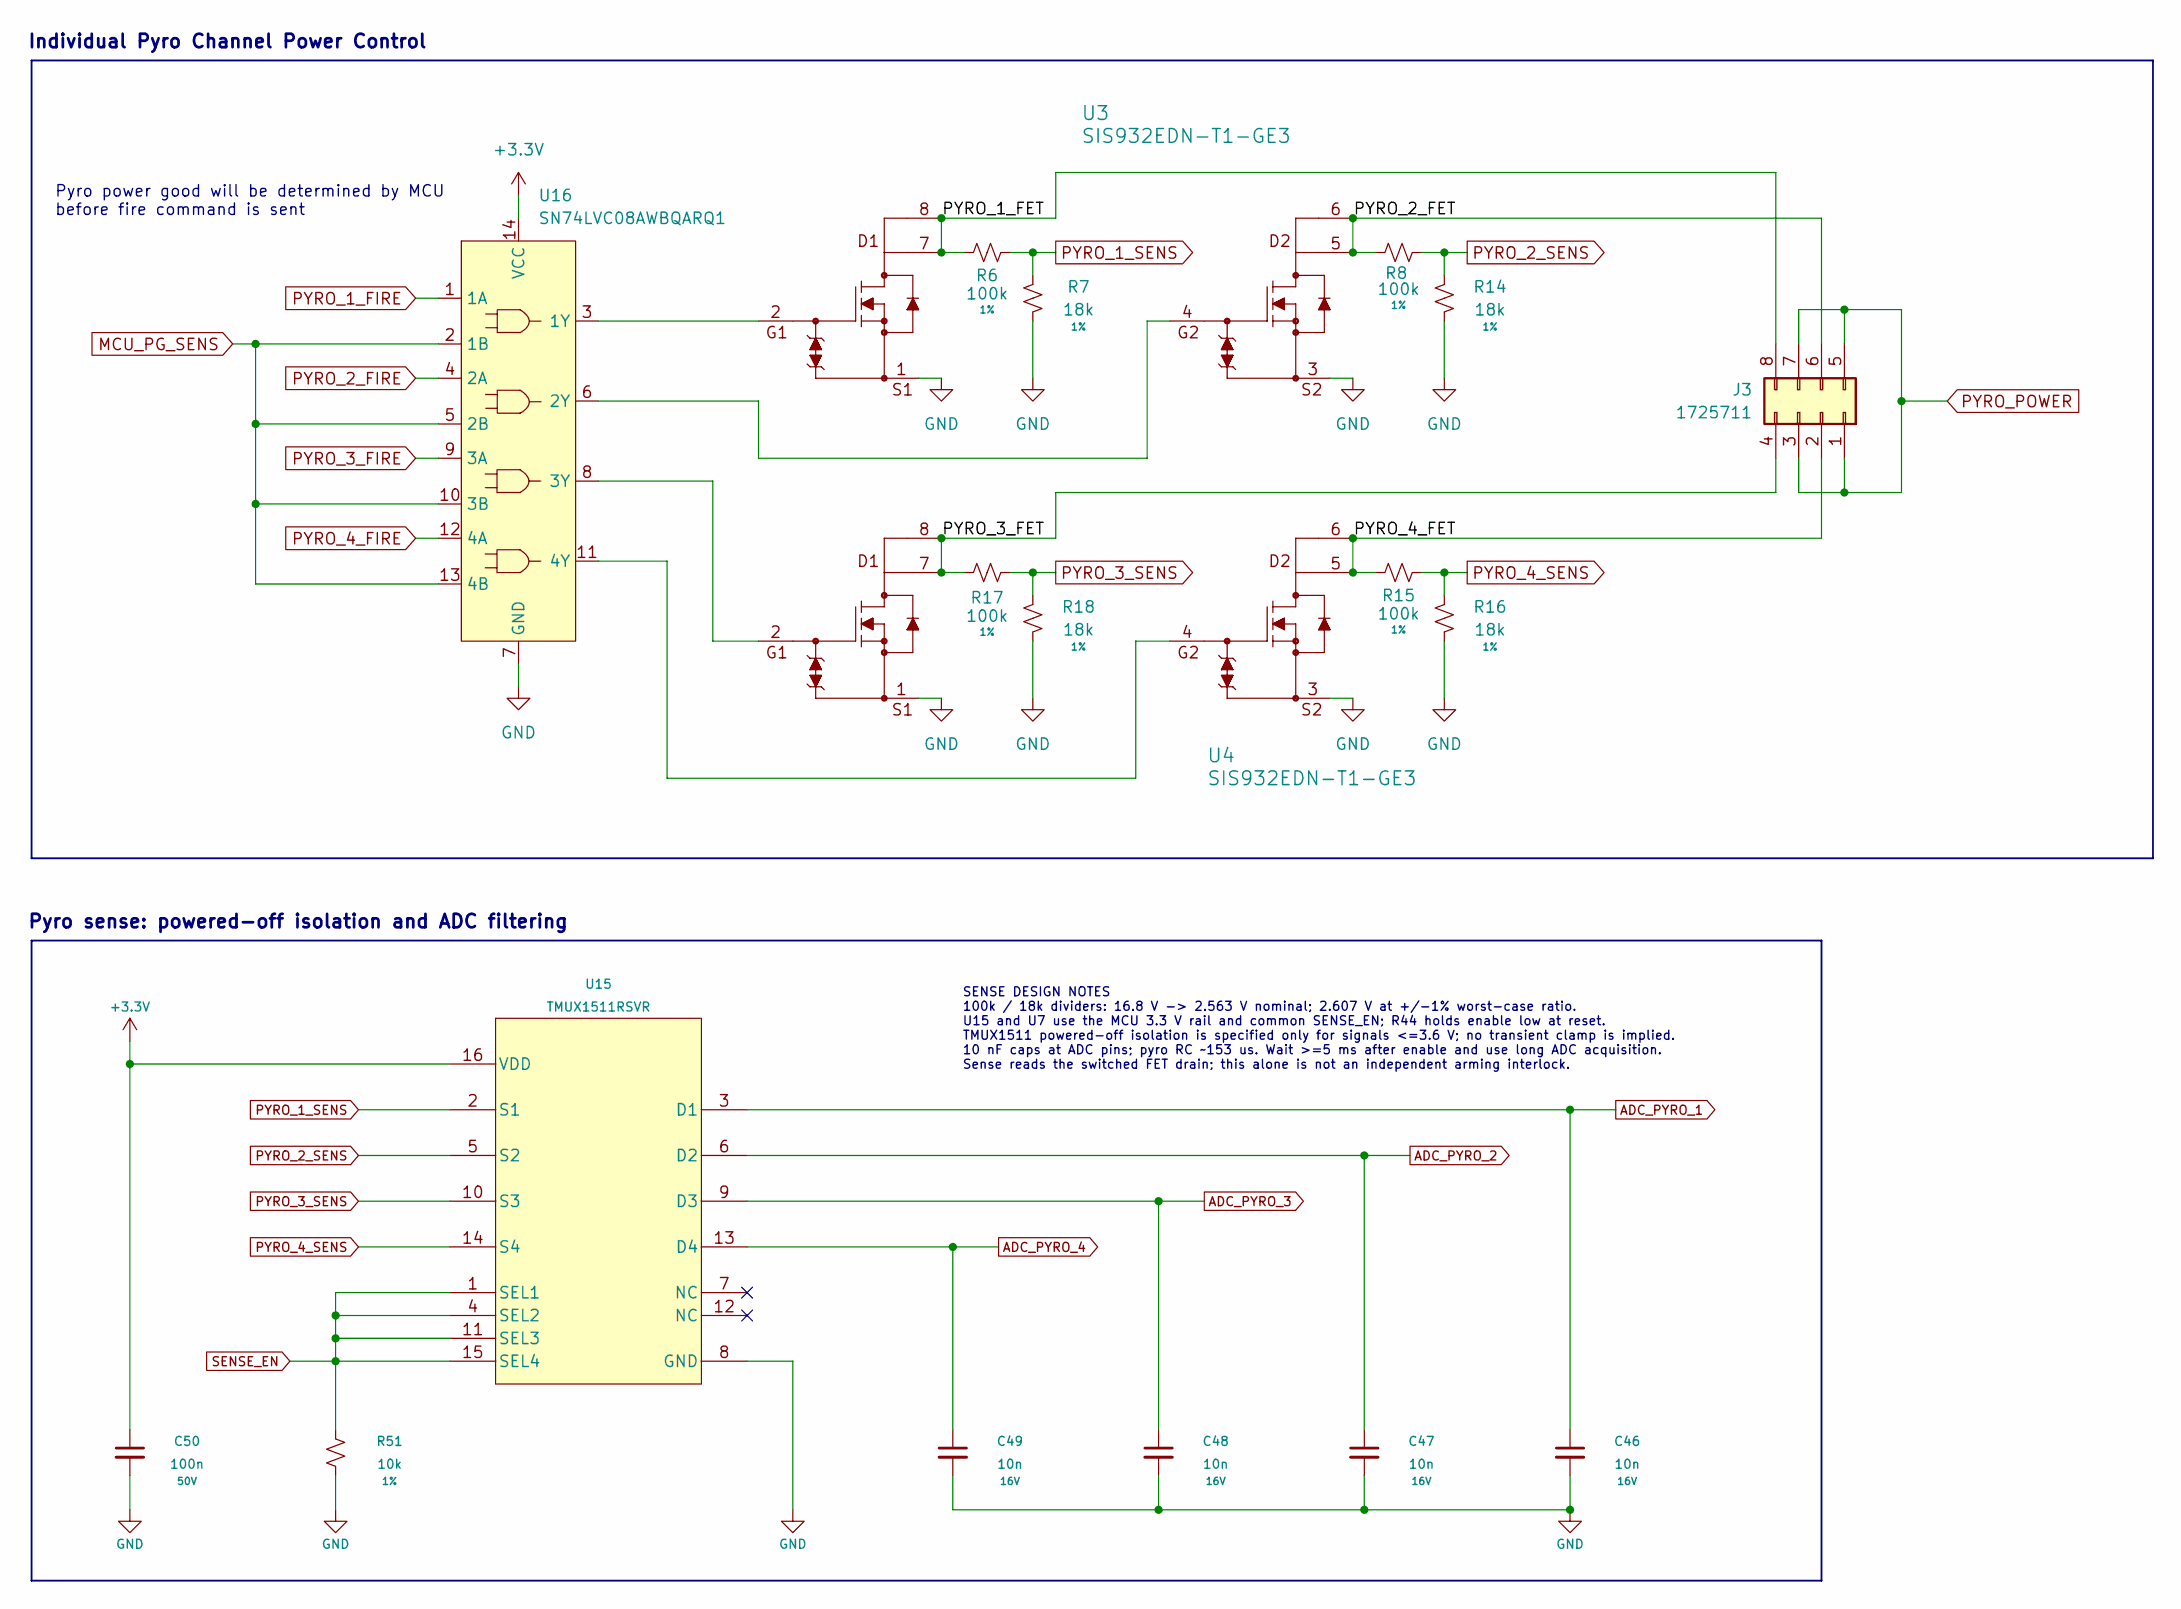
[picture p53: schematic pyro_channels.kicad_sch]

Parts:
C46, C47, C48, C49: 10n; C_0603_1608Metric; Tolerance 10%; Voltage 16V; MPN CC0603KRX7R7BB103
C50: 100n; C_0603_1608Metric; Tolerance 10%; Voltage 50V; MPN C0603C104K5RACTU
J3: 1725711; Phoenix_1725711_MPT_0.5_8_2.54; Current Rating 6A; MPN 1725711; DigiKey Part Number 277-1279-ND
R6, R8, R15, R17: 100k; R_0603_1608Metric; Tolerance 1%; Voltage 75V; MPN RC0603FR-07100KL
R7, R14, R16, R18: 18k; R_0603_1608Metric; Tolerance 1%; Voltage 75V; MPN RC0603FR-0718KL
R51: 10k; R_0603_1608Metric; Tolerance 1%; Voltage 75V; MPN RC0603FR-0710KL
U3, U4: SIS932EDN-T1-GE3; SIS932EDN_PowerPAK1212_8_Dual; MPN SIS932EDN-T1-GE3
U15: TMUX1511RSVR; TMUX1511RSVR_RSV16; MPN TMUX1511RSVR
U16: SN74LVC08AWBQARQ1; SN74LVC08AWBQARQ1_BQA14; MPN SN74LVC08AWBQARQ1

Connections:
/pyro_channels/PYRO_1_FET: J3.8, R6.2, U3.7, U3.8
/pyro_channels/PYRO_2_FET: J3.6, R8.2, U3.5, U3.6
/pyro_channels/PYRO_3_FET: J3.4, R17.2, U4.7, U4.8
/pyro_channels/PYRO_4_FET: J3.2, R15.2, U4.5, U4.6
ADC_PYRO_1: C46.1, U15.3 (D1); also elsewhere on the board
ADC_PYRO_2: C47.1, U15.6 (D2); also elsewhere on the board
ADC_PYRO_3: C48.1, U15.9 (D3); also elsewhere on the board
ADC_PYRO_4: C49.1, U15.13 (D4); also elsewhere on the board
GND: C46.2, C47.2, C48.2, C49.2, C50.2, R7.1, R14.1, R16.1, R18.1, R51.2, U3.1, U3.3, U4.1, U4.3, U15.8 (GND), U16.7 (GND), U16.15 (EP); also elsewhere on the board
MCU_PG_SENS: U16.2 (1B), U16.5 (2B), U16.10 (3B), U16.13 (4B); also elsewhere on the board
unnamed: U3.2, U16.3 (1Y)
unnamed: U3.4, U16.6 (2Y)
unnamed: U4.2, U16.8 (3Y)
unnamed: U4.4, U16.11 (4Y)
PYRO_1_FIRE: U16.1 (1A); also elsewhere on the board
PYRO_1_SENS: R6.1, R7.2, U15.2 (S1)
PYRO_2_FIRE: U16.4 (2A); also elsewhere on the board
PYRO_2_SENS: R8.1, R14.2, U15.5 (S2)
PYRO_3_FIRE: U16.9 (3A); also elsewhere on the board
PYRO_3_SENS: R17.1, R18.2, U15.10 (S3)
PYRO_4_FIRE: U16.12 (4A); also elsewhere on the board
PYRO_4_SENS: R15.1, R16.2, U15.14 (S4)
SENSE_EN: R51.1, U15.1 (SEL1), U15.4 (SEL2), U15.11 (SEL3), U15.15 (SEL4); also elsewhere on the board

Notes on the sheet:
Individual Pyro Channel Power Control
SENSE DESIGN NOTES 100k / 18k dividers: 16.8 V -> 2.563 V nominal; 2.607 V at +/-1% worst-case ratio. U15 and U7 use the MCU 3.3 V rail and common SENSE_EN; R44 holds enable low at reset. TMUX1511 powered-off isolation is specified only for signals <=3.6 V; no transient clamp is implied. 10 nF caps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
Pyro sense: powered-off isolation and ADC filtering
Pyro power good will be determined by MCU before fire command is sent
