luckyowl20/cert_rocket/avionics/avionics_rev1/avionics_rev1.kicad_pcb

## KiCad design avionics/avionics_rev1/avionics_rev1.kicad_pcb (continued)

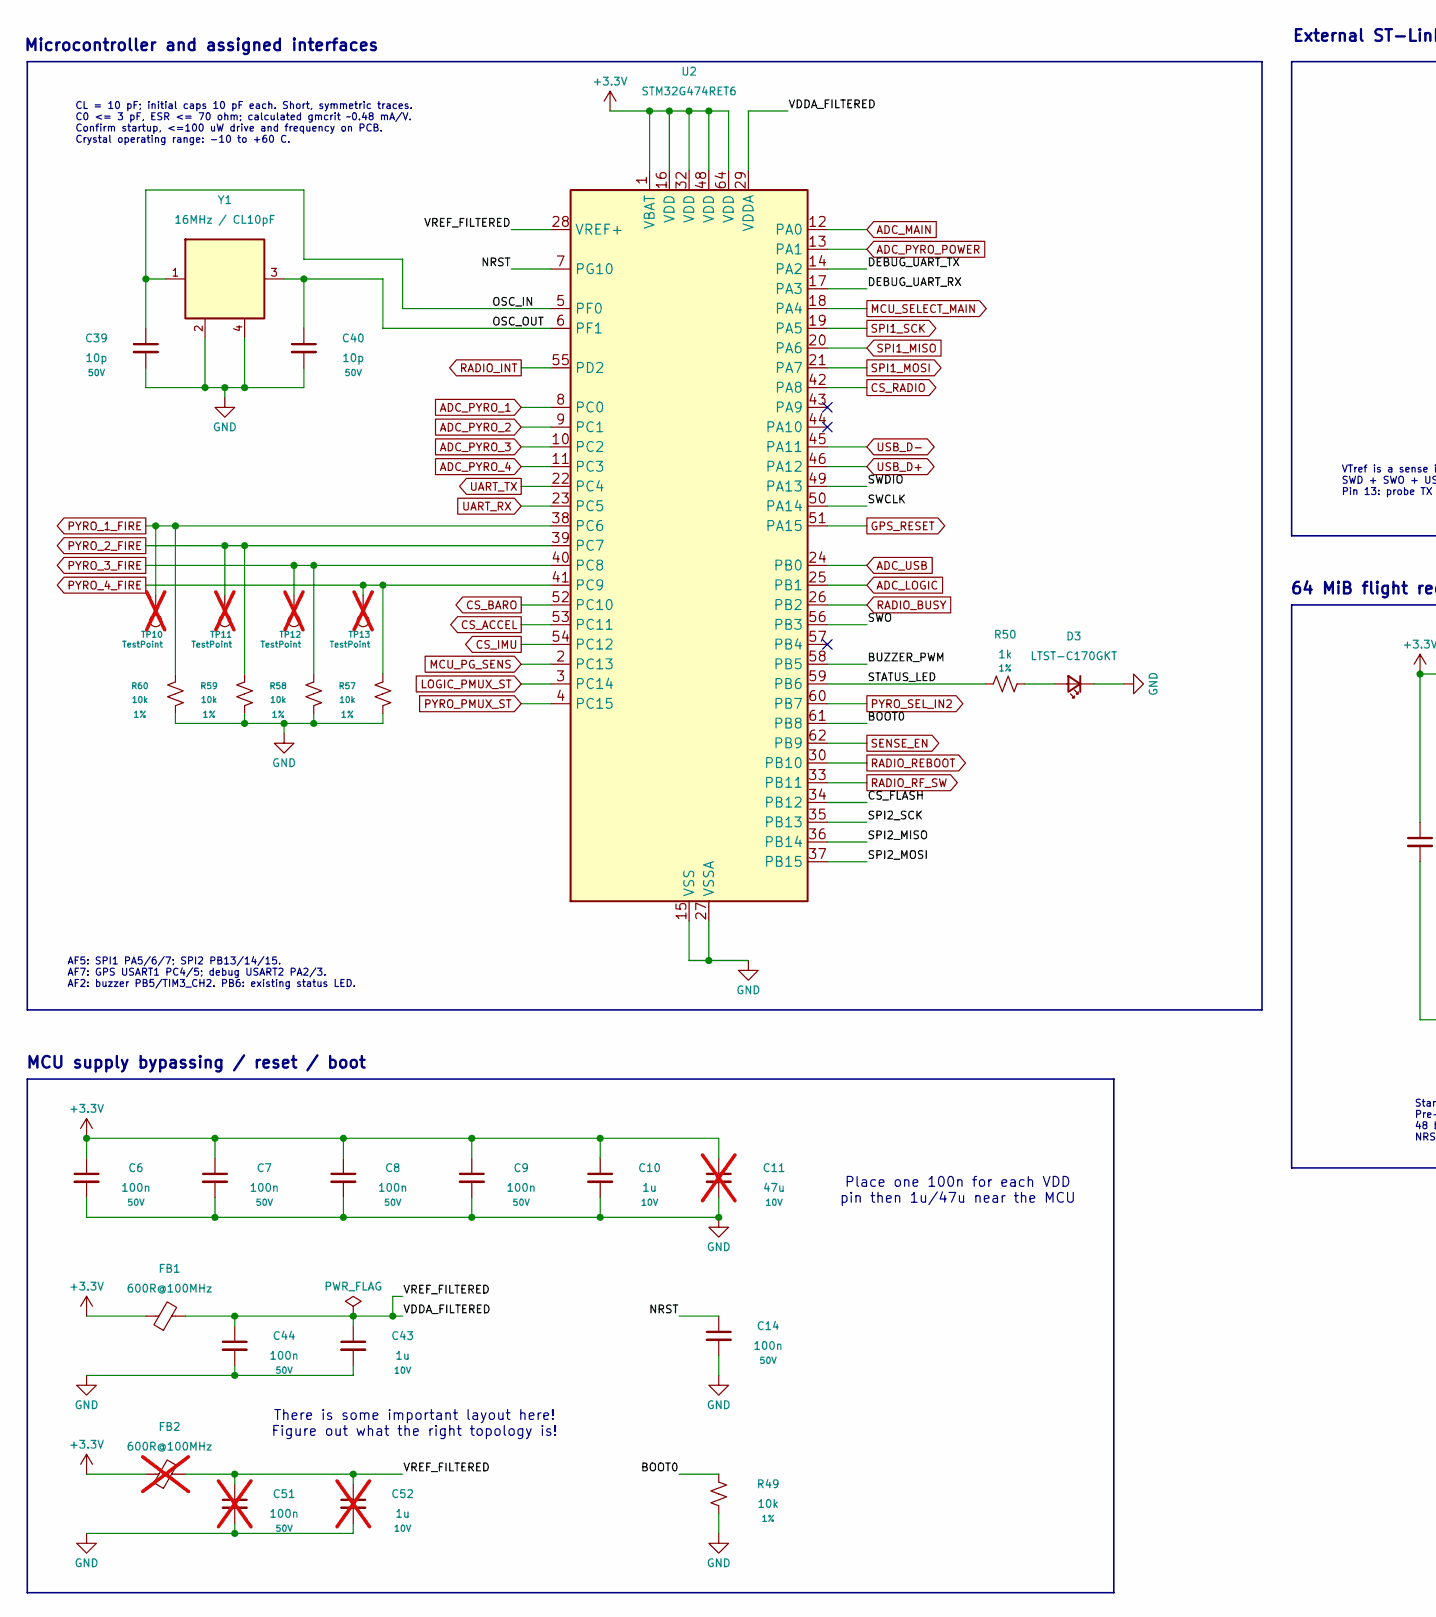
[picture p54: schematic MCU.kicad_sch, part in row 1, column 1]

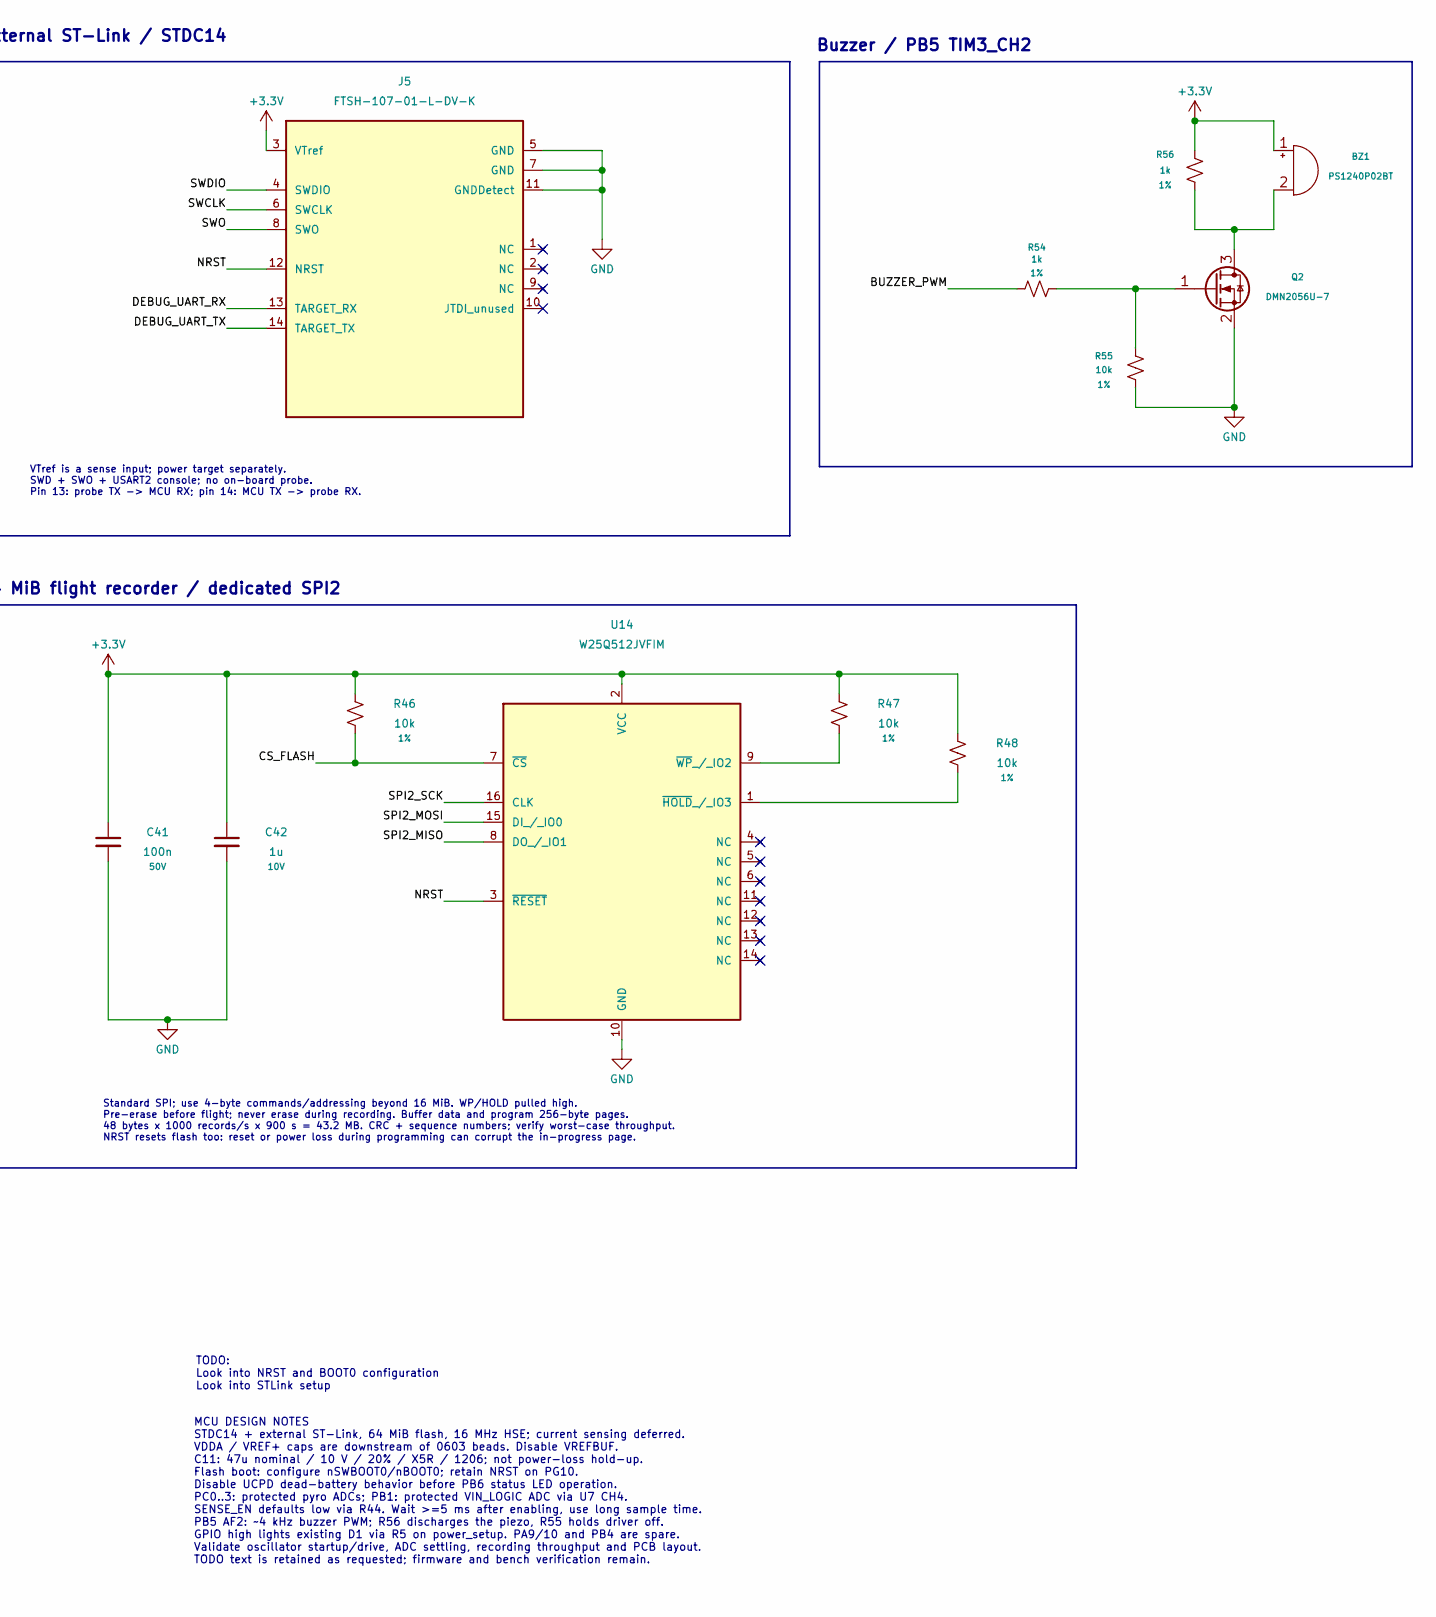
[picture p55: schematic MCU.kicad_sch, part in row 1, column 2]

Parts:
BZ1: PS1240P02BT; XDCR_PS1240P02BT; MPN PS1240P02BT
C6, C7, C8, C9, C14, C41, C44: 100n; C_0603_1608Metric; Tolerance 10%; Voltage 50V; MPN C0603C104K5RACTU
C10, C42, C43: 1u; C_0603_1608Metric; Tolerance 10%; Voltage 10V; MPN C1608X7R1A105K080AC
C11: 47u; C_1206_3216Metric; Tolerance 20%; Voltage 10V; MPN C3216X5R1A476M160AB; not fitted
C39, C40: 10p; C_0603_1608Metric; Tolerance 5%; Voltage 50V; MPN C0603C100J5GACTU
C51: 100n; C_0603_1608Metric; Tolerance 10%; Voltage 50V; MPN C0603C104K5RACTU; not fitted
C52: 1u; C_0603_1608Metric; Tolerance 10%; Voltage 10V; MPN C1608X7R1A105K080AC; not fitted
D3: LTST-C170GKT; LTST_C170GKT_0805; MPN LTST-C170GKT
FB1: 600R@100MHz; L_0603_1608Metric; Impedance tolerance 25%; MPN BLM18AG601SN1D
FB2: 600R@100MHz; L_0603_1608Metric; Impedance tolerance 25%; MPN BLM18AG601SN1D; not fitted
J5: FTSH-107-01-L-DV-K; FTSH-107-01-L-DV-K_STDC14; MPN FTSH-107-01-L-DV-K
Q2: DMN2056U-7; DMN2056U_7_SOT23; MPN DMN2056U-7
R46, R47, R48, R49, R55, R57, R58, R59, R60: 10k; R_0603_1608Metric; Tolerance 1%; Voltage 75V; MPN RC0603FR-0710KL
R50, R54, R56: 1k; R_0603_1608Metric; Tolerance 1%; Voltage 75V; MPN RC0603FR-071KL
TP10, TP11, TP12, TP13: TestPoint; TestPoint_Pad_D1.0mm; not fitted
U2: STM32G474RET6; LQFP-64_10x10mm_P0.5mm; MPN STM32G474RET6
U14: W25Q512JVFIM; W25Q512JVFIM_SOIC16W; MPN W25Q512JVFIM
Y1: 16MHz / CL10pF; ABM8_3.2x2.5mm; MPN ABM8-16.000MHZ-10-1-U-T

Connections:
/MCU/BOOT0: R49.1, U2.61 (PB8)
/MCU/BUZZER_PWM: R54.1, U2.58 (PB5)
/MCU/CS_FLASH: R46.2, U2.34 (PB12), U14.7 (~CS)
/MCU/DEBUG_UART_RX: J5.13 (TARGET_RX), U2.17 (PA3)
/MCU/DEBUG_UART_TX: J5.14 (TARGET_TX), U2.14 (PA2)
/MCU/NRST: C14.1, J5.12 (NRST), U2.7 (PG10), U14.3 (~RESET)
/MCU/OSC_IN: C39.1, U2.5 (PF0), Y1.1 (OSC1)
/MCU/OSC_OUT: C40.1, U2.6 (PF1), Y1.3 (OSC2)
/MCU/SPI2_MISO: U2.36 (PB14), U14.8 (DO_/_IO1)
/MCU/SPI2_MOSI: U2.37 (PB15), U14.15 (DI_/_IO0)
/MCU/SPI2_SCK: U2.35 (PB13), U14.16 (CLK)
/MCU/STATUS_LED: R50.2, U2.59 (PB6)
/MCU/SWCLK: J5.6 (SWCLK), U2.50 (PA14)
/MCU/SWDIO: J5.4 (SWDIO), U2.49 (PA13)
/MCU/SWO: J5.8 (SWO), U2.56 (PB3)
/MCU/VDDA_FILTERED: C43.1, C44.1, C51.1, C52.1, FB1.2, FB2.2, U2.28 (VREF+), U2.29 (VDDA)
ADC_LOGIC: U2.25 (PB1); also elsewhere on the board
ADC_MAIN: U2.12 (PA0); also elsewhere on the board
ADC_PYRO_1: U2.8 (PC0); also elsewhere on the board
ADC_PYRO_2: U2.9 (PC1); also elsewhere on the board
ADC_PYRO_3: U2.10 (PC2); also elsewhere on the board
ADC_PYRO_4: U2.11 (PC3); also elsewhere on the board
ADC_PYRO_POWER: U2.13 (PA1); also elsewhere on the board
ADC_USB: U2.24 (PB0); also elsewhere on the board
CS_ACCEL: U2.53 (PC11); also elsewhere on the board
CS_BARO: U2.52 (PC10); also elsewhere on the board
CS_IMU: U2.54 (PC12); also elsewhere on the board
CS_RADIO: U2.42 (PA8); also elsewhere on the board
GND: C6.2, C7.2, C8.2, C9.2, C10.2, C11.2, C14.2, C39.2, C40.2, C41.2, C42.2, C43.2, C44.2, C51.2, C52.2, D3.1 (K), J5.5 (GND), J5.7 (GND), J5.11 (GNDDetect), Q2.2 (S), R49.2, R55.2, R57.2, R58.2, R59.2, R60.2, U2.15 (VSS), U2.27 (VSSA), U2.31 (VSS), U2.47 (VSS), U2.63 (VSS), U14.10 (GND), Y1.2 (CASE), Y1.4 (CASE); also elsewhere on the board
GPS_RESET: U2.51 (PA15); also elsewhere on the board
LOGIC_PMUX_ST: U2.3 (PC14); also elsewhere on the board
MCU_PG_SENS: U2.2 (PC13); also elsewhere on the board
MCU_SELECT_MAIN: U2.18 (PA4); also elsewhere on the board
unnamed: BZ1.2 (-), Q2.3 (D), R56.2
unnamed: D3.2 (A), R50.1
unnamed: Q2.1 (G), R54.2, R55.1
unnamed: R48.2, U14.1 (~HOLD_/_IO3)
unnamed: R47.2, U14.9 (~WP_/_IO2)
PYRO_1_FIRE: R60.1, TP10.1, U2.38 (PC6); also elsewhere on the board
PYRO_2_FIRE: R59.1, TP11.1, U2.39 (PC7); also elsewhere on the board
PYRO_3_FIRE: R58.1, TP12.1, U2.40 (PC8); also elsewhere on the board
PYRO_4_FIRE: R57.1, TP13.1, U2.41 (PC9); also elsewhere on the board
PYRO_PMUX_ST: U2.4 (PC15); also elsewhere on the board
PYRO_SEL_IN2: U2.60 (PB7); also elsewhere on the board
RADIO_BUSY: U2.26 (PB2); also elsewhere on the board
RADIO_INT: U2.55 (PD2); also elsewhere on the board
RADIO_REBOOT: U2.30 (PB10); also elsewhere on the board
RADIO_RF_SW: U2.33 (PB11); also elsewhere on the board
SENSE_EN: U2.62 (PB9); also elsewhere on the board
SPI1_MISO: U2.20 (PA6); also elsewhere on the board
SPI1_MOSI: U2.21 (PA7); also elsewhere on the board
SPI1_SCK: U2.19 (PA5); also elsewhere on the board
UART_RX: U2.23 (PC5); also elsewhere on the board
UART_TX: U2.22 (PC4); also elsewhere on the board
USB_D+: U2.46 (PA12); also elsewhere on the board
USB_D-: U2.45 (PA11); also elsewhere on the board

Notes on the sheet:
AF5: SPI1 PA5/6/7; SPI2 PB13/14/15. AF7: GPS USART1 PC4/5; debug USART2 PA2/3. AF2: buzzer PB5/TIM3_CH2. PB6: existing status LED.
Place one 100n for each VDD pin then 1u/47u near the MCU
CL = 10 pF; initial caps 10 pF each. Short, symmetric traces. C0 <= 3 pF, ESR <= 70 ohm; calculated gmcrit ~0.48 mA/V. Confirm startup, <=100 uW drive and frequency on PCB. Crystal operating range: -10 to +60 C.
MCU supply bypassing / reset / boot
MCU DESIGN NOTES STDC14 + external ST-Link, 64 MiB flash, 16 MHz HSE; current sensing deferred. VDDA / VREF+ caps are downstream of 0603 beads. Disable VREFBUF. C11: 47u nominal / 10 V / 20% / X5R / 1206; not power-loss hold-up. Flash boot: configure nSWBOOT0/nBOOT0; retain NRST on PG10. Disable UC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
Standard SPI; use 4-byte commands/addressing beyond 16 MiB. WP/HOLD pulled high. Pre-erase before flight; never erase during recording. Buffer data and program 256-byte pages. 48 bytes x 1000 records/s x 900 s = 43.2 MB. CRC + sequence numbers; verify worst-case throughput. NRST resets flash too: r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
External ST-Link / STDC14
TODO: Look into NRST and BOOT0 configuration Look into STLink setup
Microcontroller and assigned interfaces
VTref is a sense input; power target separately. SWD + SWO + USART2 console; no on-board probe. Pin 13: probe TX -> MCU RX; pin 14: MCU TX -> probe RX.
There is some important layout here! Figure out what the right topology is!
Buzzer / PB5 TIM3_CH2
64 MiB flight recorder / dedicated SPI2

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
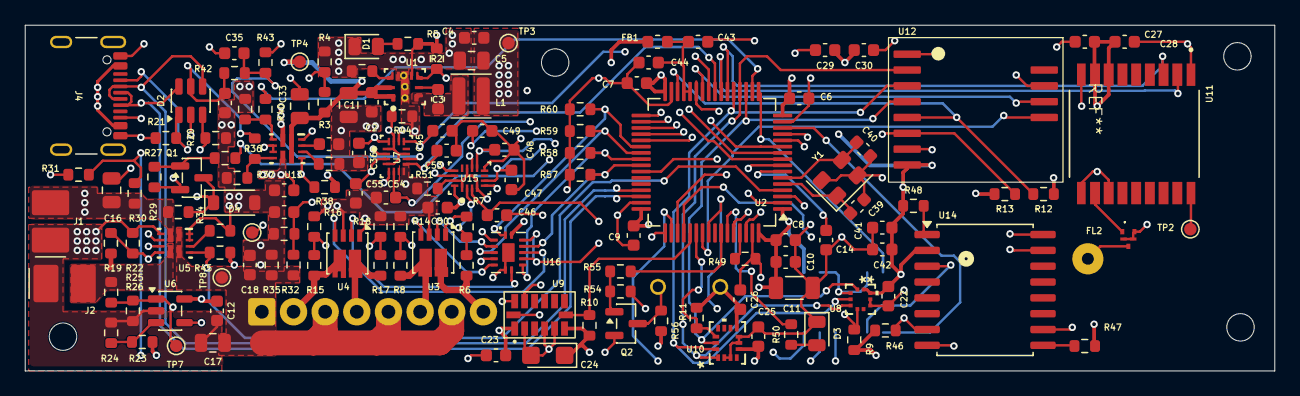
[picture p56: board avionics_rev1.kicad_pcb from above]

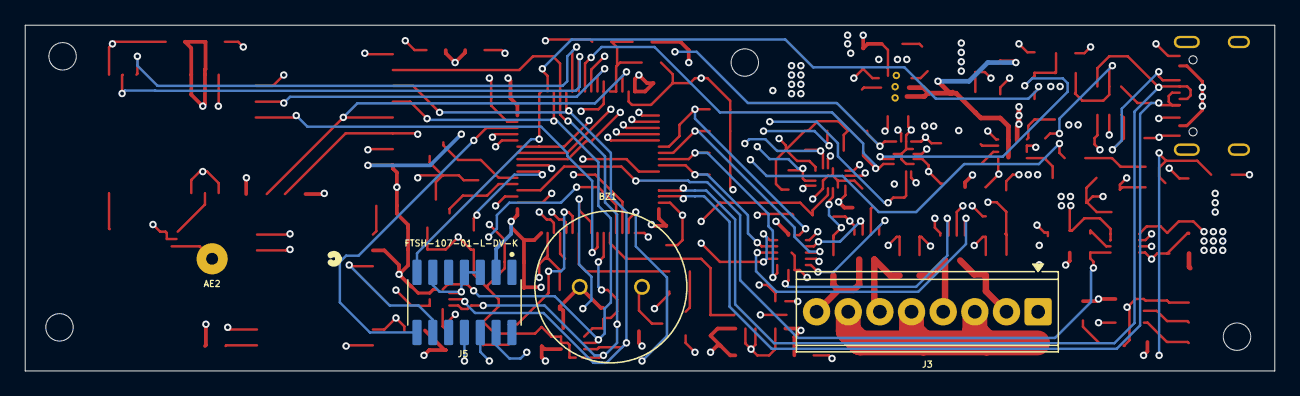
[picture p57: board avionics_rev1.kicad_pcb from below]

Board: 4 copper layers, 100.3 x 27.7 mm, 148 parts (4 on the bottom side), 97 nets.
