luckyowl20/cert_rocket/(commit log)

2026-06-19 flight computer schematics work + 1 stage simulation
    [AFS14A04-1575.42-T3.SchLib, AFS14A04-1575.42-T3.stp, AFS14A04157542T3.PcbLib, EDI2CAP.CFG, GPS.kicad_sch, IMU.kicad_sch, LGA-14L_2p5X3p0X0p86_STM.step, MAX-M10S-00B.step]
2026-06-30 more avionics work
    [GPS.kicad_sch, IMU.kicad_sch, MCU.kicad_sch, PS1240P02BT.step, Radio.kicad_sch, accelerometer.kicad_sch, avionics_rev1.kicad_pcb, avionics_rev1.kicad_sch]
2026-09-10 latest work
    [avionics_rev1.kicad_pcb, sensors.kicad_sch, telemetry.kicad_sch]
2026-09-24 saving work before chat
    [MCU.kicad_sch, RSV0016A.stp, RUX0012A.stp, avionics_rev1.kicad_sch, power_setup.kicad_sch, pyro_channels.kicad_sch, sensors.kicad_sch, telemetry.kicad_sch]
2026-09-24 chat cleanup of schematic
    [MCU.kicad_sch, avionics_rev1.kicad_sch, logic_mux_block.kicad_sch, power_setup.kicad_sch, pyro_channels.kicad_sch, sensors.kicad_sch, telemetry.kicad_sch, tmux_harness.kicad_sch]
2026-09-24 working on sensors schematics
    [D_SOD-123.step, LED_0805_2012Metric.step, MCU.kicad_sch, RAK0009A.stp, RSV0016A.stp, RUX0012A.stp, SOT-23-5.step, SOT-23-6.step]
2026-09-24 updated sensors schematic footprints
    [CP_EIA-3216-18_Kemet-A.step, LGA-14L_2p5X3p0X0p86_STM.step, LGA_CC-14-1_ADI.step, MCU.kicad_sch, QFN_22DFTR_STM.step, avionics_rev1.kicad_sch, inspection.kicad_pcb, power_setup.kicad_sch]
2026-09-24 saving MCU work before using codex
    [MCU.kicad_sch]
2026-09-24 cleaned up schematics after codex work
    [MCU.kicad_sch, avionics_rev1.kicad_sch, power_setup.kicad_sch, pyro_channels.kicad_sch, sensors.kicad_sch, telemetry.kicad_sch]
2026-09-25 fixed ERC errors
    [AFS14A04-1575.42-T3.stp, MAX-M10S-00B.step, MCU.kicad_sch, Wio-SX1262.step, power_setup.kicad_sch, pyro_channels.kicad_sch, sensors.kicad_sch, telemetry.kicad_sch]
2026-09-28 added component tolerances to schematic
    [MCU.kicad_sch, power_setup.kicad_sch, pyro_channels.kicad_sch, sensors.kicad_sch, telemetry.kicad_sch]
2026-10-02 adjusted resistor footprints to 0603
    [MCU.kicad_sch, power_setup.kicad_sch, pyro_channels.kicad_sch, sensors.kicad_sch, telemetry.kicad_sch]
2026-10-02 finished updating footprints
    [BQA0014B.stp, MCU.kicad_sch, Phoenix_1725711.step, power_setup.kicad_sch, pyro_channels.kicad_sch, sensors.kicad_sch, telemetry.kicad_sch]
2026-10-02 updated todos
    [sensors.kicad_sch]
