luckyowl20/cert_rocket/(notices)

Notices in the files:
avionics/avionics_rev1/footprint_3D_models/LED_0805_2012Metric.step:
Copyright (C) 2018, kicad StepUp
This work is licensed under the [Creative Commons CC-BY-SA 4.0 License](https://creativecommons.org/licenses/by-sa/4.0/legalcode),
with the following exception:
To the extent that the creation of electronic designs that use 'Licensed Material' can be considered to be 'Adapted Material',
You are free to use the library data in your own projects without the obligation to share your project files under this or any other license agreement.
avionics/avionics_rev1/footprint_3D_models/CP_EIA-3216-18_Kemet-A.step:
Copyright (C) 2017, kicad StepUp
avionics/avionics_rev1/footprint_3D_models/SOT-23-6.step:
Copyright (C) 2025, KiCAD
This work is licensed under the
[Creative Commons CC-BY-SA 4.0 License](https://creativecommons.org/licenses/by-sa/4.0/legalcode),
project files under this or any other license agreement. However, if you wish to distribute
avionics/avionics_rev1/footprint_3D_models/Phoenix_1725711.step:
Copyright (C) 2026, KiCAD
